ZackHarrington/PCB-Projects/Billy-Bass-Board/Documentation/DC_motor_circuits_notes_2up.pdf

# Basic DC Motor Circuits

Living with the Lab
Gerald Recktenwald
Portland State University
gerry@pdx.edu
LWTL: DC Motor | 2

### DC Motor Learning Objectives

- Explain the role of a snubber diode
- Describe how PWM controls DC motor speed
- Implement a transistor circuit and Arduino program for PWM control of the DC motor
- Use a potentiometer as input to a program that controls fan speed

What is a snubber diode
and why should I care?

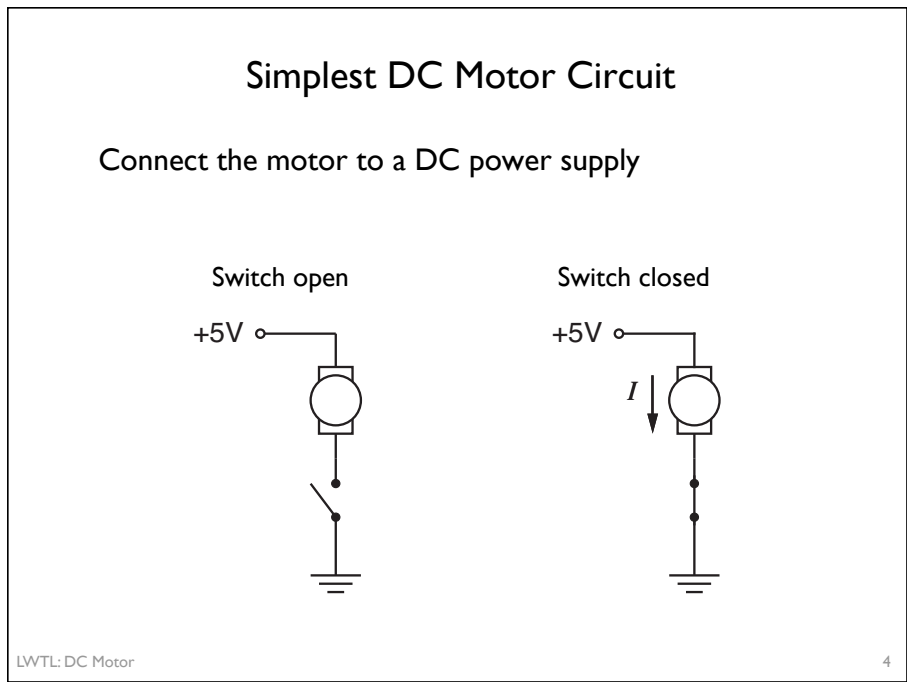
[picture p16: figure]
LWTL: DC Motor; Simplest DC Motor Circuit; Connect the motor to a DC power supply; Switch open; Switch closed

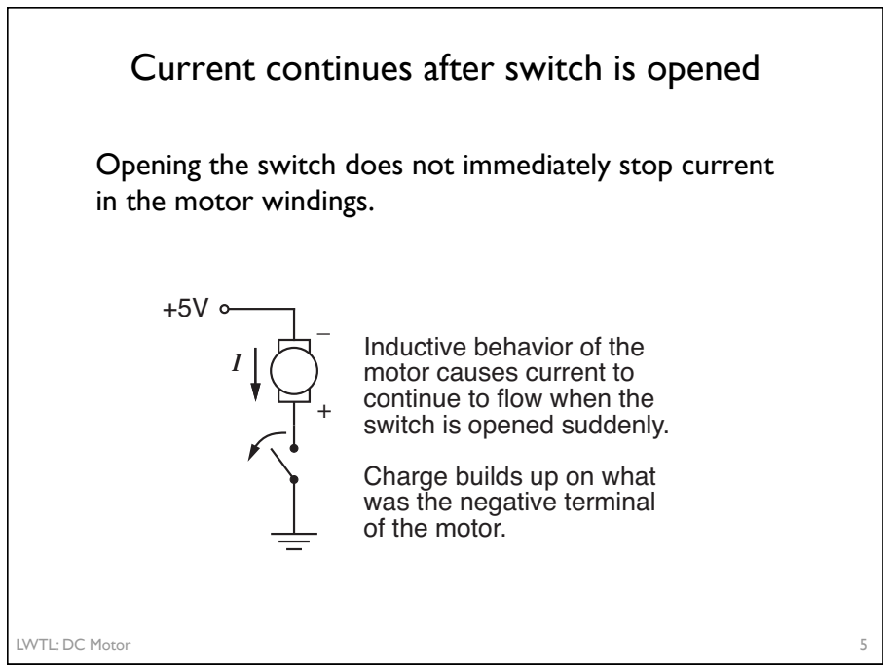
[picture p17: figure]
LWTL: DC Motor; in the motor windings.; – Inductive behavior of the motor causes current to continue to flow when the switch is opened suddenly. Charge builds up on what was the negative terminal of the motor.

### Current continues after switch is opened

Opening the switch does not immediately stop current

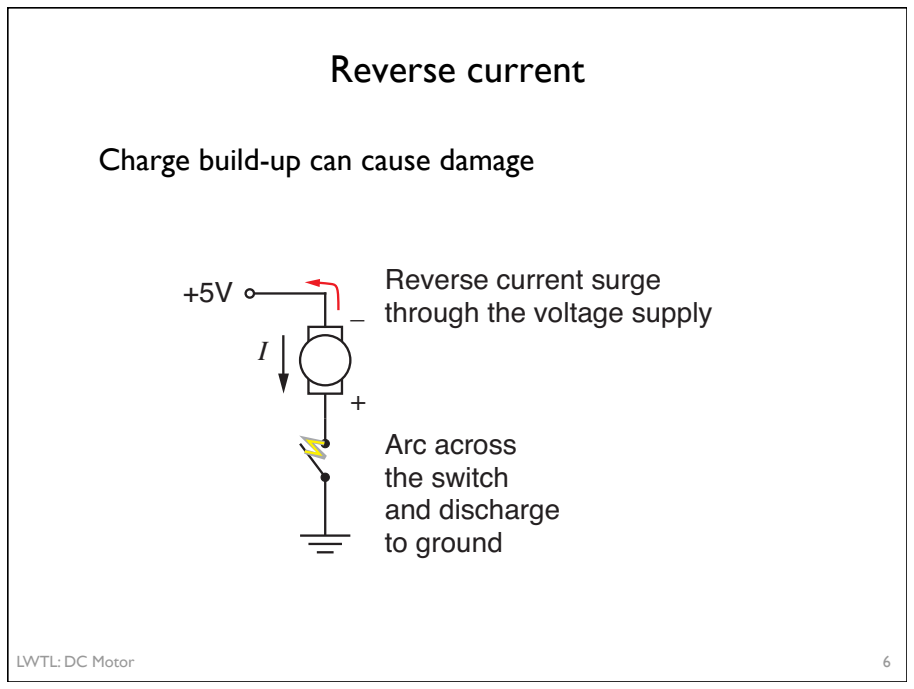
[picture p18: figure]
LWTL: DC Motor; Reverse current; Charge build-up can cause damage; Arc across the switch and discharge to ground; Reverse current surge through the voltage supply

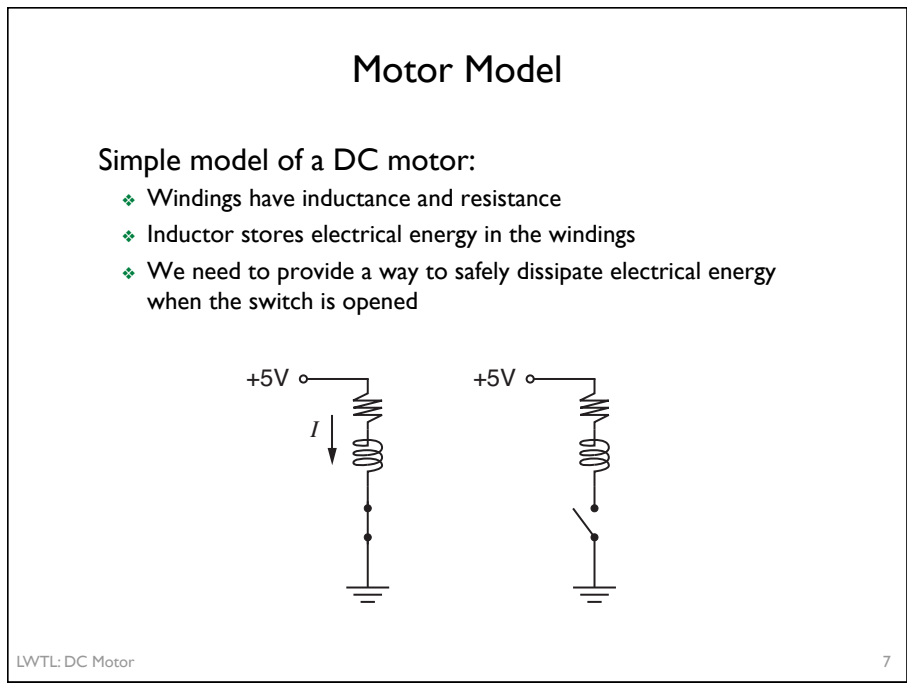
[picture p19: figure]
LWTL: DC Motor; Motor Model; Simple model of a DC motor:; when the switch is opened

❖ Windings have inductance and resistance
❖ Inductor stores electrical energy in the windings
❖ We need to provide a way to safely dissipate electrical energy

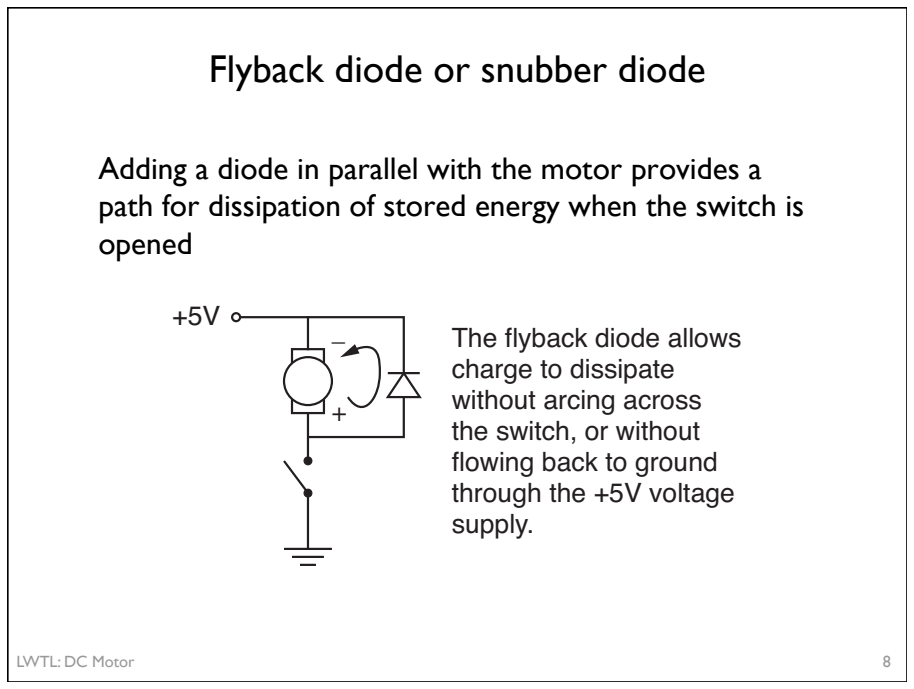
[picture p20: figure]
LWTL: DC Motor; Flyback diode or snubber diode; opened; The flyback diode allows charge to dissipate without arcing across the switch, or without flowing back to ground through the +5V voltage supply.

Adding a diode in parallel with the motor provides a path for dissipation of stored energy when the switch is

Pulse-width modulation (PWM) for DC motor speed control

LWTL: DC Motor | 10

### Controlling DC Motor Speed

The voltage supplied to a DC motor controls its speed

Arduino cannot supply variable DC output
❖ Arduino lacks a true analog output
❖ Use Pulse-width modulation (PWM) to simulate a variable DC supply voltage
❖ PWM is a common technique for supplying variable power levels to “slow” electrical devices such as resistive loads, LEDs, and DC motors
❖ Arduino Uno has 6 PWM pins: Digital I/O pins 3, 5, 6, 9,10, and 11

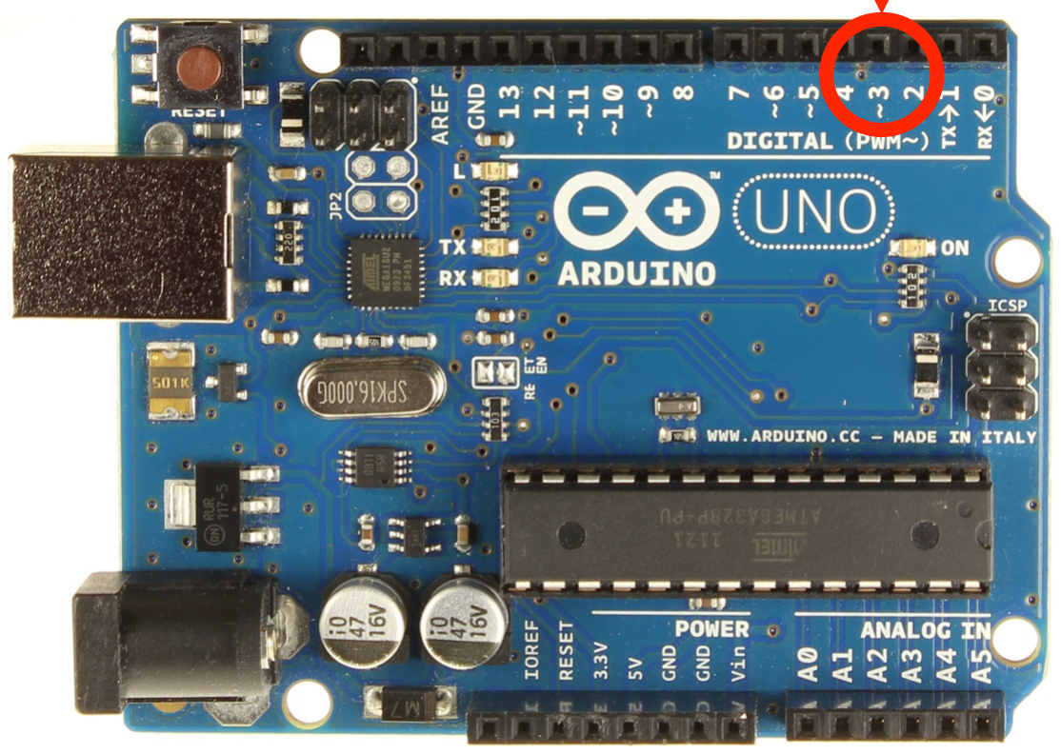
[picture p21: figure]

LWTL: DC Motor | 11

### Arduno Uno has 6 PWM pins

Look for the ~ prefix on the digital pin label, e.g. ~3

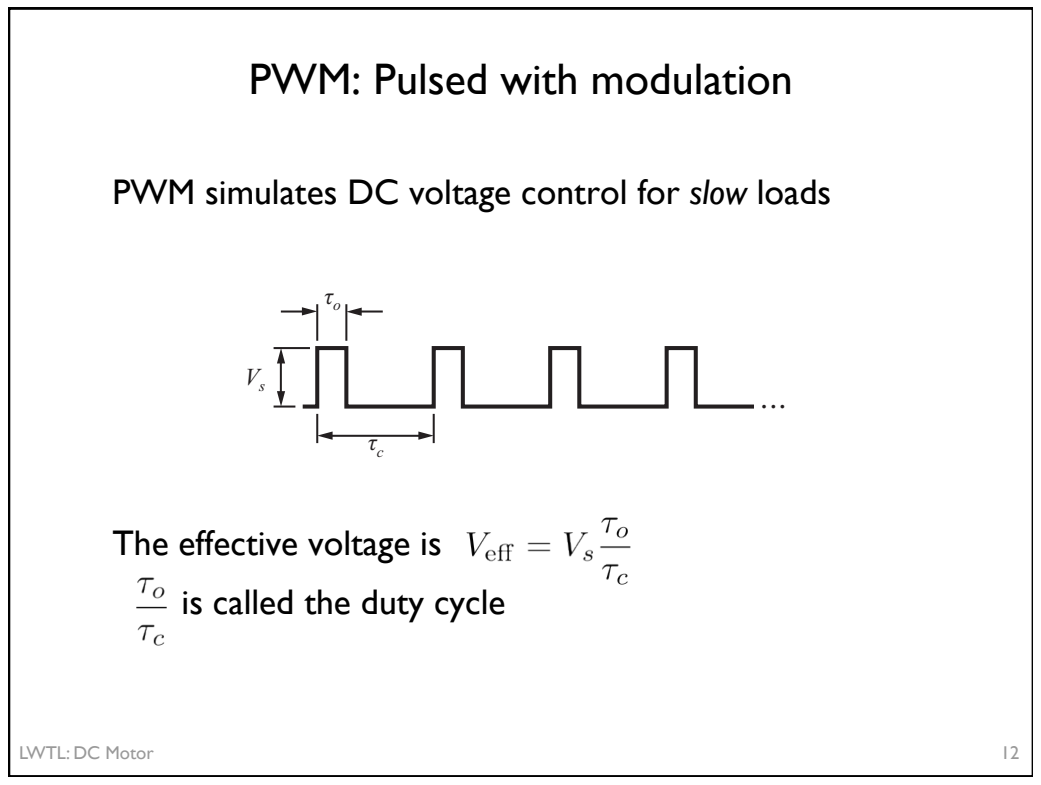
[picture p22: figure]
LWTL: DC Motor; PWM: Pulsed with modulation; The effective voltage is is called the duty cycle

PWM simulates DC voltage control for slow loads

LWTL: DC Motor | 13

### Arduino PWM commands

Configure the output pin:

Set the duty cycle

The duty cycle is an 8 bit value:
0 ≤ duty_cycle ≤255
PWM_pin = ... ; | // | one of 3, 5, 6, 9, 10, 11

void setup() {
pinMode( PWM_pin, OUTPUT);
}

void loop() {
int duty_cycle = 150; | // | between 0 and 255

analogWrite( PWM_pin, duty_cycle );
}

Using a transistor to switch the load

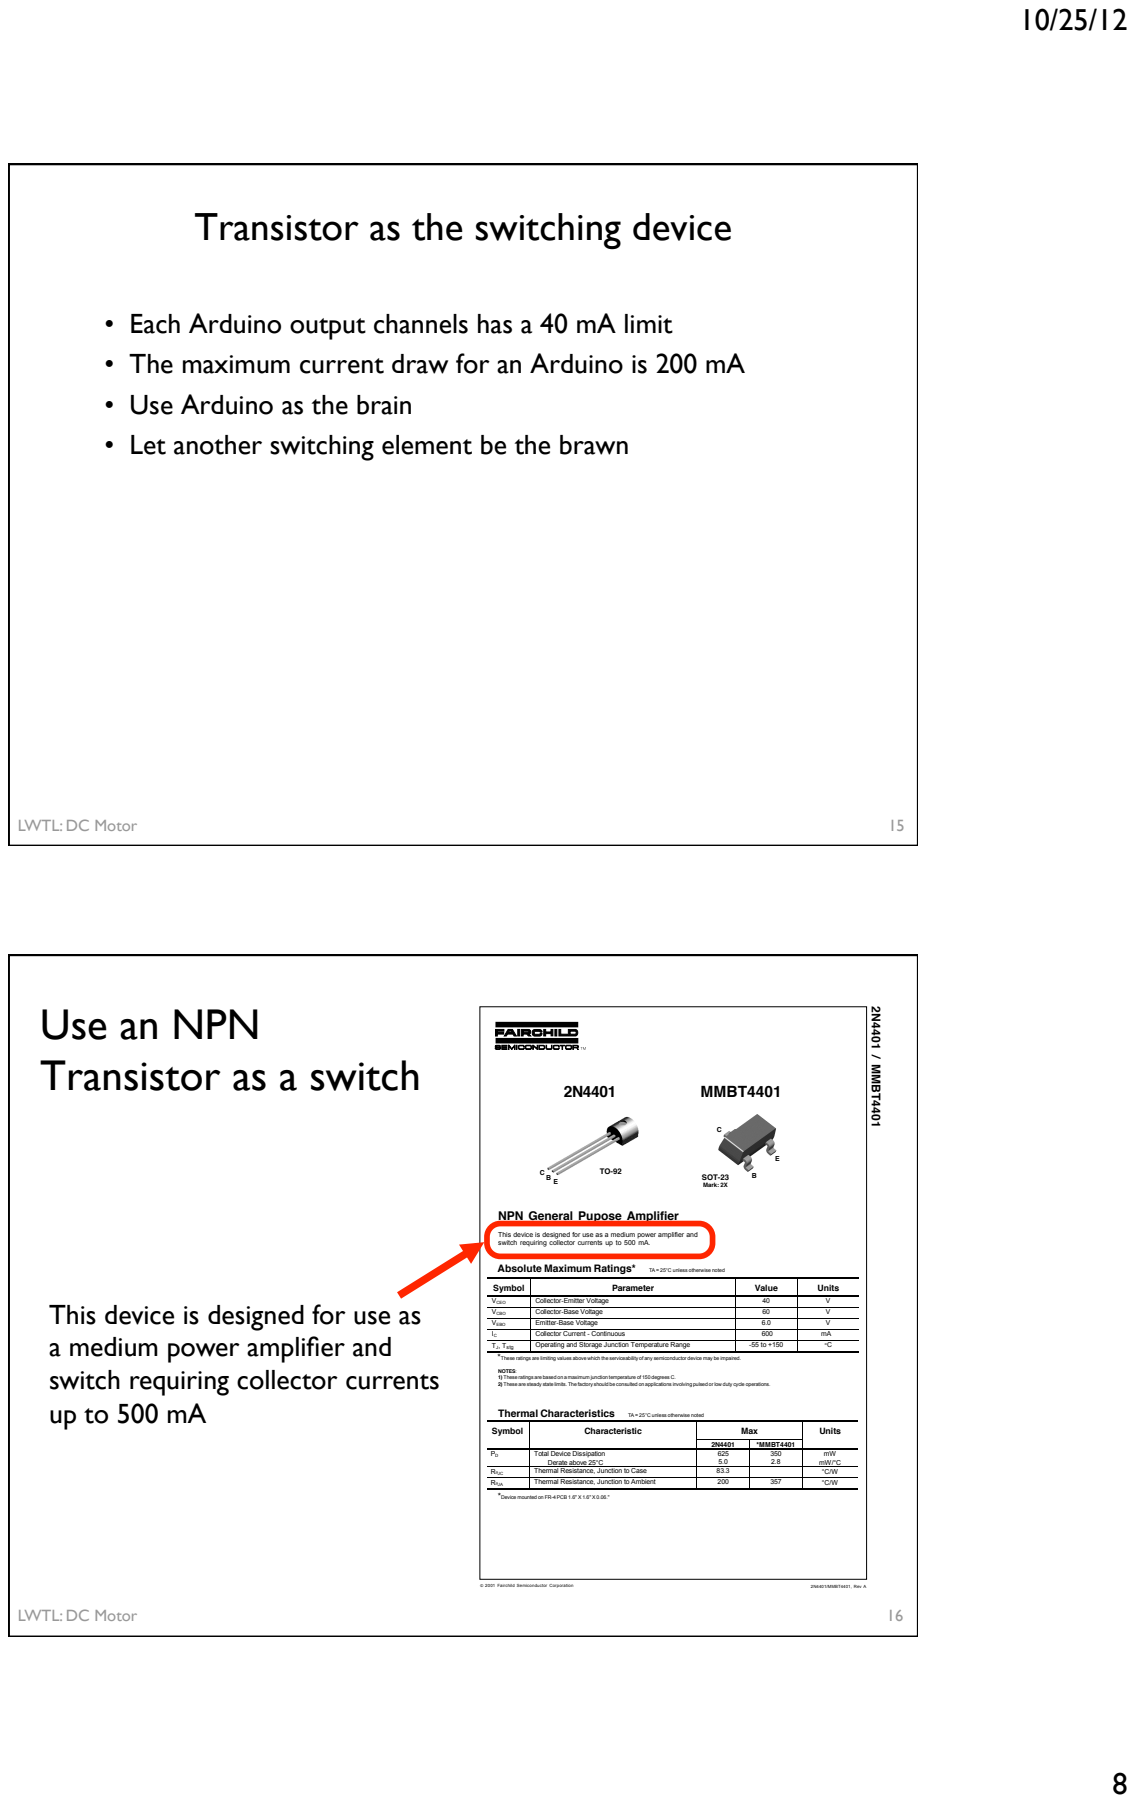
[picture p23: page 8]
LWTL: DC Motor; MMBT4401; Absolute Maximum Ratings*; TA = 25°C unless otherwise noted; Symbol; Parameter; Value; Units; VCEO; Collector-Emitter Voltage; VCBO; Collector-Base Voltage; VEBO; Emitter-Base Voltage; Collector Current - Continuous; TJ, Tstg; Operating and Storage Junction Temperature Range; Thermal Characteristics; Characteristic; Max; *MMBT4401; Total Device Dissipation; Derate above 25°C; Thermal Resistance, Junction to Case; Thermal Resistance, Junction to Ambient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

Transistor as the switching device

• Each Arduino output channels has a 40 mA limit
• The maximum current draw for an Arduino is 200 mA
• Use Arduino as the brain
• Let another switching element be the brawn

Use an NPN
Transistor as a switch

NPN General Pupose Amplifier

This device is designed for use as a medium power amplifier and
switch requiring collector currents up to 500 mA.

This device is designed for use as
a medium power amplifier and
switch requiring collector currents

*These ratings are limiting values above which the serviceability of any semiconductor device may be impaired.

NOTES:
1) These ratings are based on a maximum junction temperature of 150 degrees C.
2) These are steady state limits. The factory should be consulted on applications involving pulsed or low duty cycle operations.

*Device mounted on FR-4 PCB 1.6" X 1.6" X 0.06."

" 2001 Fairchild Semiconductor Corporation

LWTL: DC Motor

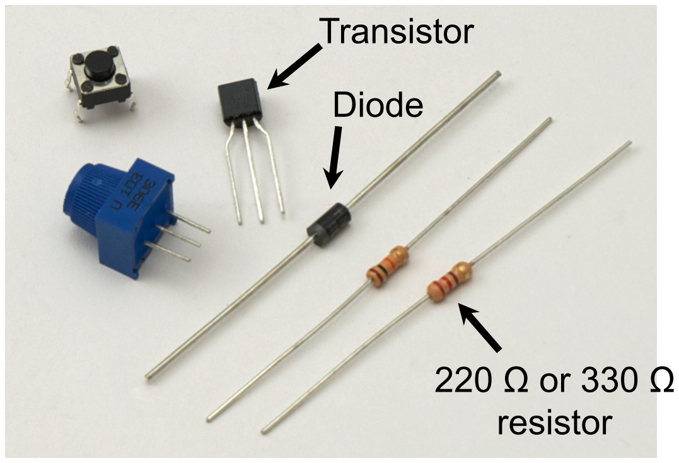
[picture p24: figure]
Transistor; Diode; 220 Ω or 330 Ω resistor

LWTL: DC Motor | 17

## Electronic components in the fan kit

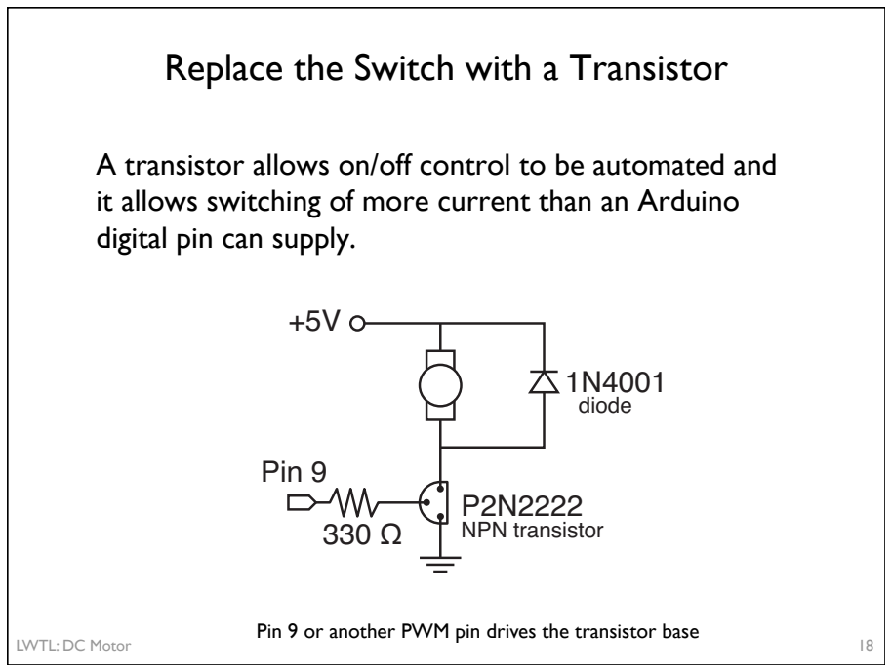
[picture p25: figure]
LWTL: DC Motor; Replace the Switch with a Transistor; digital pin can supply.; Pin 9 330 Ω; 1N4001 diode; NPN transistor

A transistor allows on/off control to be automated and it allows switching of more current than an Arduino

Pin 9 or another PWM pin drives the transistor base

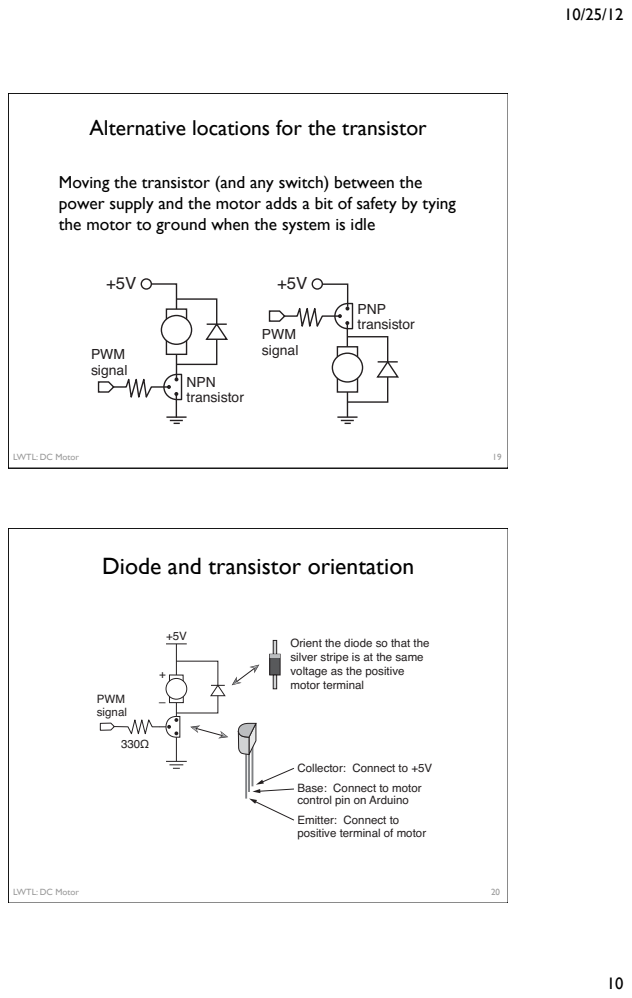
[picture p26: page 10]
LWTL: DC Motor; PWM; signal; NPN; transistor; PNP transistor; PWM signal; motor terminal + –

Alternative locations for the transistor

Moving the transistor (and any switch) between the
power supply and the motor adds a bit of safety by tying
the motor to ground when the system is idle

Diode and transistor orientation

Orient the diode so that the
silver stripe is at the same
voltage as the positive

Collector: Connect to +5V
Base: Connect to motor
control pin on Arduino
Emitter: Connect to
positive terminal of motor

LWTL: DC Motor | 21

### Arduno Uno has 5 PWM pins

Look for the ~ prefix on the digital pin label, e.g. ~3

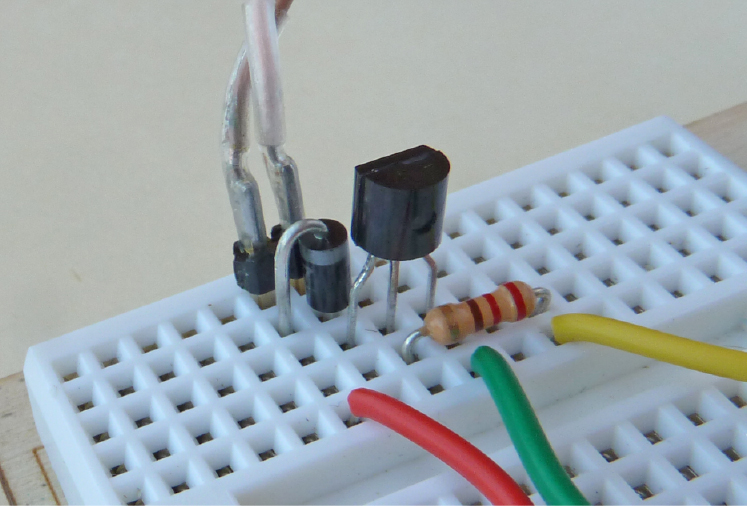
[picture p27: figure]

LWTL: DC Motor | 22

## DC Motor Circuit on tiny breadboard

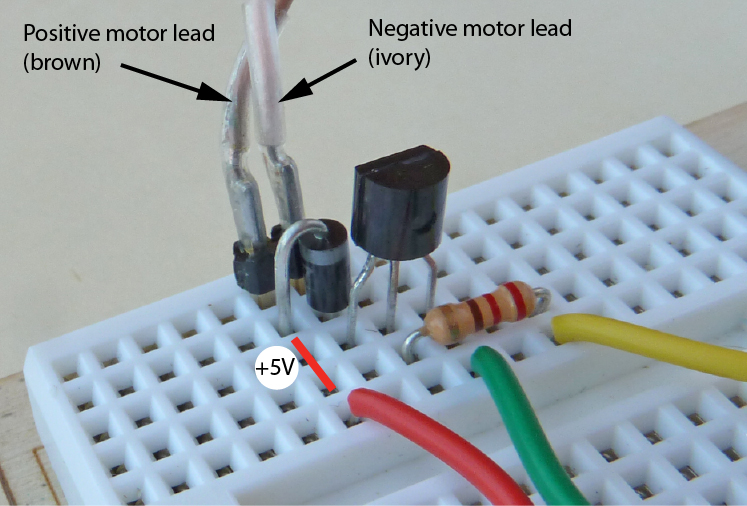
[picture p28: figure]

LWTL: DC Motor | 23

## +5V connections

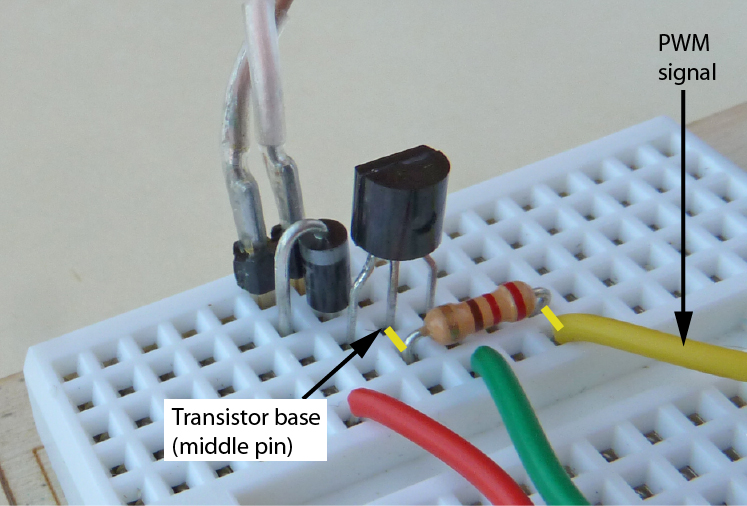
[picture p29: figure]

LWTL: DC Motor | 24

## PWM signal is connected to transistor base

LWTL: DC Motor | 25

### Arduino program to spin the DC Motor

// | spin_DC_motor.ino | Use PWM to control DC motor speed
int motorPin = 3; | // Pin 3 has PWM, connected it to the DC motor

void setup() {
pinMode(motorPin, OUTPUT); | // Set motor pin to output mode
}
void loop() | {
analogWrite(motorPin, 150); | // Motor at 150/255 of full speed
| delay(1000);
analogWrite(motorPin, 250); | // Motor at 250/255 of full speed
| delay(1000);
}

Code is in spin_DC_motor.ino

User input to control fan speed

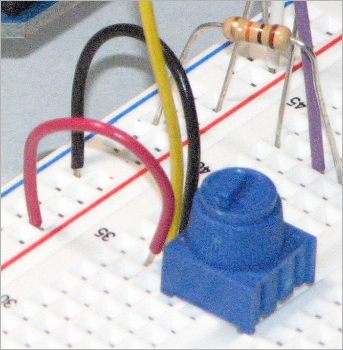
[picture p30: figure]

LWTL: DC Motor | 27

### Adjust fan speed with potentiometer input

Use the potentiometer circuit from the earlier analog input exercise

LWTL: DC Motor | 28

### Adjust fan speed with potentiometer input

// | File: | DC_motor_speed_control.pde
//
// | Use potentiometer input to set the speed of a DC motor
// | Output to the motor is PWM
int motorPin = 3; | // pin connected to the DC motor
int potPin = 1; | // analog input connected to the potentiometer

void setup()
{
pinMode(motorPin, OUTPUT);
}

void loop()
{
int PWMoutput, potReading;

potReading = analogRead(potPin);
PWMoutput = map(potReading, 0, 1023, 0, 255 ); analogWrite(motorPin, PWMoutput);
}

Code is in DC_motor_speed_control.ino

LWTL: DC Motor | 29

### Adjust fan speed with potentiometer input

Each time through the loop:
❖ Read the voltage at the potentiometer wiper
- Input value is a 10-bit integer: 0 ≤ potReading ≤ 1023
❖ Scale the 10-bit value (max 1023) to an 8-bit value (max 255)
- PWMoutput = map( potReading, 0, 1023, 0, 255 );

❖ Update the PWM signal
- analogWrite(motorPin, PWMoutput);

void loop() {

int PWMoutput, potReading;

potReading = analogRead(potPin);
PWMoutput = map(potReading, 0, 1023, 0, 255 ); analogWrite(motorPin, PWMoutput);
}

range for
potReading

range for
PWMoutput
