ZackHarrington/PCB-Projects/Greek-Keyboard/Design-Files/Keycap-Stickers.docx

Αccent

Shift

Shift

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
