ZackHarrington/PCB-Projects/Billy-Bass-Board/Design-Files/Billy-Bass-Board_V3.0.0_3D_model_top.png

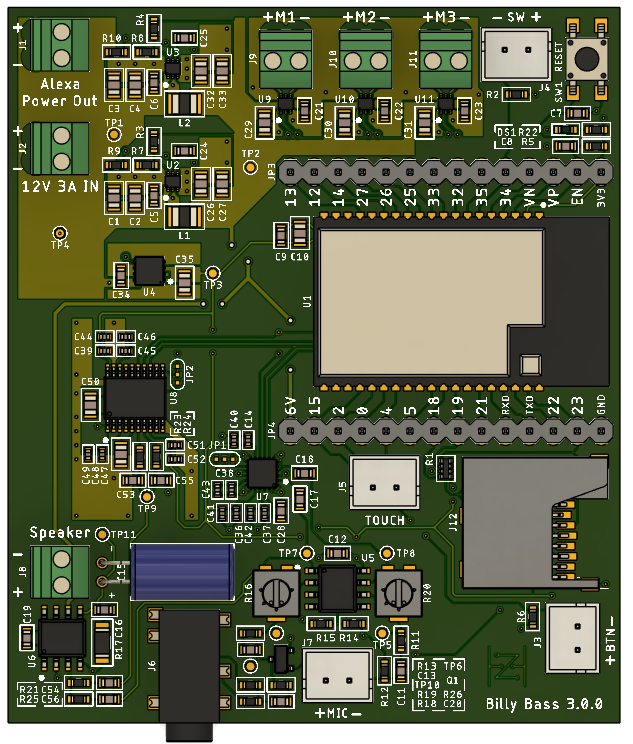
Billy-Bass-Board/Design-Files/Billy-Bass-Board_V3.0.0_3D_model_top.png
