ZackHarrington/PCB-Projects/Greek-Keyboard/Design-Files/Greek-Keyboard-V1.0.0.png

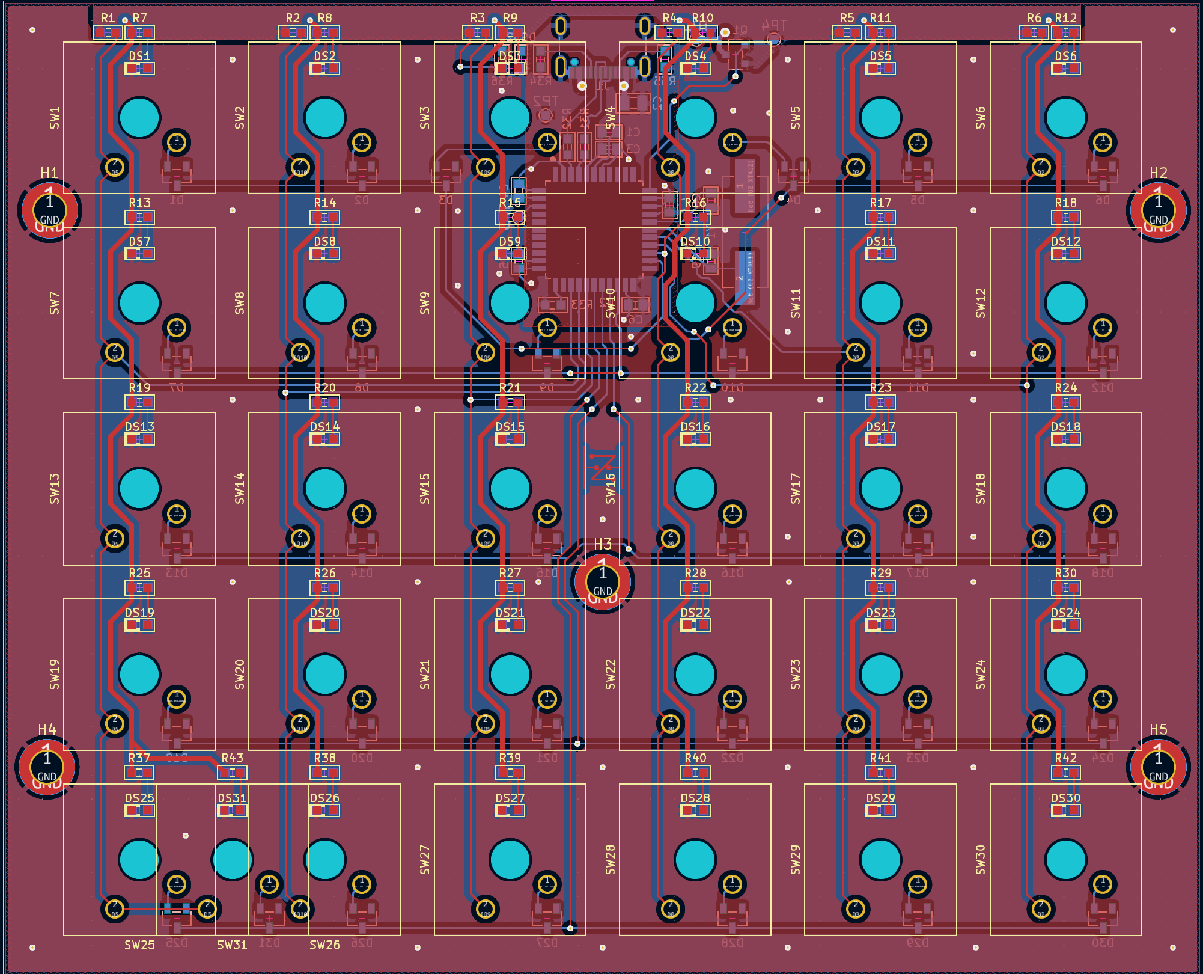
Greek-Keyboard/Design-Files/Greek-Keyboard-V1.0.0.png
