ZackHarrington/PCB-Projects/Greek-Keyboard/Documentation/cherry-mx-dimensions.jpg

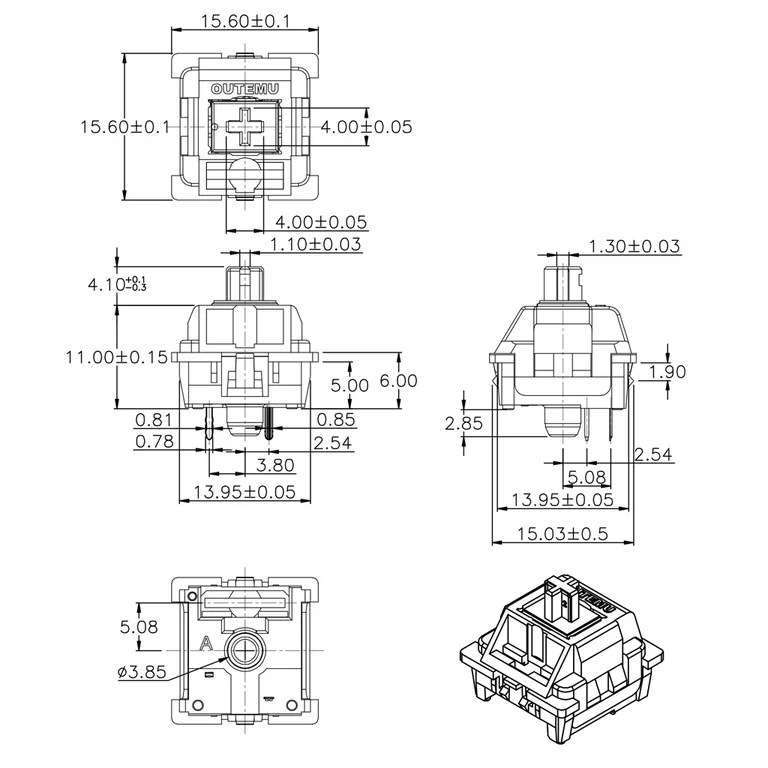
Greek-Keyboard/Documentation/cherry-mx-dimensions.jpg
