ZackHarrington/PCB-Projects/Christmas-Snow-Globe/Design-Files/Christmas-Snow-Globe_Battery_Cover.stl

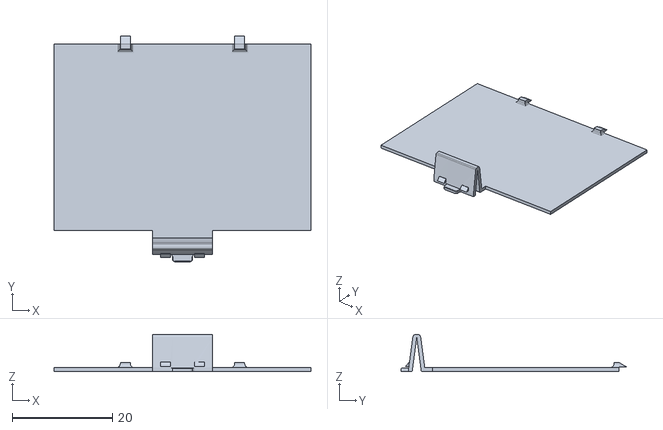
[picture p34: CAD file, 2024-01-09]
Christmas-Snow-Globe/Design-Files/Christmas-Snow-Globe_Battery_Cover.stl
51.2 x 45.0 x 7.40
