ZackHarrington/PCB-Projects/Greek-Keyboard/Design-Files/Case-Bottom.stl

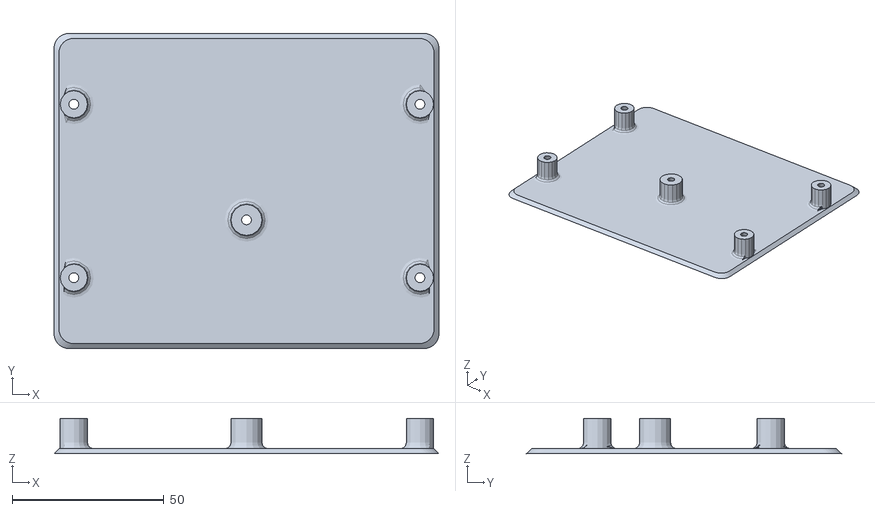
[picture p35: CAD file, 2024-12-28]
Greek-Keyboard/Design-Files/Case-Bottom.stl
126.8 x 103.8 x 11.6
