ZackHarrington/PCB-Projects/Christmas-Snow-Globe/Design-Files/Christmas-Snow-Globe_Stand_Bottom.stl

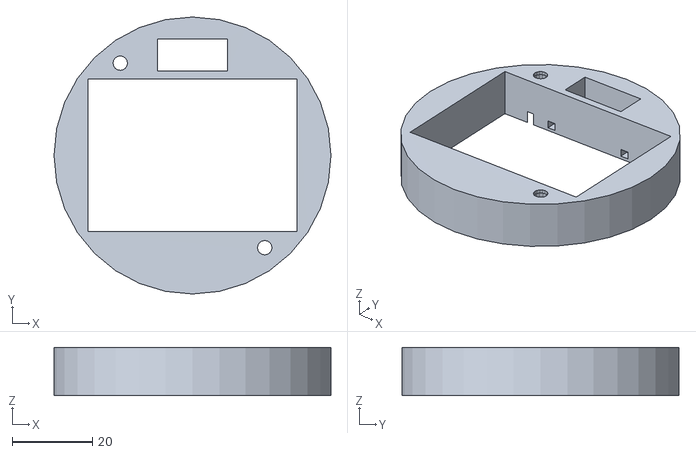
[picture p36: CAD file, 2024-01-09]
Christmas-Snow-Globe/Design-Files/Christmas-Snow-Globe_Stand_Bottom.stl
69.0 x 69.0 x 12.0
