ZackHarrington/PCB-Projects/Greek-Keyboard/Design-Files/Case-Top.stl

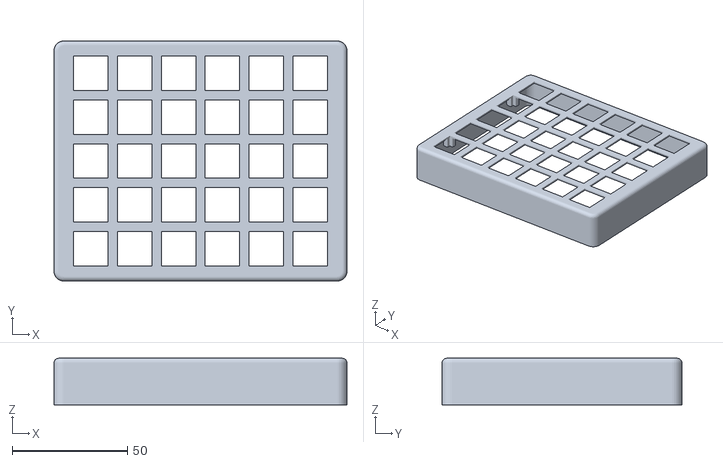
[picture p37: CAD file, 2024-12-28]
Greek-Keyboard/Design-Files/Case-Top.stl
127.2 x 104.2 x 20.2
