ZackHarrington/PCB-Projects/Christmas-Snow-Globe/Design-Files/Christmas-Snow-Globe_Tree.stl

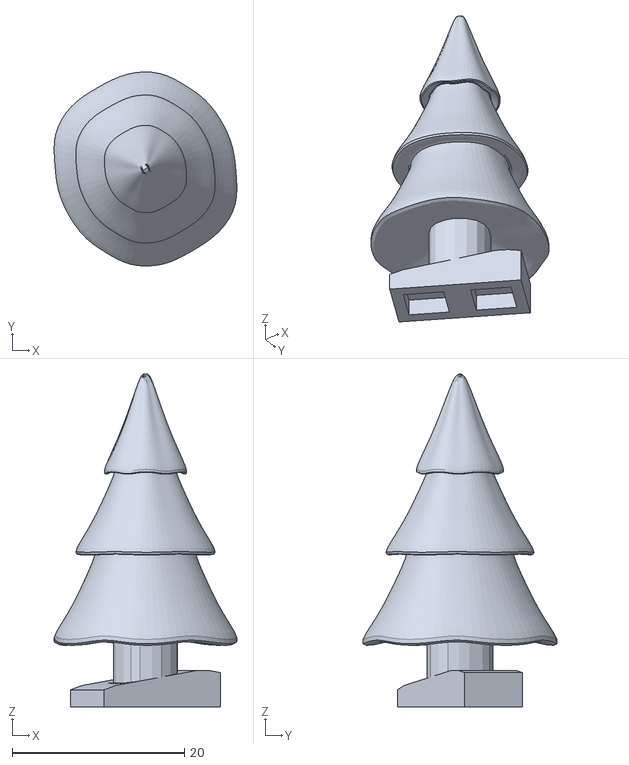
[picture p38: CAD file, 2024-01-09]
Christmas-Snow-Globe/Design-Files/Christmas-Snow-Globe_Tree.stl
21.2 x 22.6 x 38.7
