ZackHarrington/PCB-Projects/Christmas-Snow-Globe/Design-Files/Christmas-Snow-Globe_Stand_Top.stl

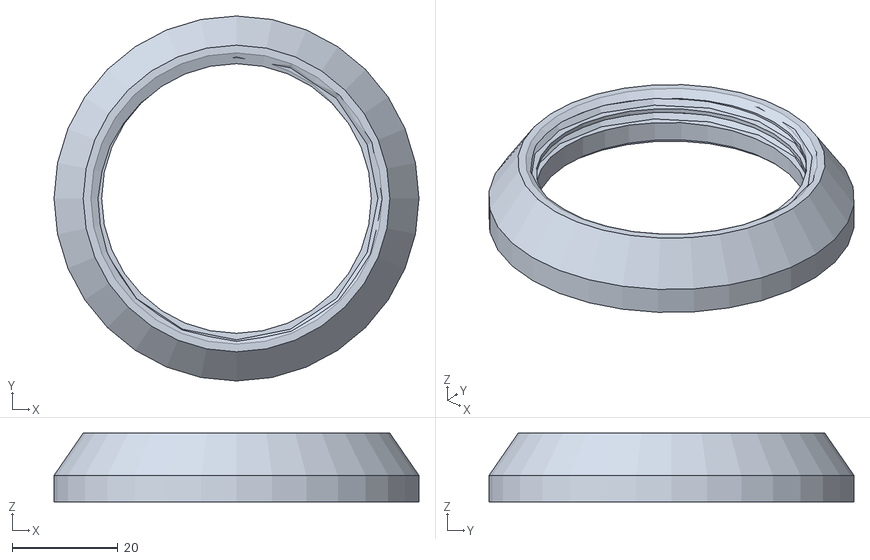
[picture p39: CAD file, 2024-01-09]
Christmas-Snow-Globe/Design-Files/Christmas-Snow-Globe_Stand_Top.stl
69.0 x 69.0 x 13.0
