ZackHarrington/PCB-Projects/(list of files, cad)

Other CAD files:
Christmas-Snow-Globe/Design-Files/Christmas-Snow-Globe v33.f3z
Greek-Keyboard/Design-Files/Greek-Keyboard.blend
USB-UART-Board/Design-Files/USB-UART-Board-CP2102N v37.f3z
