ZackHarrington/PCB-Projects/Billy-Bass-Board/Design-Files/Billy-Bass-Board_V3.0.0.pdf

# UART

## Page 2

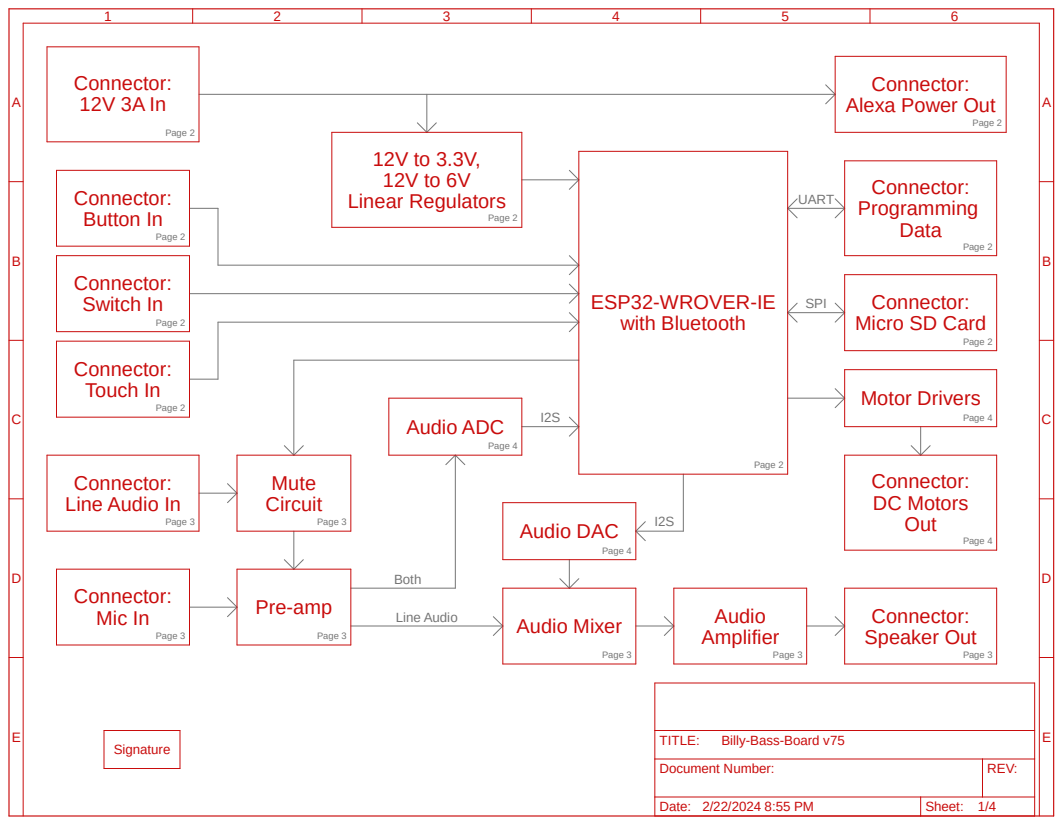
[picture p40: page 1]
Page 2; Page 4; Page 3; SPI; Line Audio; Both; ESP32-WROVER-IE with Bluetooth; Connector: 12V 3A In; Connector: Speaker Out; Connector: DC Motors Out; 12V to 3.3V, 12V to 6V Linear Regulators; Motor Drivers; Audio Mixer; Audio; Amplifier; Connector: Programming Data; Connector:; Mic In; Pre-amp; Connector: Touch In; Connector: Switch In; Connector: Button In; Audio DAC; Audio ADC; Mute Circuit; TITLE:; Signature

Connector:
Alexa Power Out

Micro SD Card

Line Audio In

Billy-Bass-Board v75

Document Number: | REV:

Date: 2/22/2024 8:55 PM | Sheet: 1/4

2E2 Micro SD Connector | 2D2 Button Connector

/ 50V

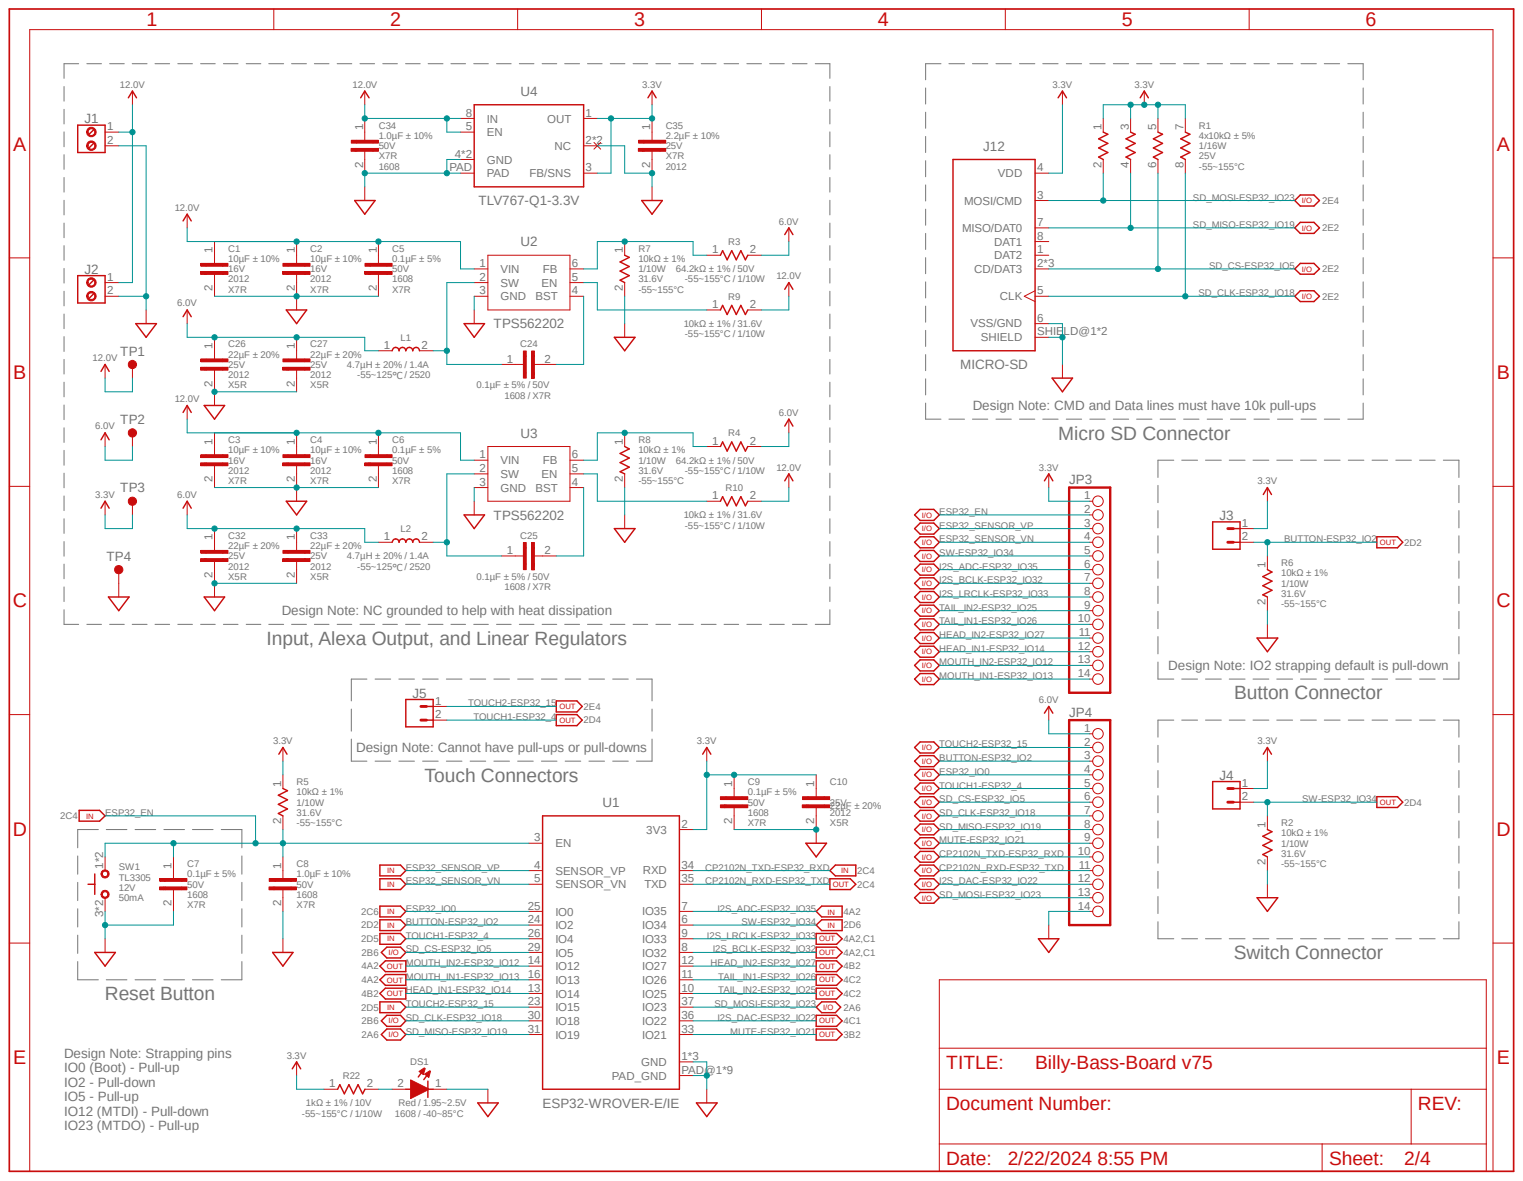
[picture p41: page 2]

2 U2 VIN 1 EN 5 GND 3 FB 6 SW 2 BST 4 U3 VIN 1 EN 5 GND 3 FB 6 SW 2 BST 4

Design Note: CMD and Data lines must have 10k pull-ups

Input, Alexa Output, and Linear Regulators

Design Note: IO2 strapping default is pull-down

Design Note: Cannot have pull-ups or pull-downs

Design Note: Strapping pins

## Design Note: Using 3-ring audio cable

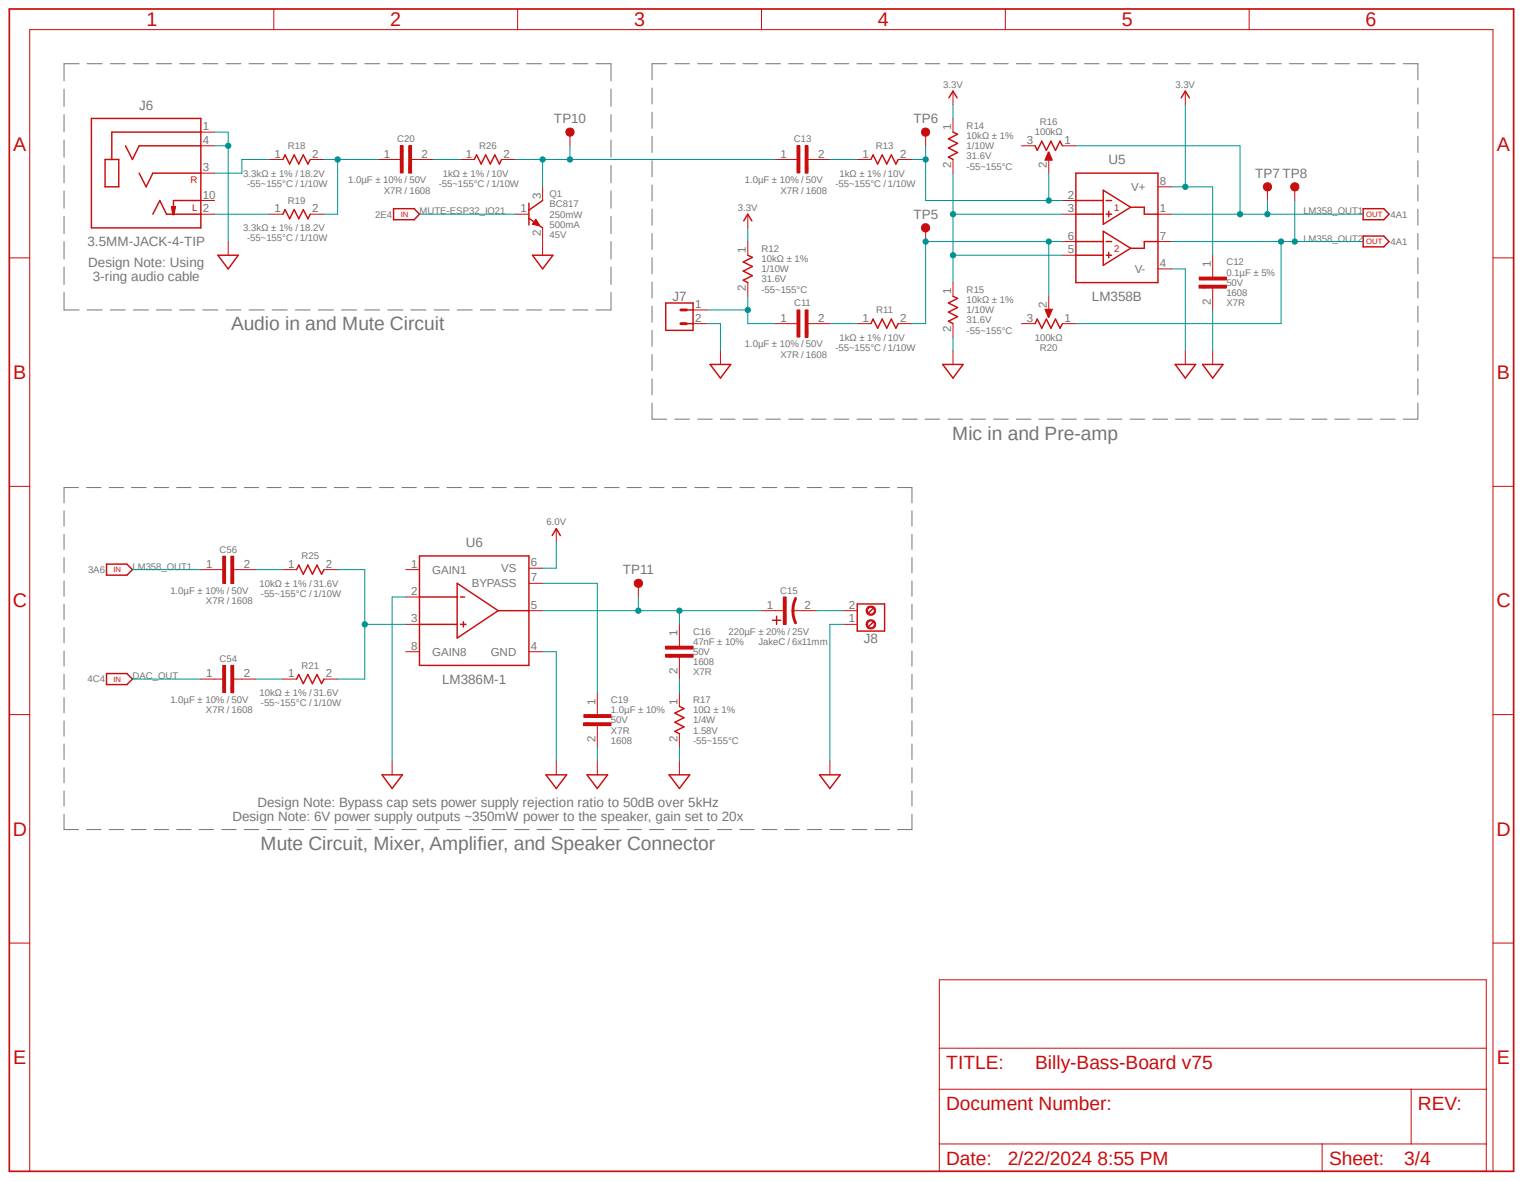
[picture p42: page 3]

Mic in and Pre-amp

GAIN8 8 | 5 BYPASS 7 VS 6 GND 4 GAIN1 1

Design Note: Bypass cap sets power supply rejection ratio to 50dB over 5kHz
Design Note: 6V power supply outputs ~350mW power to the speaker, gain set to 20x
Mute Circuit, Mixer, Amplifier, and Speaker Connector

Document Number: | REV:

# Mouth

/ 50V

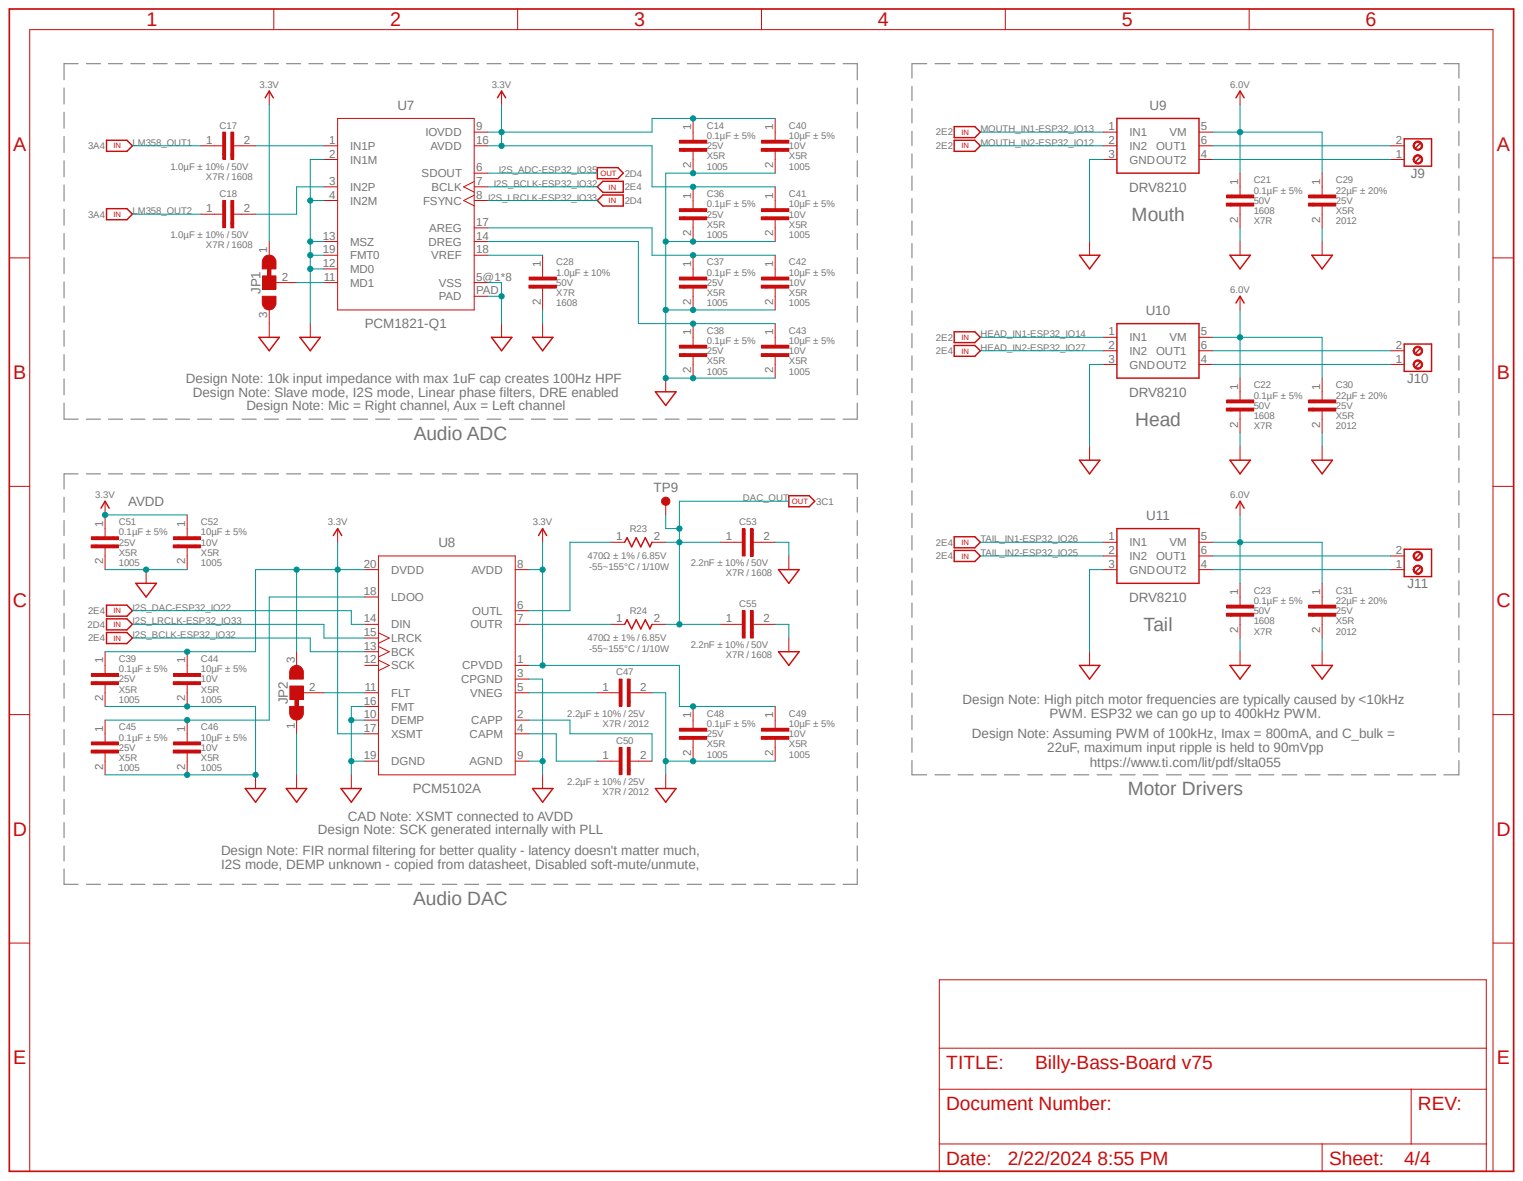
[picture p43: page 4]

Design Note: 10k input impedance with max 1uF cap creates 100Hz HPF
Design Note: Slave mode, I2S mode, Linear phase filters, DRE enabled

Design Note: Mic = Right channel, Aux = Left channel

Design Note: High pitch motor frequencies are typically caused by <10kHz

PWM. ESP32 we can go up to 400kHz PWM.

Design Note: Assuming PWM of 100kHz, Imax = 800mA, and C_bulk =

22uF, maximum input ripple is held to 90mVpp
https://www.ti.com/lit/pdf/slta055
Motor Drivers

CAD Note: XSMT connected to AVDD
Design Note: SCK generated internally with PLL

Design Note: FIR normal filtering for better quality - latency doesn't matter much,
I2S mode, DEMP unknown - copied from datasheet, Disabled soft-mute/unmute,

Document Number: | REV:
