ZackHarrington/PCB-Projects/Greek-Keyboard/Design-Files/Greek-Keyboard-V1.0.0.pdf

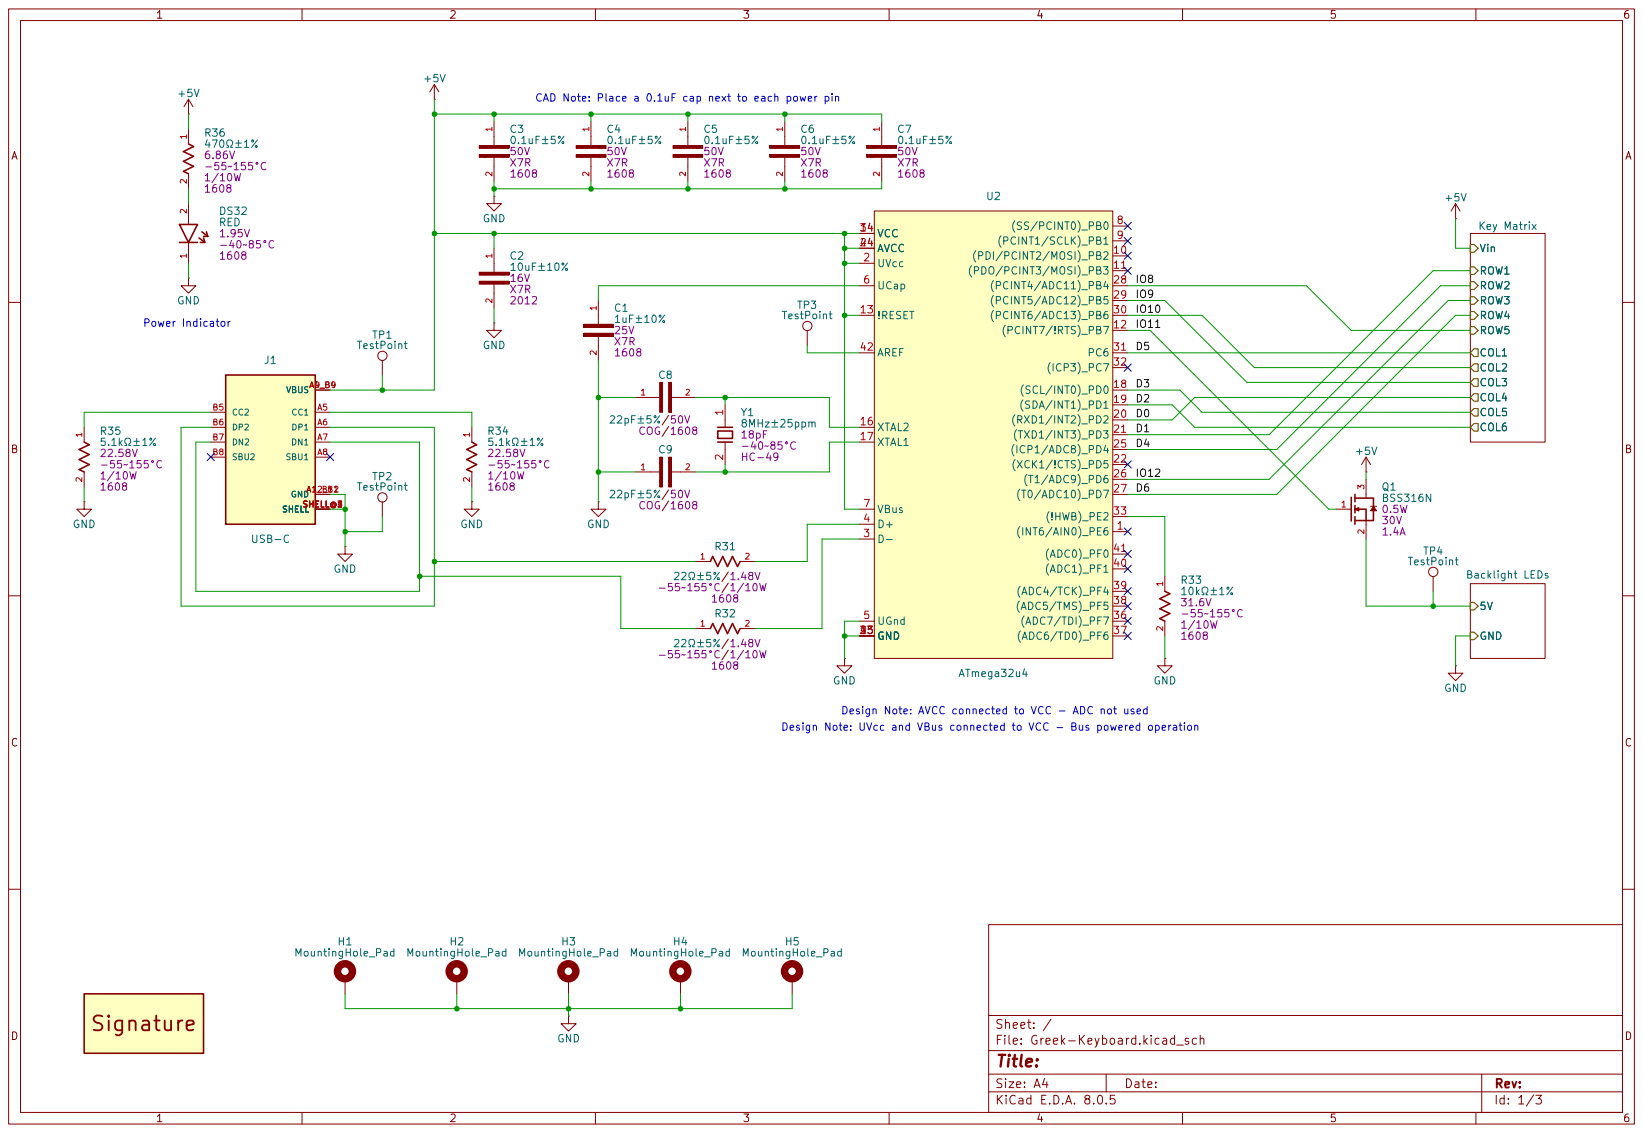
[picture p44: page 1]

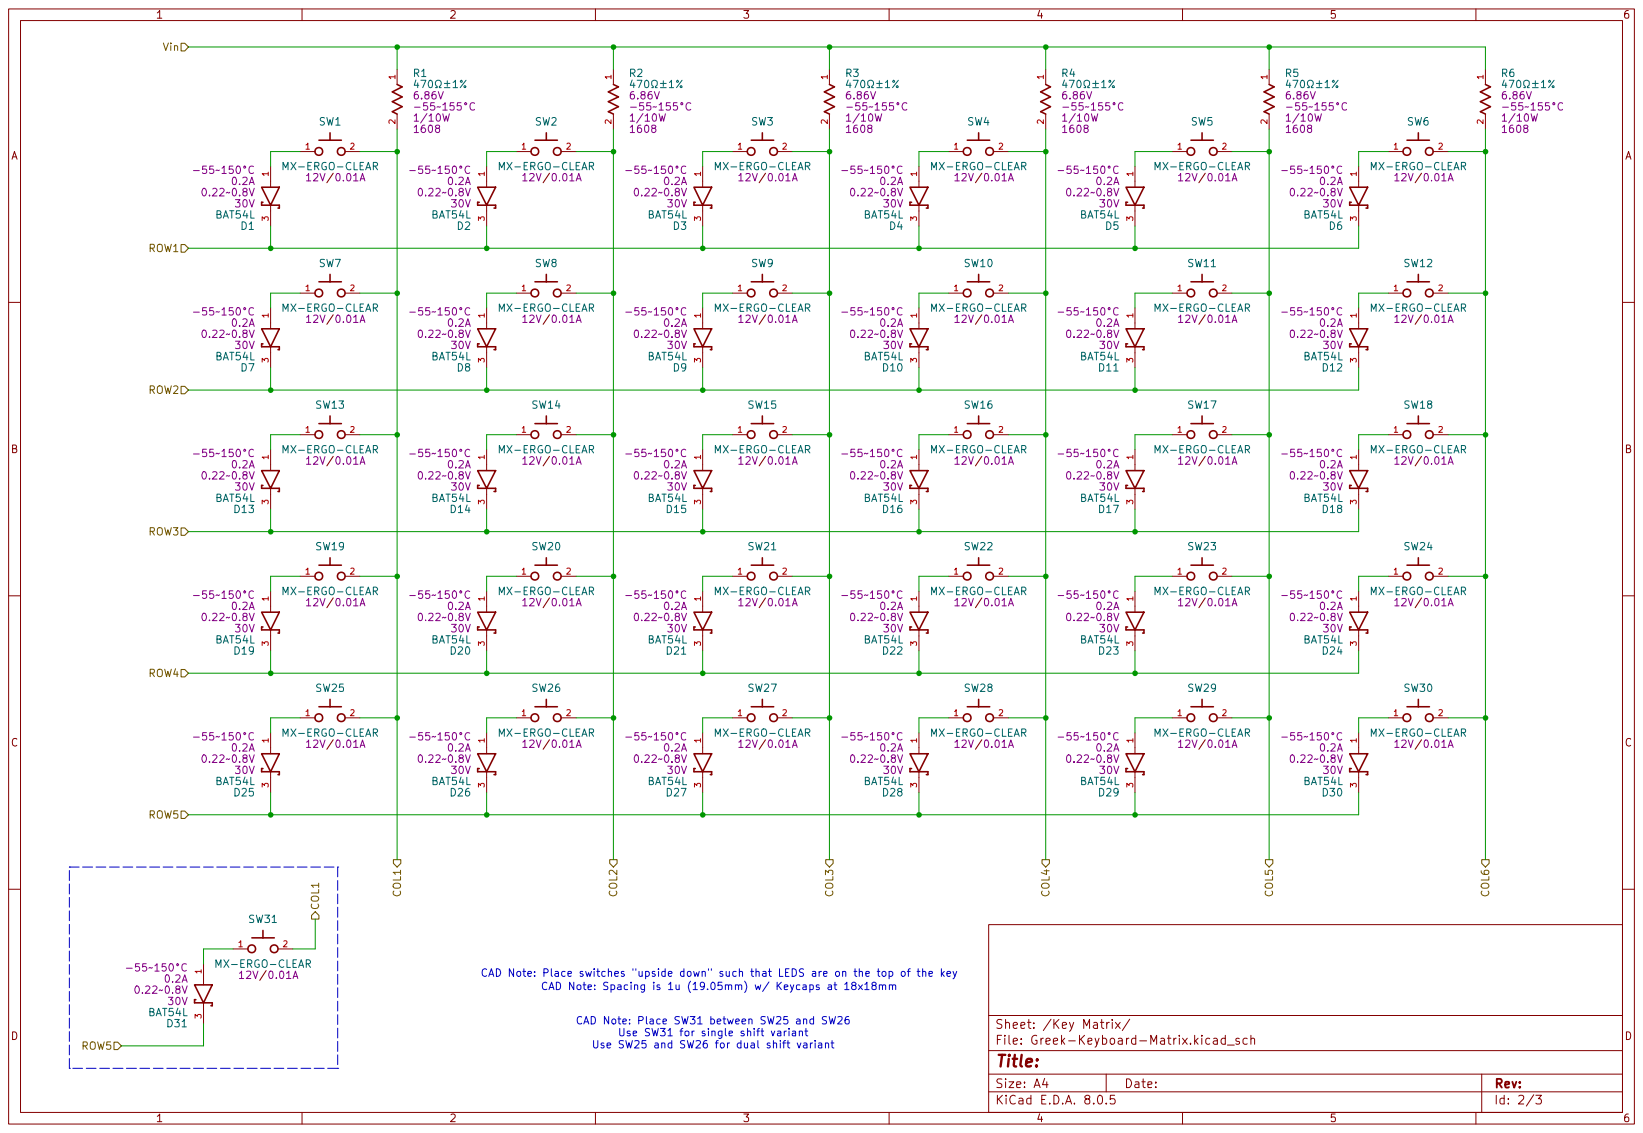
[picture p45: page 2]

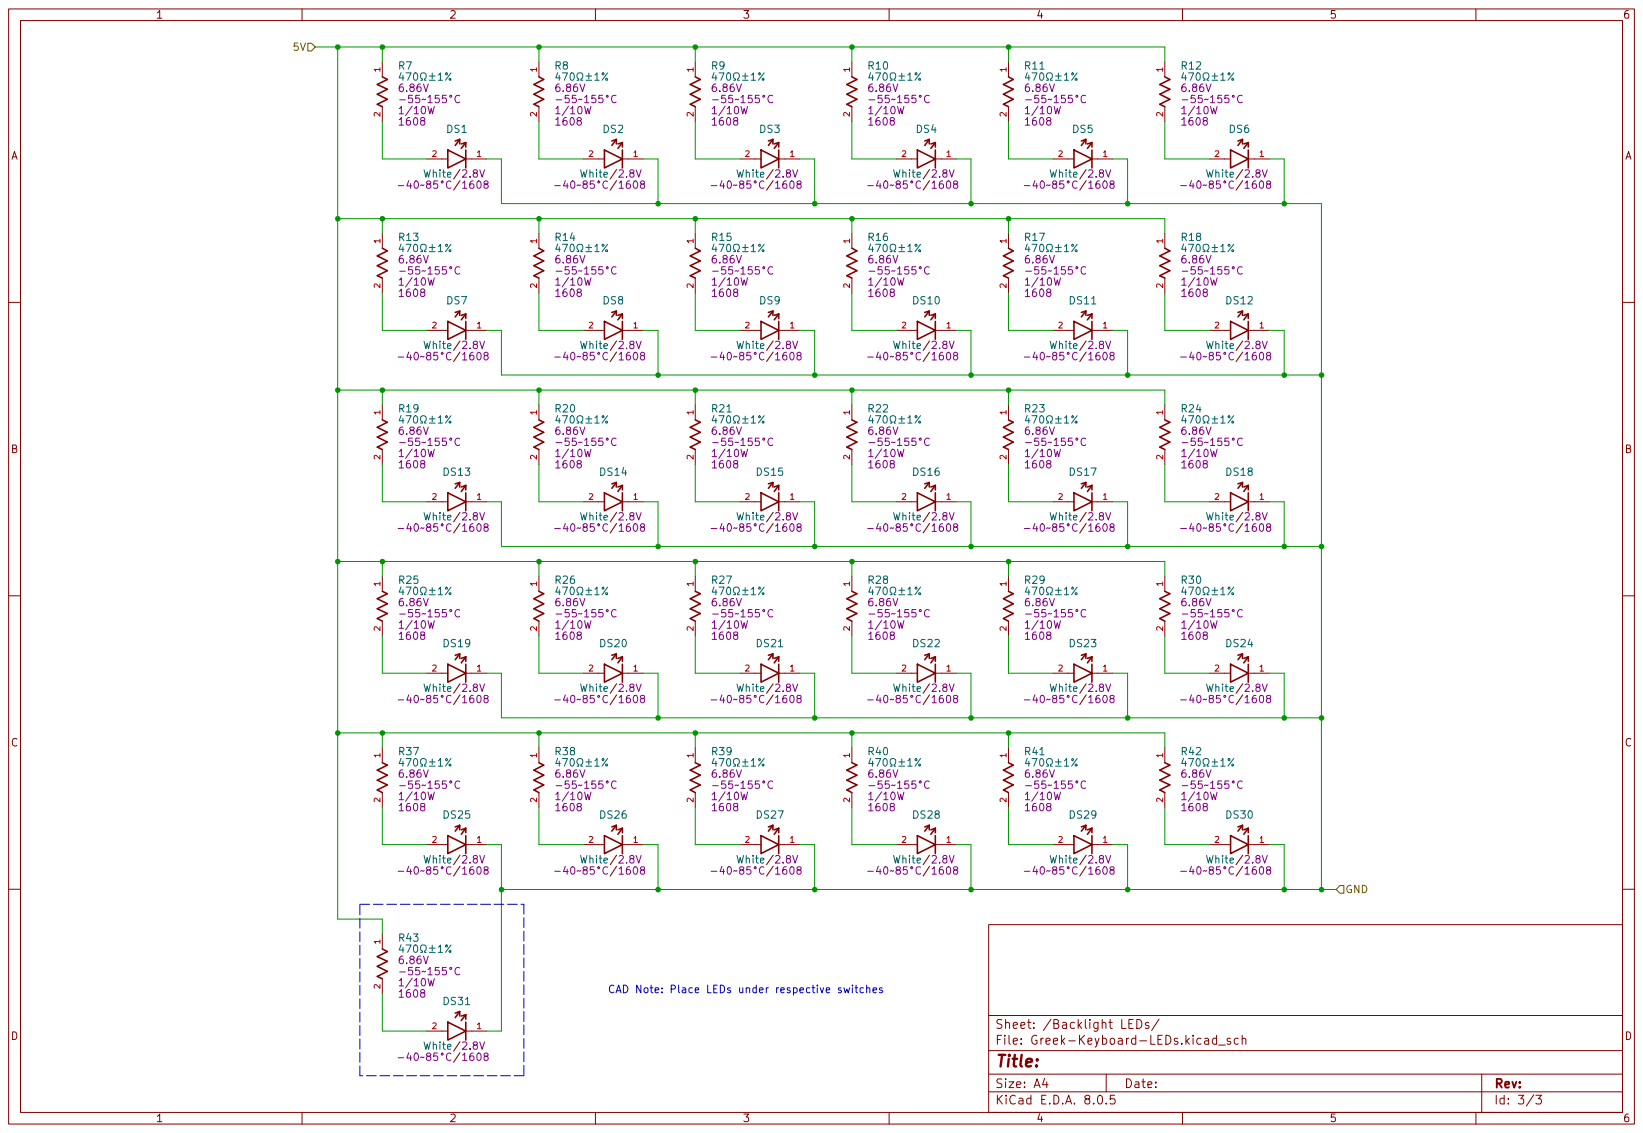
[picture p46: page 3]
