ZackHarrington/PCB-Projects/LED-Chess-Board/Design-Files/LED-Chess-Test-Board/LED-Chess-Test-Board.pdf

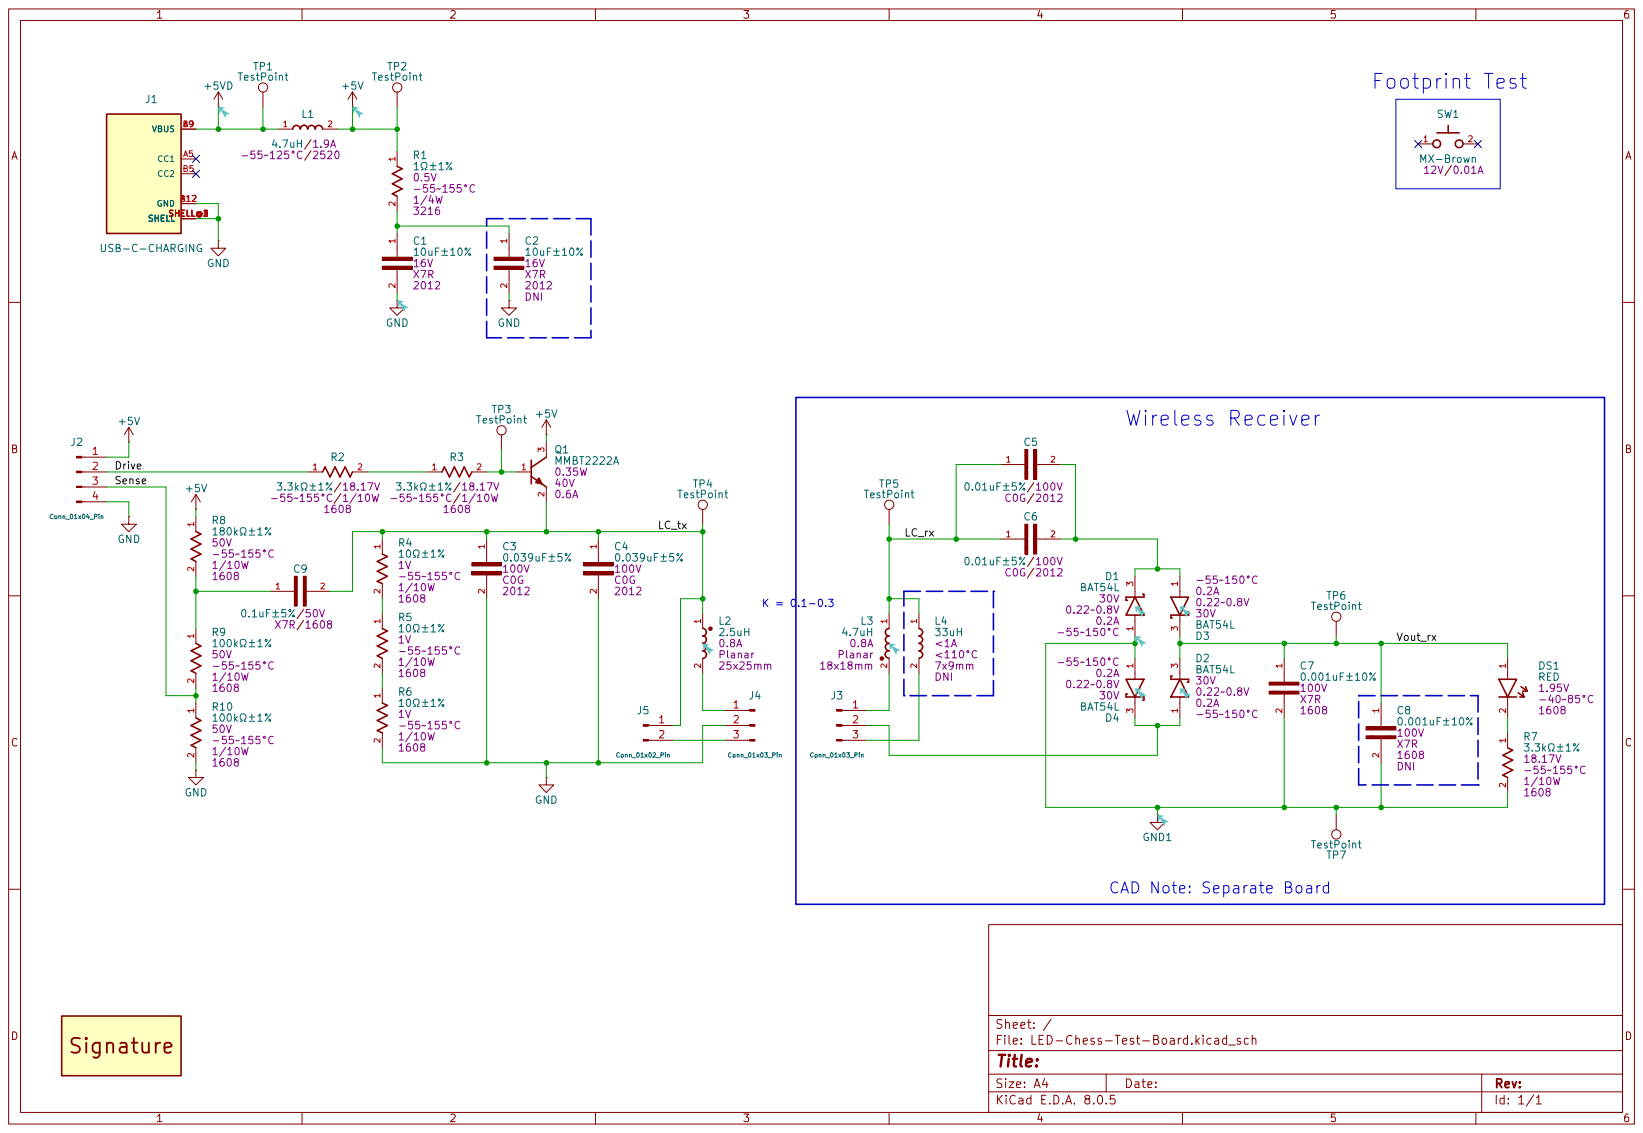
[picture p47: page 1]
