ZackHarrington/PCB-Projects/Billy-Bass-Board/Archive/Billy Bass Board v2.0.0/BillyBassBoard_2.0.0_schematic.pdf

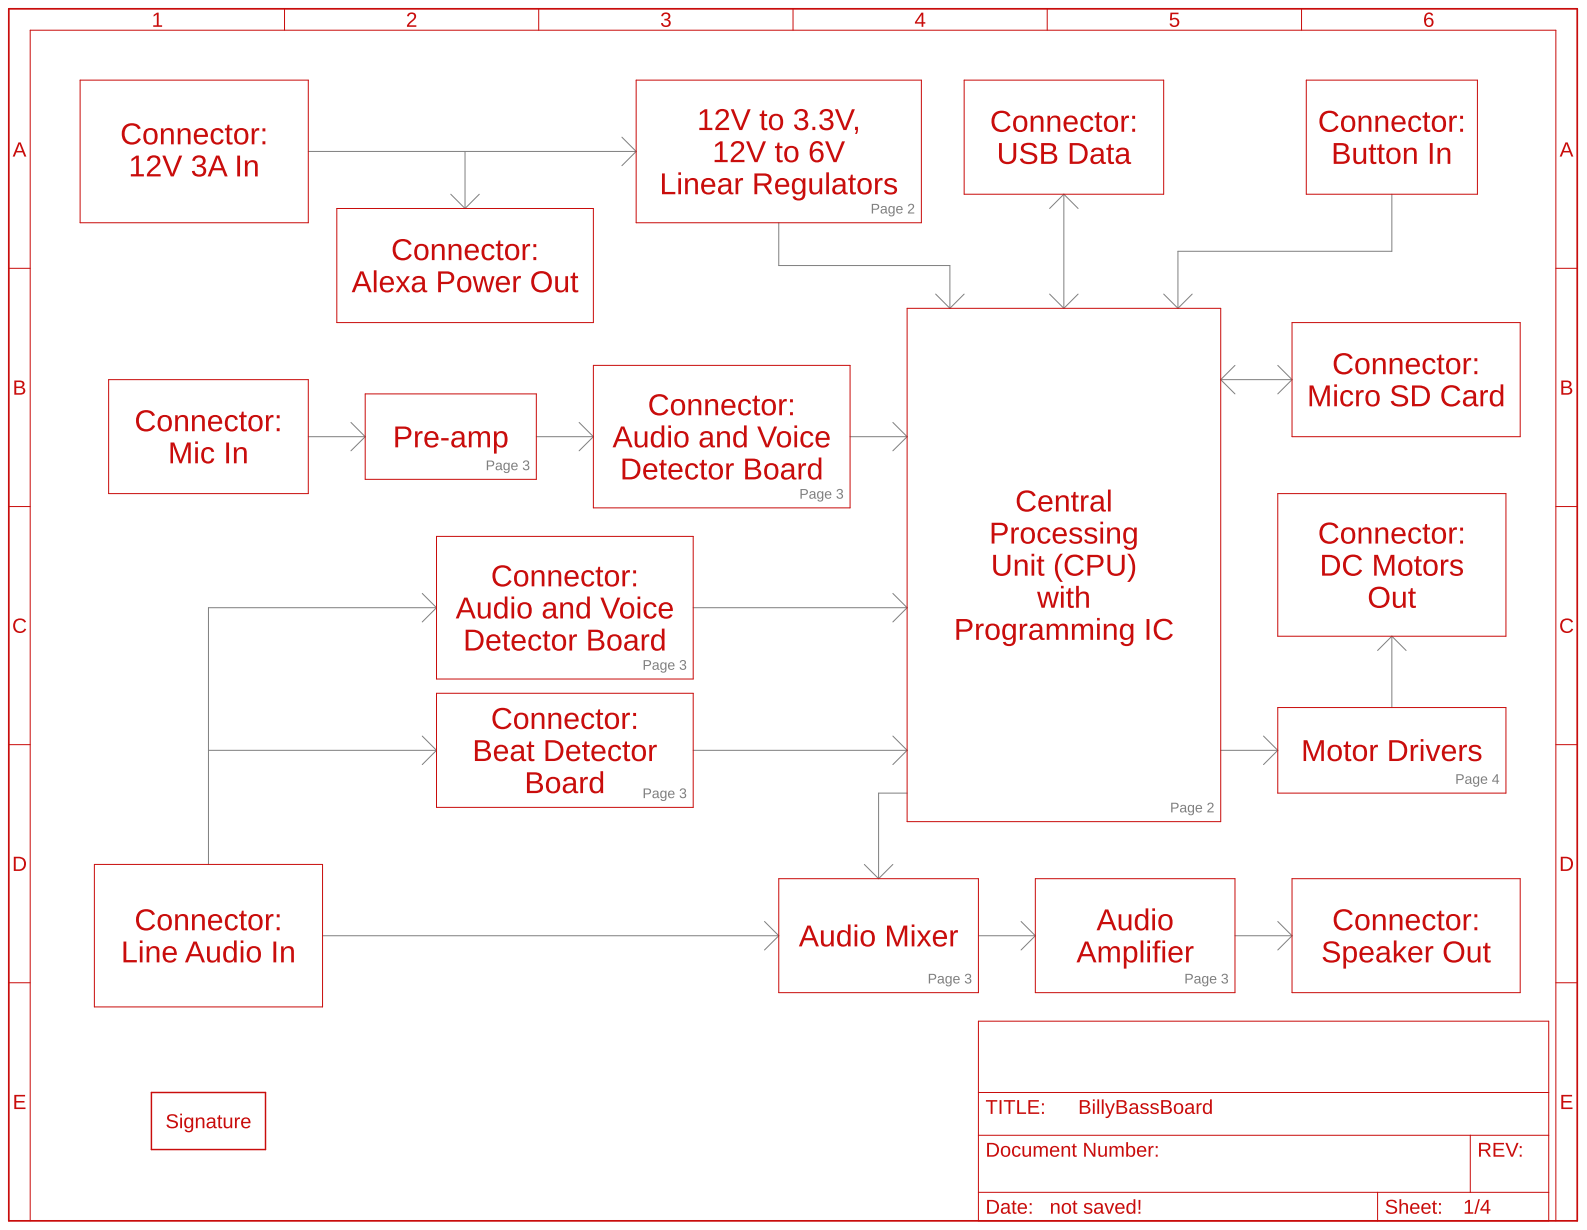
[picture p48: page 1]

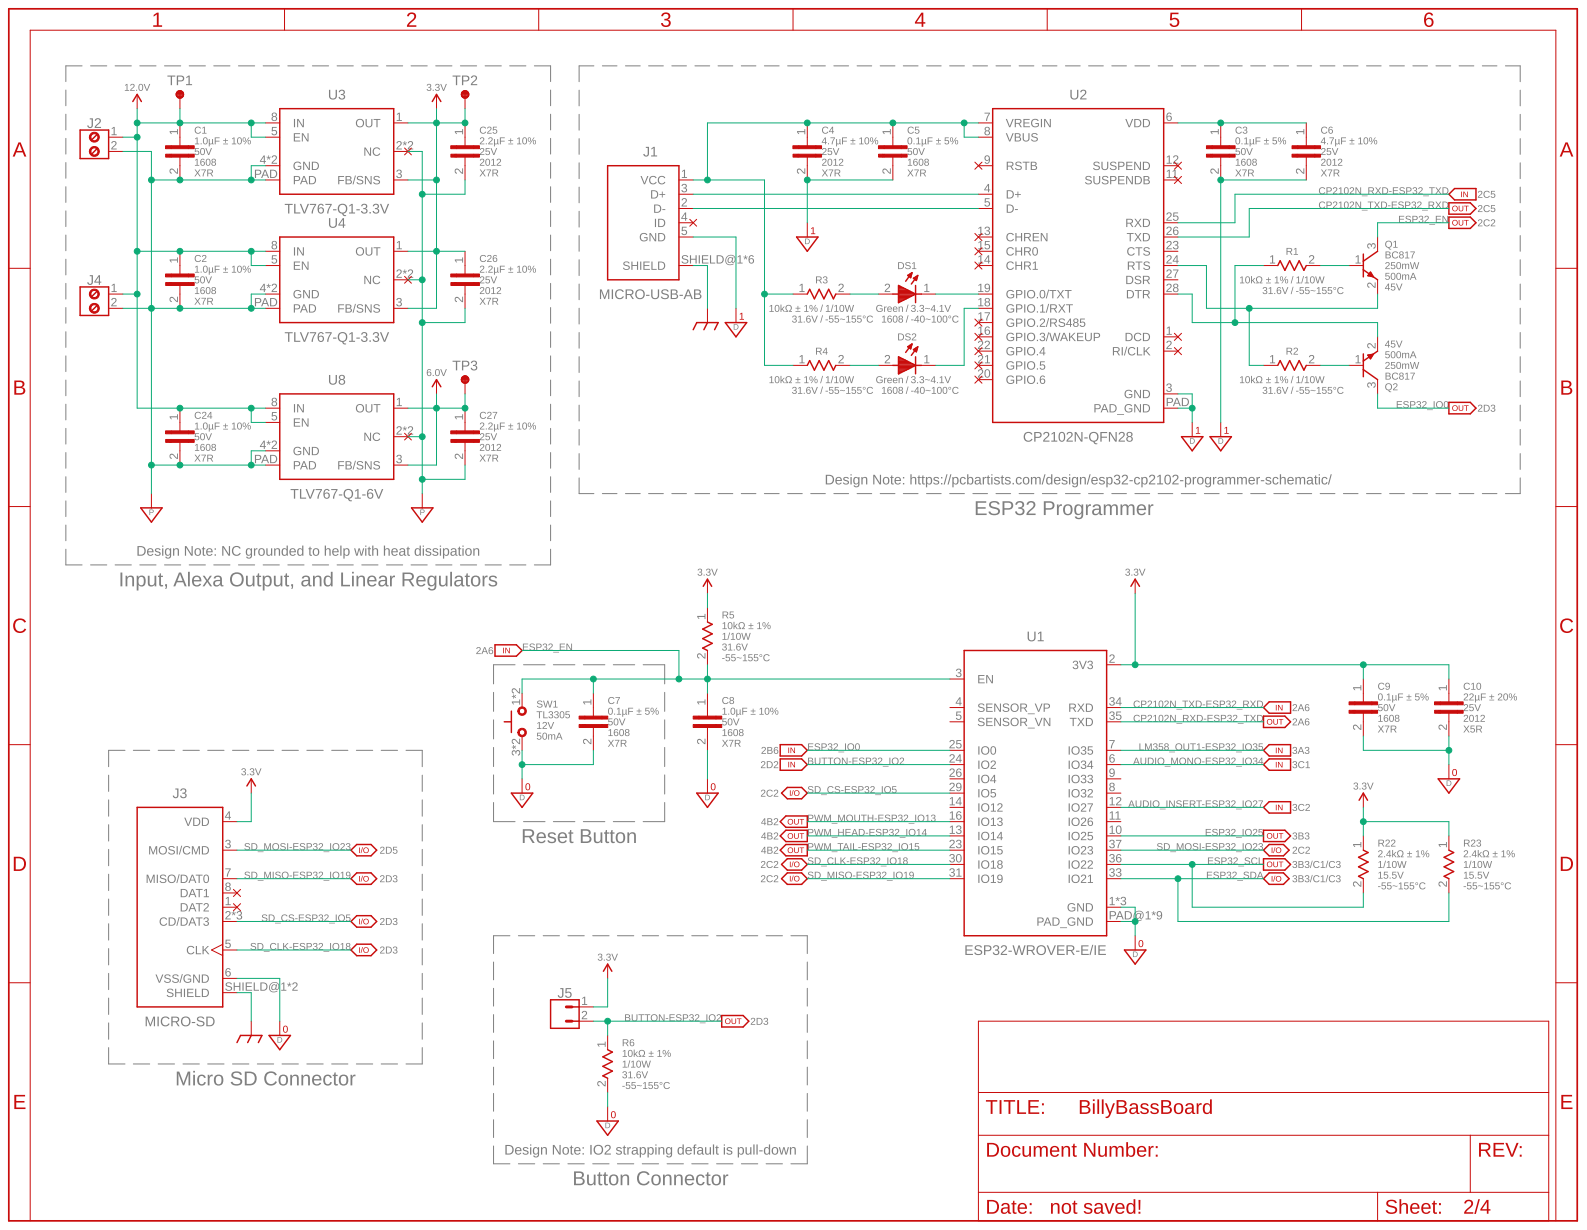
[picture p49: page 2]

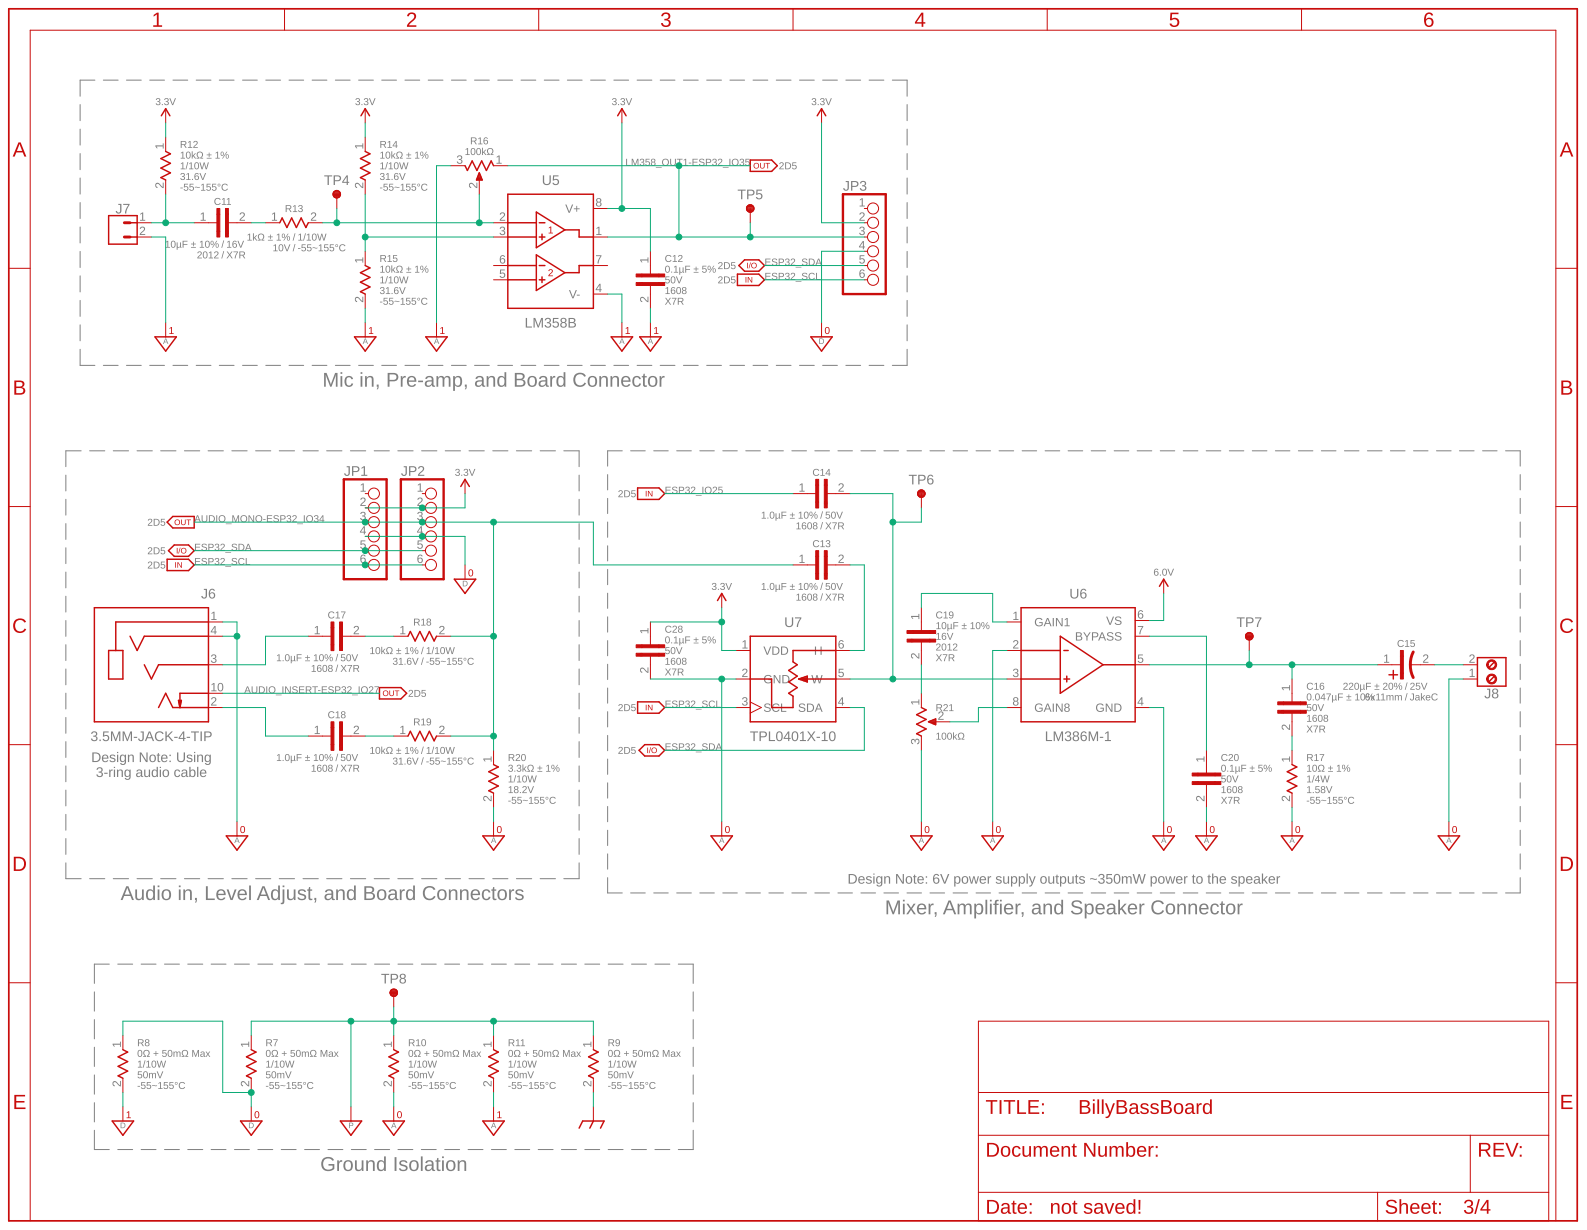
[picture p50: page 3]

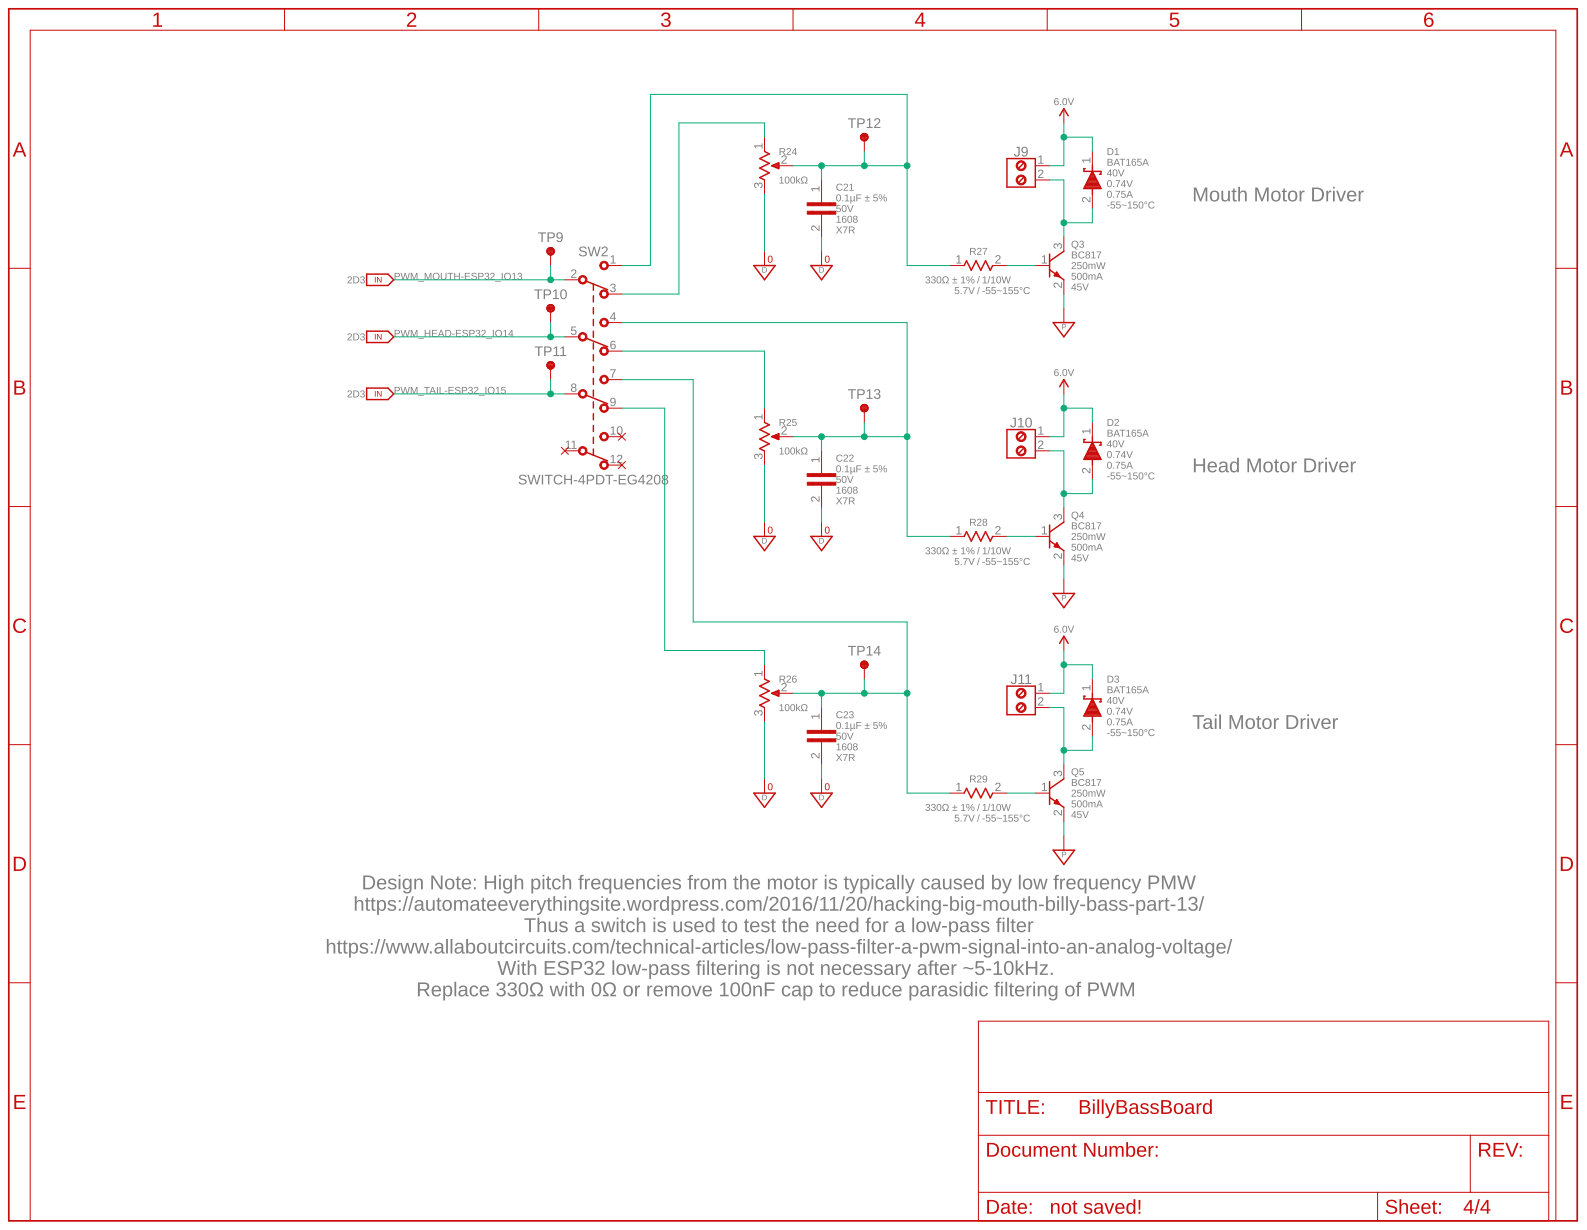
[picture p51: page 4]
