ZackHarrington/PCB-Projects/Billy-Bass-Board/Design-Files/DAC_output_sims.asc

C1: cap; 2.2n
C2: cap; 2.2n
C3: cap; 2.2n
C4: cap; 2.2n
C5: cap; 2.2n
C6: cap; 2.2n
C7: cap; 2.2n
C8: cap; 1µ
C9: cap; 1µ
C10: cap; 2.2n
C11: cap; 2.2n
C13: cap; 1µ
C14: cap; 1µ
C15: cap; 1µ
C17: cap; 1µ
Q1: npn
Q3: npn
R1: res; 470
R2: res; 470
R3: res; 470
R4: res; 470
R5: res; 470
R6: res; 470
R7: res; 470
R8: res; 1k
R9: res; 470
R10: res; 1k
R11: res; 470
R12: res; 10k
R13: res; 3.3k
R14: res; 3.3k
R17: res; 10k
V1: voltage; SINE(0 1 1k); Rser=10k
V2: voltage; SINE(0 1 1.1k); Rser=10k
V3: voltage; ""; AC 2.1; Rser=10k
V4: voltage; ""; AC 2.1; Rser=10k
V5: voltage; ""; AC 2.1; Rser=10k
V6: voltage; SINE(0 1 1k); Rser=10k
V7: voltage; SINE(0 1 1.1k); Rser=10k
V8: voltage; SINE(1.65 1 1k); Rser=50
V9: voltage; PULSE(0V 3.3V 5m 1n 1n 10m); Rser=50
V10: voltage; SINE(0 1 1k); Rser=10k
V11: voltage; SINE(0 1 1.1k); Rser=10k
V12: voltage; SINE(1.65 500m 1.5k); Rser=50
V13: voltage; PULSE(0V 3.3V 5m 1n 1n 10m); Rser=50
V14: voltage; SINE(1.65 500m 1.2k); Rser=50
V16: voltage; SINE(1.65 1 1.5k); Rser=50
Named nets: 0, ADC, Amp1, Amp
;ac dec 50 10 10000
.tran 0 10m 0 10u
Mixer
Mute Circuit
I/O
