ZackHarrington/PCB-Projects/Greek-Keyboard/Design-Files/Greek-Keyboard/Greek-Keyboard.kicad_pcb

## KiCad design Greek-Keyboard/Design-Files/Greek-Keyboard/Greek-Keyboard.kicad_pcb (2024-12-28)

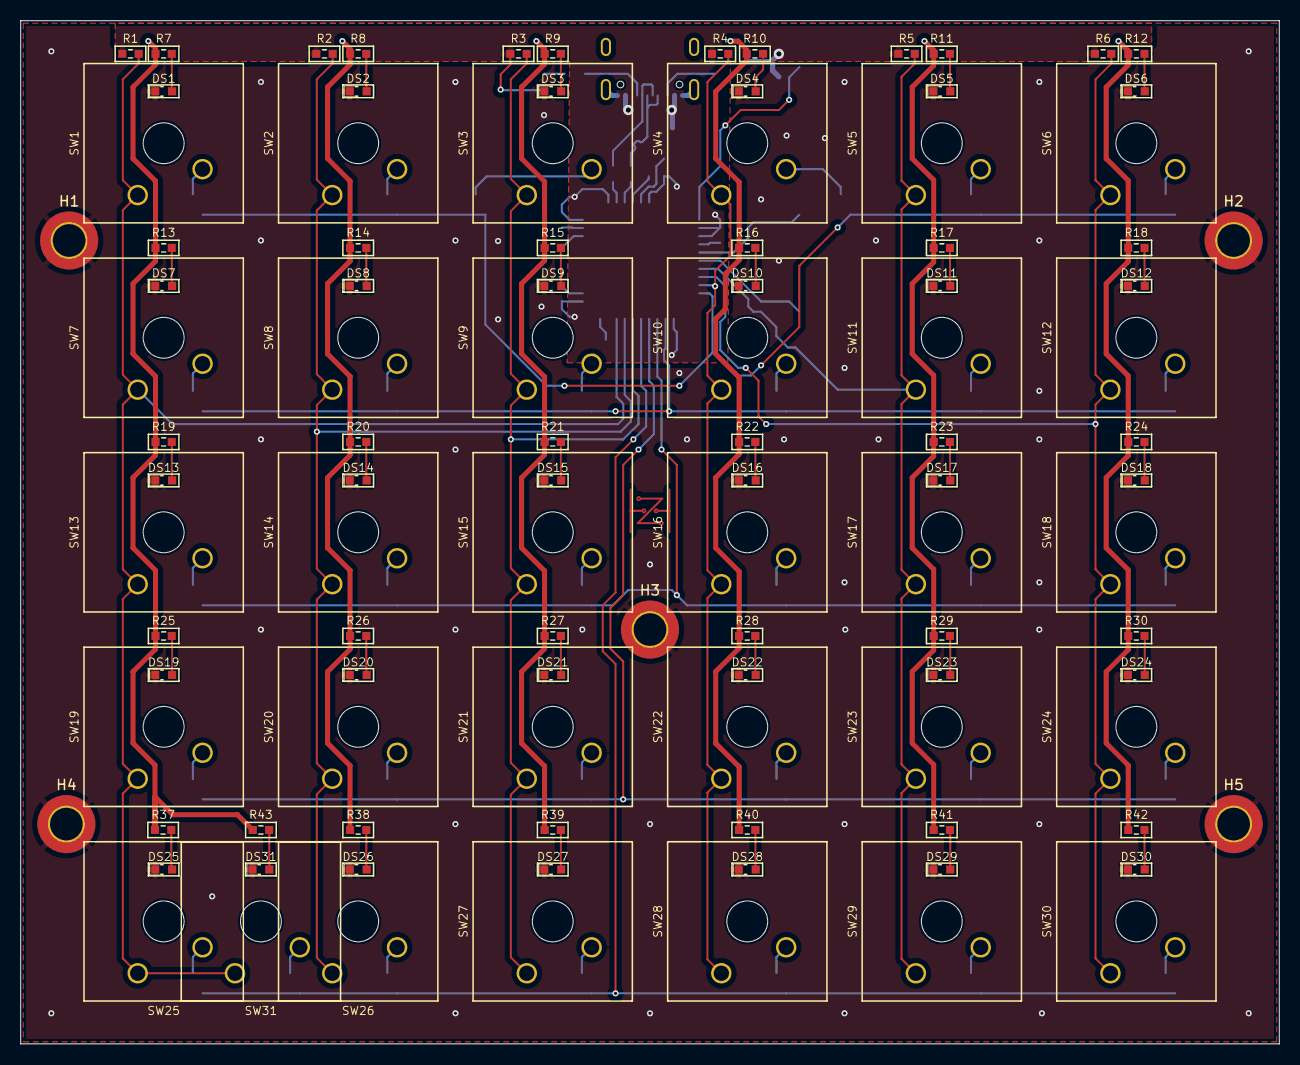
[picture p52: board Greek-Keyboard.kicad_pcb from above]

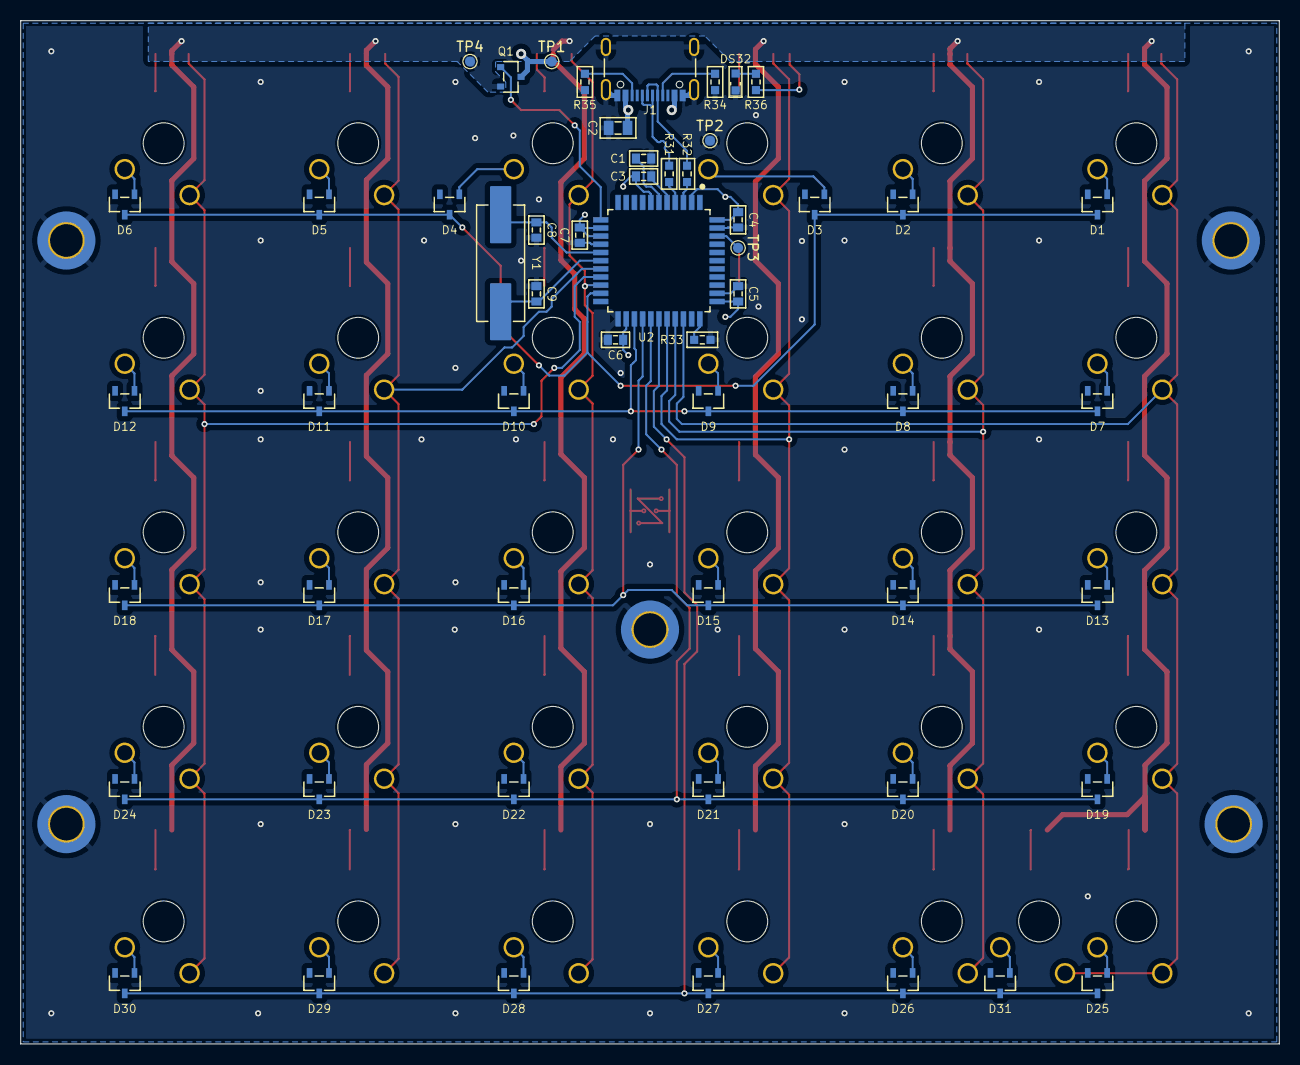
[picture p53: board Greek-Keyboard.kicad_pcb from below]

Board: 2 copper layers, 123.2 x 100.2 mm, 160 parts (55 on the bottom side), 89 nets.

Parts:
C1: 1uF±10%; 1608-SEM
C2: 10uF±10%; 2012-SEM
C3, C4, C5, C6, C7: 0.1uF±5%; 1608-SEM
C8, C9: 22pF±5%; 1608-SEM
D1, D2, D3, D4, D5, D6, D7, D8, D9, D10, D11, D12, D13, D14, D15, D16, D17, D18, D19, D20, D21, D22, D23, D24, D25, D26, D27, D28, D29, D30, D31: BAT54L; SOT-23-3
DS1, DS2, DS3, DS4, DS5, DS6, DS7, DS8, DS9, DS10, DS11, DS12, DS13, DS14, DS15, DS16, DS17, DS18, DS19, DS20, DS21, DS22, DS23, DS24, DS25, DS26, DS27, DS28, DS29, DS30, DS31: White; 1608
DS32: RED; 1608
H1, H2, H3, H4, H5: MountingHole_Pad; MountingHole_3.2mm_M3_ISO7380_Pad_TopBottom
J1: USB-C; USB-4105
Q1: BSS316N; SOT-23-3
R1, R2, R3, R4, R5, R6, R7, R8, R9, R10, R11, R12, R13, R14, R15, R16, R17, R18, R19, R20, R21, R22, R23, R24, R25, R26, R27, R28, R29, R30, R36, R37, R38, R39, R40, R41, R42, R43: 470Ω±1%; 1608-SEM
R31, R32: 22Ω±1%; 1608-SEM
R33: 10kΩ±1%; 1608-SEM
R34, R35: 5.1kΩ±1%; 1608-SEM
SW1, SW2, SW3, SW4, SW5, SW6, SW7, SW8, SW9, SW10, SW11, SW12, SW13, SW14, SW15, SW16, SW17, SW18, SW19, SW20, SW21, SW22, SW23, SW24, SW25, SW26, SW27, SW28, SW29, SW30, SW31: MX-Brown; MX-1-Pole
TP1, TP2, TP3, TP4: TestPoint; TestPoint_Pad_D1.0mm
U1: SIGNATURE
U2: ATmega32u4; TQFP44
Y1: 8MHz±25ppm; ABLS-ABRACON

Connections:
+5V: C2.1, C3.1, C4.1, C5.1, C6.1, C7.1, J1.A4_B9 (VBUS), J1.A9_B4 (VBUS), Q1.3, R1.1, R2.1, R3.1, R4.1, R5.1, R6.1, R36.1, TP1.1, U2.2 (UVcc), U2.7 (VBus), U2.13 (!RESET), U2.14 (VCC), U2.24 (AVCC), U2.34 (VCC), U2.44 (AVCC)
/Backlight LEDs/5V: Q1.2, R7.1, R8.1, R9.1, R10.1, R11.1, R12.1, R13.1, R14.1, R15.1, R16.1, R17.1, R18.1, R19.1, R20.1, R21.1, R22.1, R23.1, R24.1, R25.1, R26.1, R27.1, R28.1, R29.1, R30.1, R37.1, R38.1, R39.1, R40.1, R41.1, R42.1, R43.1, TP4.1
/D0: R4.2, SW4.2, SW10.2, SW16.2, SW22.2, SW28.2, U2.20 ((RXD1/INT2)_PD2)
/D1: D1.3, D2.3, D3.3, D4.3, D5.3, D6.3, U2.21 ((TXD1/INT3)_PD3)
/D2: R6.2, SW6.2, SW12.2, SW18.2, SW24.2, SW30.2, U2.19 ((SDA/INT1)_PD1)
/D3: R5.2, SW5.2, SW11.2, SW17.2, SW23.2, SW29.2, U2.18 ((SCL/INT0)_PD0)
/D4: D7.3, D8.3, D9.3, D10.3, D11.3, D12.3, U2.25 ((ICP1/ADC8)_PD4)
/D5: R1.2, SW1.2, SW7.2, SW13.2, SW19.2, SW25.2, SW31.2, U2.31 (PC6)
/D6: D19.3, D20.3, D21.3, D22.3, D23.3, D24.3, U2.27 ((T0/ADC10)_PD7)
/IO8: D25.3, D26.3, D27.3, D28.3, D29.3, D30.3, D31.3, U2.28 ((PCINT4/ADC11)_PB4)
/IO9: R3.2, SW3.2, SW9.2, SW15.2, SW21.2, SW27.2, U2.29 ((PCINT5/ADC12)_PB5)
/IO10: R2.2, SW2.2, SW8.2, SW14.2, SW20.2, SW26.2, U2.30 ((PCINT6/ADC13)_PB6)
/IO11: Q1.1, U2.12 ((PCINT7/!RTS)_PB7)
/IO12: D13.3, D14.3, D15.3, D16.3, D17.3, D18.3, U2.26 ((T1/ADC9)_PD6)
GND: C1.2, C2.2, C3.2, C4.2, C5.2, C6.2, C7.2, C8.1, C9.1, DS1.1, DS2.1, DS3.1, DS4.1, DS5.1, DS6.1, DS7.1, DS8.1, DS9.1, DS10.1, DS11.1, DS12.1, DS13.1, DS14.1, DS15.1, DS16.1, DS17.1, DS18.1, DS19.1, DS20.1, DS21.1, DS22.1, DS23.1, DS24.1, DS25.1, DS26.1, DS27.1, DS28.1, DS29.1, DS30.1, DS31.1, DS32.1, H1.1, H2.1, H3.1, H4.1, H5.1, J1.A1_B12 (GND), J1.A12_B1 (GND), J1.SHELL@1 (SHELL), J1.SHELL@2 (SHELL), J1.SHELL@3 (SHELL), J1.SHELL@4 (SHELL), R33.2, R34.2, R35.2, TP2.1, U2.5 (UGnd), U2.15 (GND), U2.23 (GND), U2.35 (GND), U2.43 (GND)
unnamed: D1.1, SW1.1
unnamed: D2.1, SW2.1
unnamed: D3.1, SW3.1
unnamed: D4.1, SW4.1
unnamed: D5.1, SW5.1
unnamed: D6.1, SW6.1
unnamed: D7.1, SW7.1
unnamed: D8.1, SW8.1
unnamed: D9.1, SW9.1
unnamed: D10.1, SW10.1
unnamed: D11.1, SW11.1
unnamed: D12.1, SW12.1
unnamed: D13.1, SW13.1
unnamed: D14.1, SW14.1
unnamed: D15.1, SW15.1
unnamed: D16.1, SW16.1
unnamed: D17.1, SW17.1
unnamed: D18.1, SW18.1
unnamed: D19.1, SW19.1
unnamed: D20.1, SW20.1
unnamed: D21.1, SW21.1
unnamed: D22.1, SW22.1
unnamed: D23.1, SW23.1
unnamed: D24.1, SW24.1
unnamed: D25.1, SW25.1
unnamed: D26.1, SW26.1
unnamed: D27.1, SW27.1
unnamed: D28.1, SW28.1
unnamed: D29.1, SW29.1
unnamed: D30.1, SW30.1
unnamed: D31.1, SW31.1
unnamed: DS1.2, R7.2
unnamed: DS2.2, R8.2
unnamed: DS3.2, R9.2
unnamed: DS4.2, R10.2
unnamed: DS5.2, R11.2
unnamed: DS6.2, R12.2
unnamed: DS7.2, R13.2
unnamed: DS8.2, R14.2
unnamed: DS9.2, R15.2
unnamed: DS10.2, R16.2
unnamed: DS11.2, R17.2
unnamed: DS12.2, R18.2
unnamed: DS13.2, R19.2
unnamed: DS14.2, R20.2
unnamed: DS15.2, R21.2
unnamed: DS16.2, R22.2
unnamed: DS17.2, R23.2
unnamed: DS18.2, R24.2
unnamed: DS19.2, R25.2
unnamed: DS20.2, R26.2
unnamed: DS21.2, R27.2
unnamed: DS22.2, R28.2
unnamed: DS23.2, R29.2
unnamed: DS24.2, R30.2
unnamed: DS25.2, R37.2
unnamed: DS26.2, R38.2
unnamed: DS27.2, R39.2
unnamed: DS28.2, R40.2
unnamed: DS29.2, R41.2
unnamed: DS30.2, R42.2
unnamed: DS31.2, R43.2
unnamed: DS32.2, R36.2
unnamed: J1.A5 (CC1), R34.1
unnamed: J1.B5 (CC2), R35.1
unnamed: J1.A7 (DN1), J1.B7 (DN2), R32.1
unnamed: J1.A6 (DP1), J1.B6 (DP2), R31.1
unnamed: R33.1, U2.33 ((!HWB)_PE2)
unnamed: TP3.1, U2.42 (AREF)
unnamed: R31.2, U2.4 (D+)
unnamed: R32.2, U2.3 (D-)
unnamed: C1.1, U2.6 (UCap)
unnamed: C9.2, U2.17 (XTAL1), Y1.2
unnamed: C8.2, U2.16 (XTAL2), Y1.1
