ZackHarrington/PCB-Projects/LED-Chess-Board/Design-Files/LED-Chess-Test-Board/LED-Chess-Test-Board.kicad_pcb

## KiCad design LED-Chess-Board/Design-Files/LED-Chess-Test-Board/LED-Chess-Test-Board.kicad_pcb (2024-10-13)

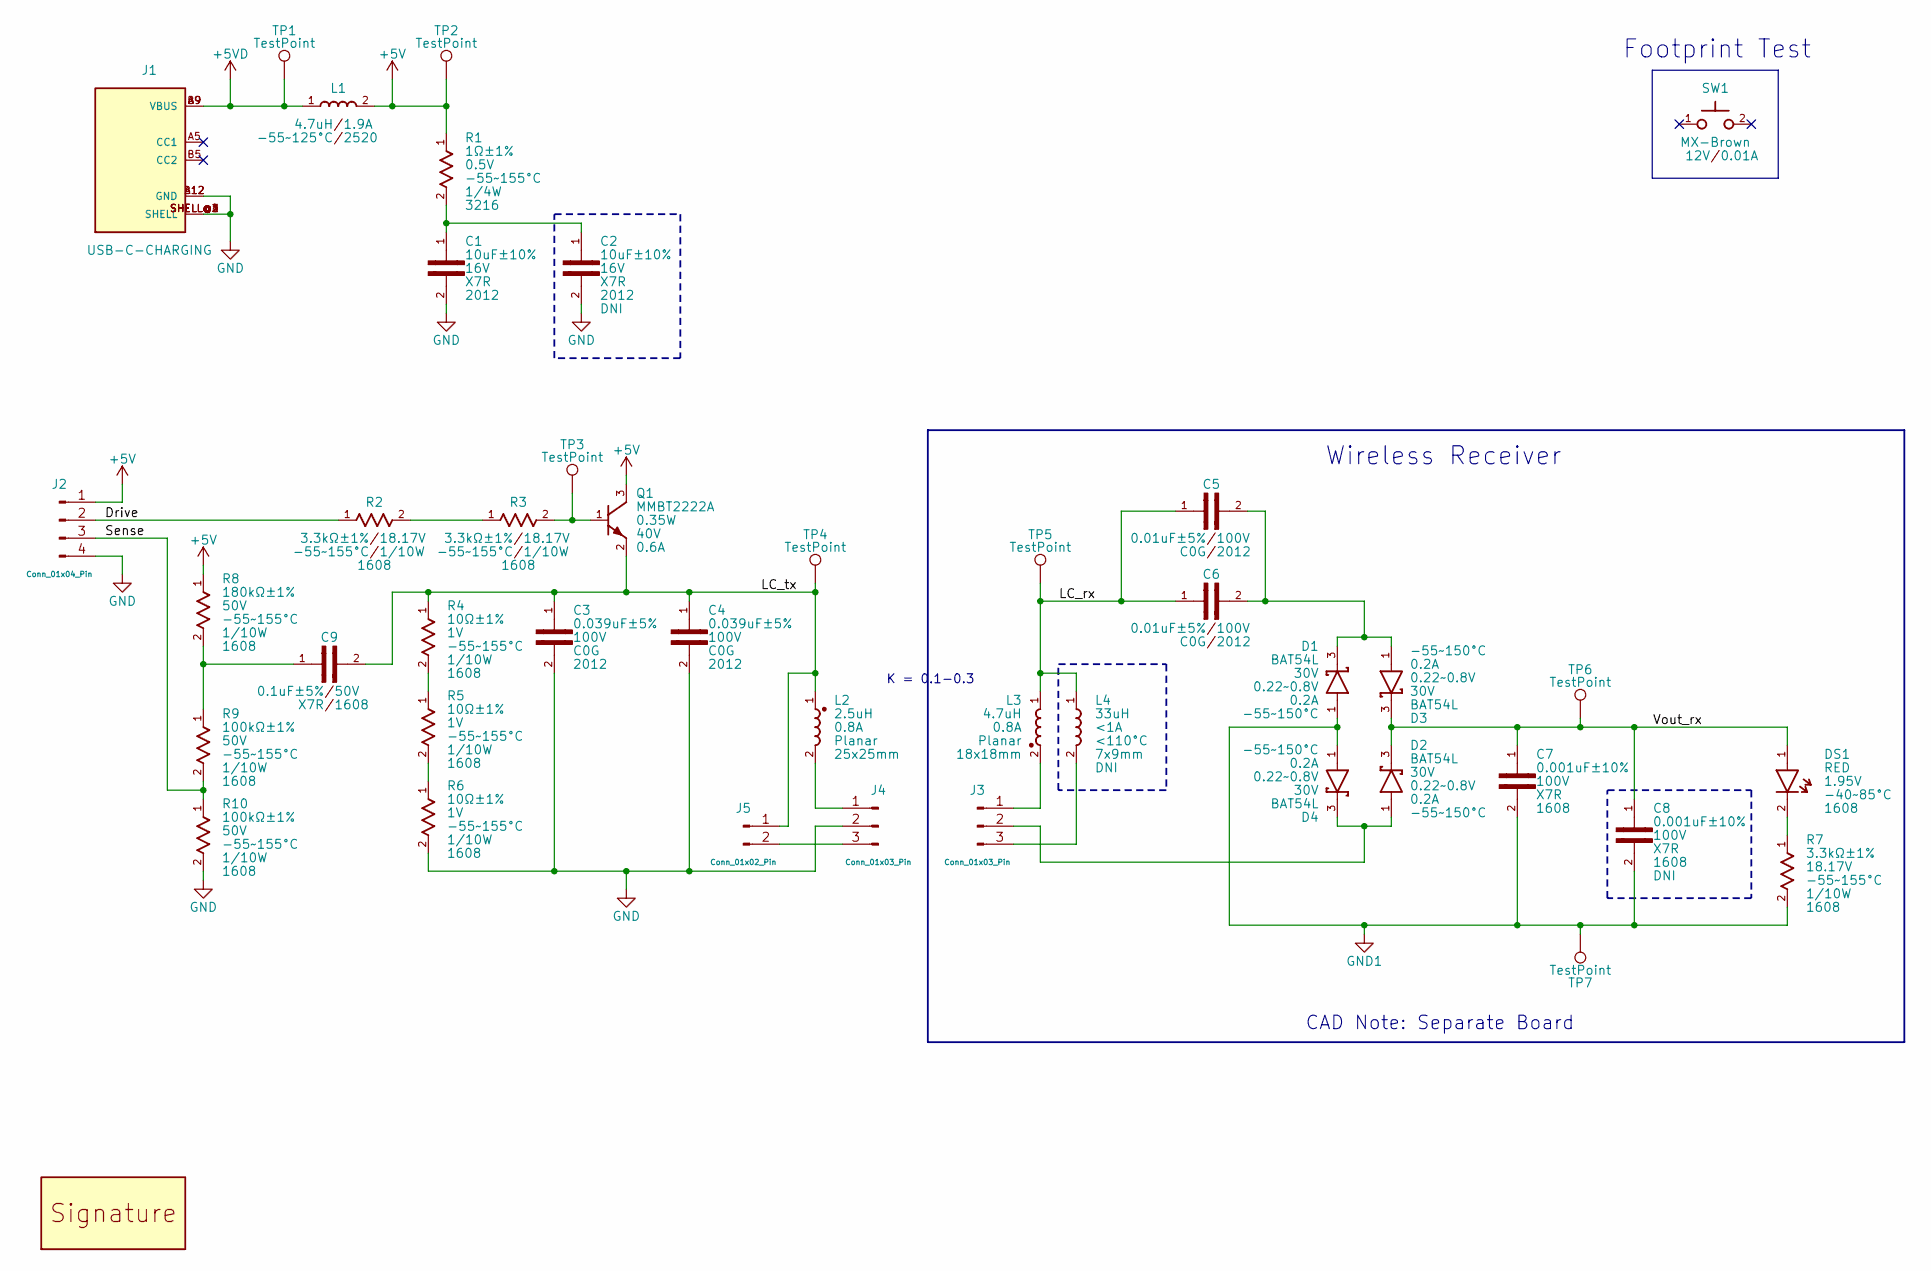
[picture p54: schematic LED-Chess-Test-Board.kicad_sch]

Parts:
C1, C2: 10uF±10%; 2012-SEM; VOLTAGE 16V
C3, C4: 0.039uF±5%; 2012-SEM; VOLTAGE 100V
C5, C6: 0.01uF±5%; 2012-SEM; VOLTAGE 100V
C7, C8: 0.001uF±10%; 1608-SEM; VOLTAGE 100V
C9: 0.1uF±5%; 1608-SEM; VOLTAGE 50V
D1, D2, D3, D4: BAT54L; SOT-23-3
DS1: RED; 1608; VOLTAGE 1.95V
J1: USB-C-CHARGING; USB-4125
J2: Conn_01x04_Pin; PinHeader_1x04_P2.54mm_Vertical
J3, J4: Conn_01x03_Pin; PinHeader_1x03_P2.54mm_Vertical
J5: Conn_01x02_Pin; PinHeader_1x02_P2.54mm_Vertical
L1: 4.7uH; 2520-SEM
L2: 2.5uH; PLANAR-2.5uH-25x25mm
L3: 4.7uH; PLANAR-4.7uH-18x18mm
L4: 33uH; 7x9mm-TH
Q1: MMBT2222A; SOT-23-3
R1: 1Ω±1%; 3216-SEM; VOLTAGE 0.5V
R2, R3, R7: 3.3kΩ±1%; 1608-SEM; VOLTAGE 18.17V
R4, R5, R6: 10Ω±1%; 1608-SEM; VOLTAGE 1V
R8: 180kΩ±1%; 1608-SEM; VOLTAGE 50V
R9, R10: 100kΩ±1%; 1608-SEM; VOLTAGE 50V
SW1: MX-Brown; MX-1-Pole
TP1, TP2, TP3, TP4, TP5, TP6, TP7: TestPoint; TestPoint_Pad_D1.0mm
U1: SIGNATURE

Connections:
+5V: J2.1, L1.2, Q1.3, R1.1, R8.1, TP2.1
+5VD: J1.A9 (VBUS), J1.B9 (VBUS), L1.1, TP1.1
/Drive: J2.2, R2.1
/LC_rx: C5.1, C6.1, L3.1, L4.1, TP5.1
/LC_tx: C3.1, C4.1, C9.2, J5.1, L2.1, Q1.2, R4.1, TP4.1
/Sense: J2.3, R9.2, R10.1
/Vout_rx: C7.1, C8.1, D2.3, D3.3, DS1.1, TP6.1
GND: C1.2, C2.2, C3.2, C4.2, J1.A12 (GND), J1.B12 (GND), J1.SHELL@1 (SHELL), J1.SHELL@2 (SHELL), J1.SHELL@3 (SHELL), J1.SHELL@4 (SHELL), J2.4, J4.2, R6.2, R10.2
GND1: C7.2, C8.2, D1.1, D4.1, R7.2, TP7.1
unnamed: C1.1, C2.1, R1.2
unnamed: C5.2, C6.2, D1.3, D3.1
unnamed: C9.1, R8.2, R9.1
unnamed: DS1.2, R7.1
unnamed: J3.1, L3.2
unnamed: D2.1, D4.3, J3.2
unnamed: J3.3, L4.2
unnamed: J4.1, L2.2
unnamed: J4.3, J5.2
unnamed: Q1.1, R3.2, TP3.1
unnamed: R2.2, R3.1
unnamed: R4.2, R5.1
unnamed: R5.2, R6.1

Notes on the sheet:
Footprint Test
K = 0.1-0.3
CAD Note: Separate Board
Wireless Receiver

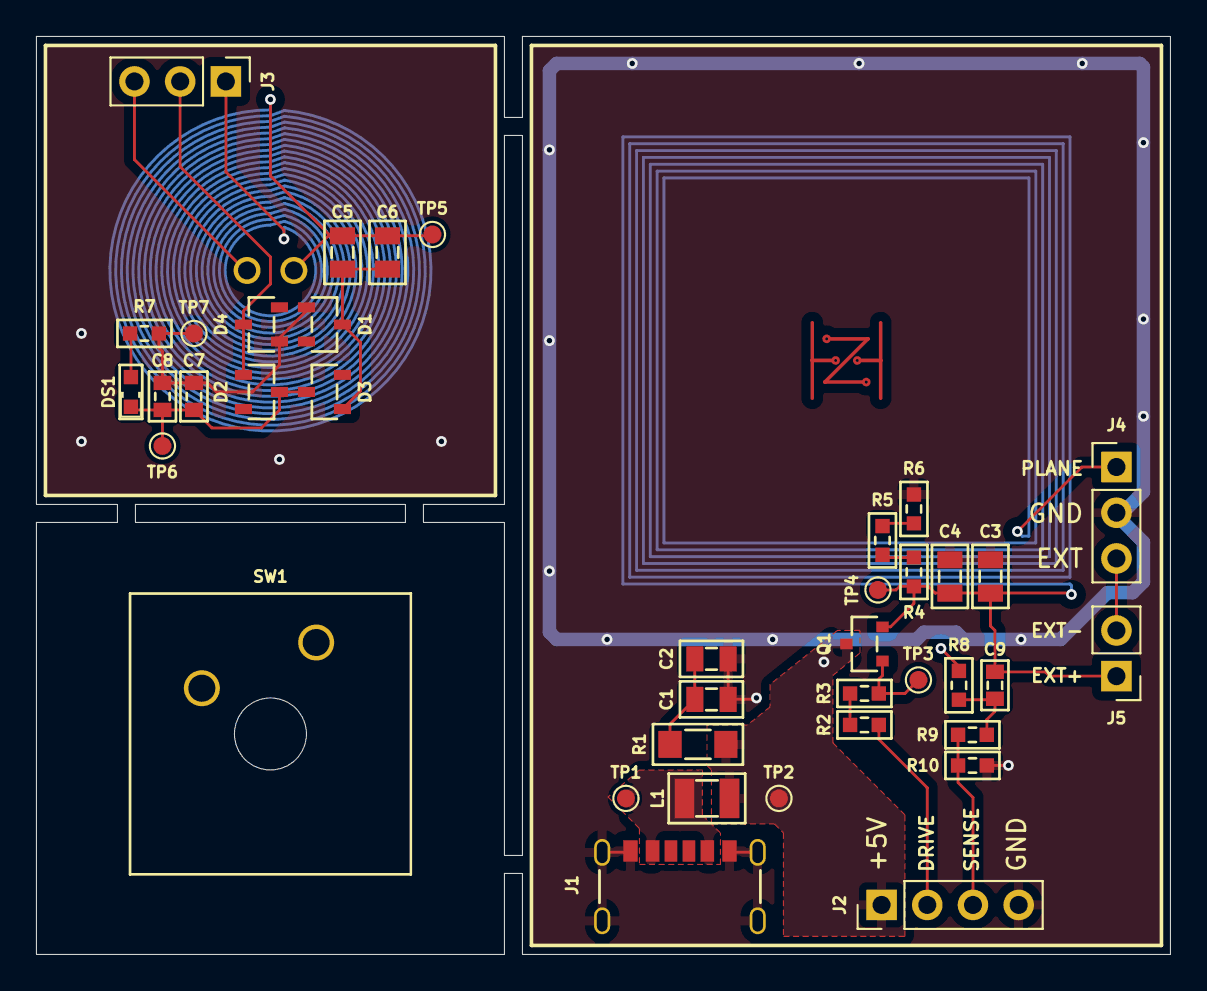
[picture p55: board LED-Chess-Test-Board.kicad_pcb from above]

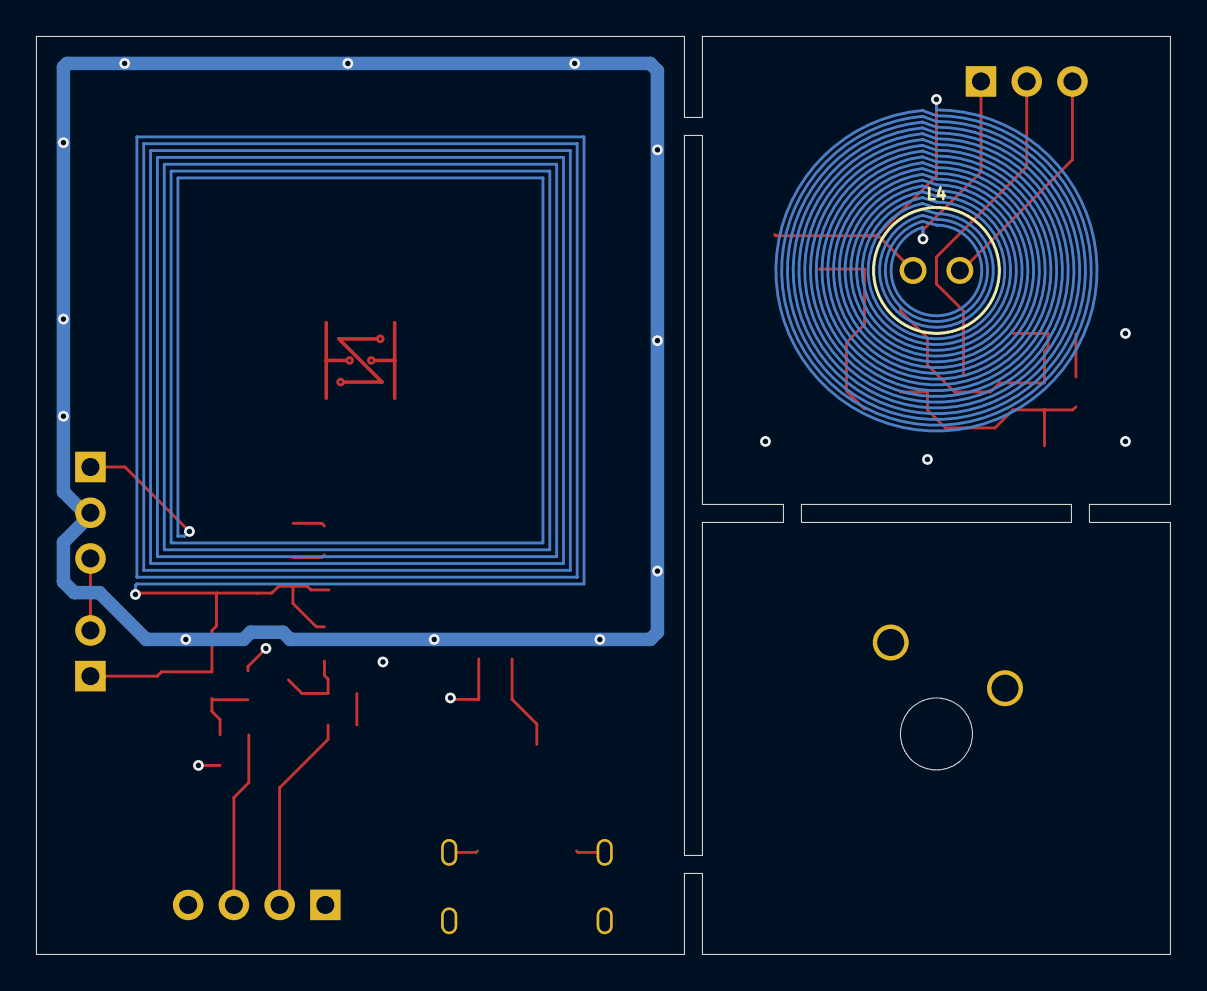
[picture p56: board LED-Chess-Test-Board.kicad_pcb from below]

Board: 4 copper layers, 63.0 x 51.0 mm, 43 parts (3 on the bottom side), 22 nets.
