ZackHarrington/PCB-Projects/USB-UART-Board/Design-Files/USB-UART-Board-CP2102N v33.brd

## EAGLE design USB-UART-Board/Design-Files/USB-UART-Board-CP2102N v33.brd (2024-10-13)

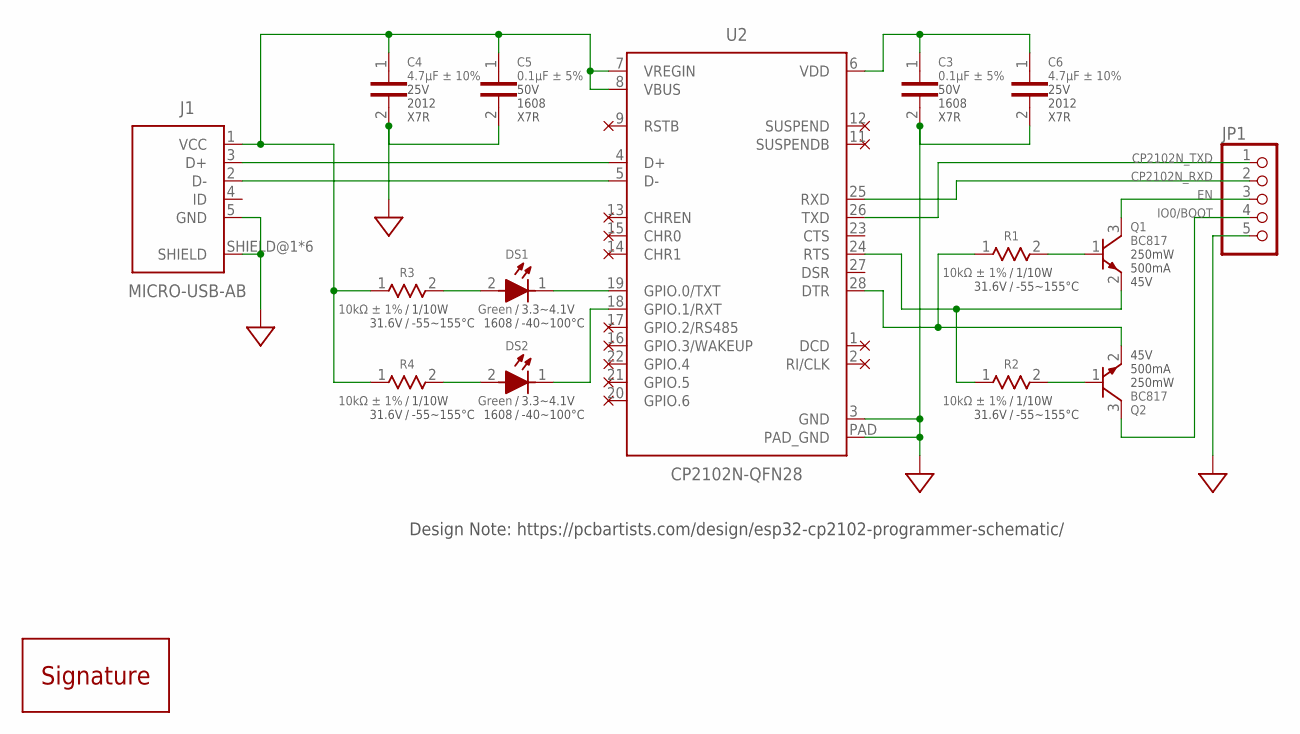
[picture p57: schematic USB-UART-Board-CP2102N v9.sch]

Parts:
C3, C5: 0.1µF ± 5%; 1608-SEM
C4, C6: 4.7µF ± 10%; 2012-SEM
DS1, DS2: Green; 1608
J1: MICRO-USB-AB; 47589-0001
JP1: PINHD-1X5; 1X05
Q1, Q2: BC817; SOT-23
R1, R2, R3, R4: 10kΩ ± 1%; 1608-SEM
U2: CP2102N-QFN28; QFN28
U$2: SIGNATURE

Connections:
CP2102N_D+: J1.3 (D+), U2.4 (D+)
CP2102N_D-: J1.2 (D-), U2.5 (D-)
CP2102N_DTR: Q2.2 (E), R1.1, U2.28 (DTR)
CP2102N_RTS: Q1.2 (E), R2.1, U2.24 (RTS)
CP2102N_RXD: JP1.2, U2.25 (RXD)
CP2102N_RXT: DS2.1, U2.18 (GPIO.1/RXT)
CP2102N_TXD: JP1.1, U2.26 (TXD)
CP2102N_TXT: DS1.1, U2.19 (GPIO.0/TXT)
CP2102N_VBUS: C4.1, C5.1, J1.1 (VCC), R3.1, R4.1, U2.7 (VREGIN), U2.8 (VBUS)
CP2102N_VDD: C3.1, C6.1, U2.6 (VDD)
EN: JP1.3, Q1.3 (C)
GND: C3.2, C4.2, C5.2, C6.2, J1.5 (GND), J1.SHIELD@1 (SHIELD), J1.SHIELD@2 (SHIELD), J1.SHIELD@3 (SHIELD), J1.SHIELD@4 (SHIELD), J1.SHIELD@5 (SHIELD), J1.SHIELD@6 (SHIELD), JP1.5, U2.3 (GND), U2.PAD (PAD_GND)
IO0/BOOT: JP1.4, Q2.3 (C)
unnamed: Q1.1 (B), R1.2
unnamed: Q2.1 (B), R2.2
unnamed: DS1.2, R3.2
unnamed: DS2.2, R4.2

Notes on the sheet:
Design Note: https://pcbartists.com/design/esp32-cp2102-programmer-schematic/

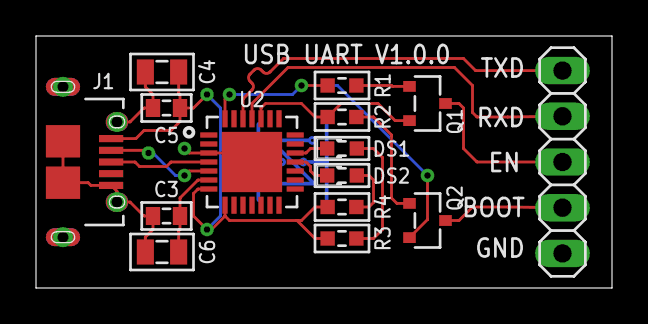
[picture p58: board USB-UART-Board-CP2102N v33.brd from above]

Board: 2 copper layers, 32.0 x 14.0 mm, 16 parts (1 on the bottom side), 17 nets.
