ZackHarrington/PCB-Projects/LED-Test-Board/Design-Files/LED-Test-Board v16.brd

## EAGLE design LED-Test-Board/Design-Files/LED-Test-Board v16.brd (2024-10-13)

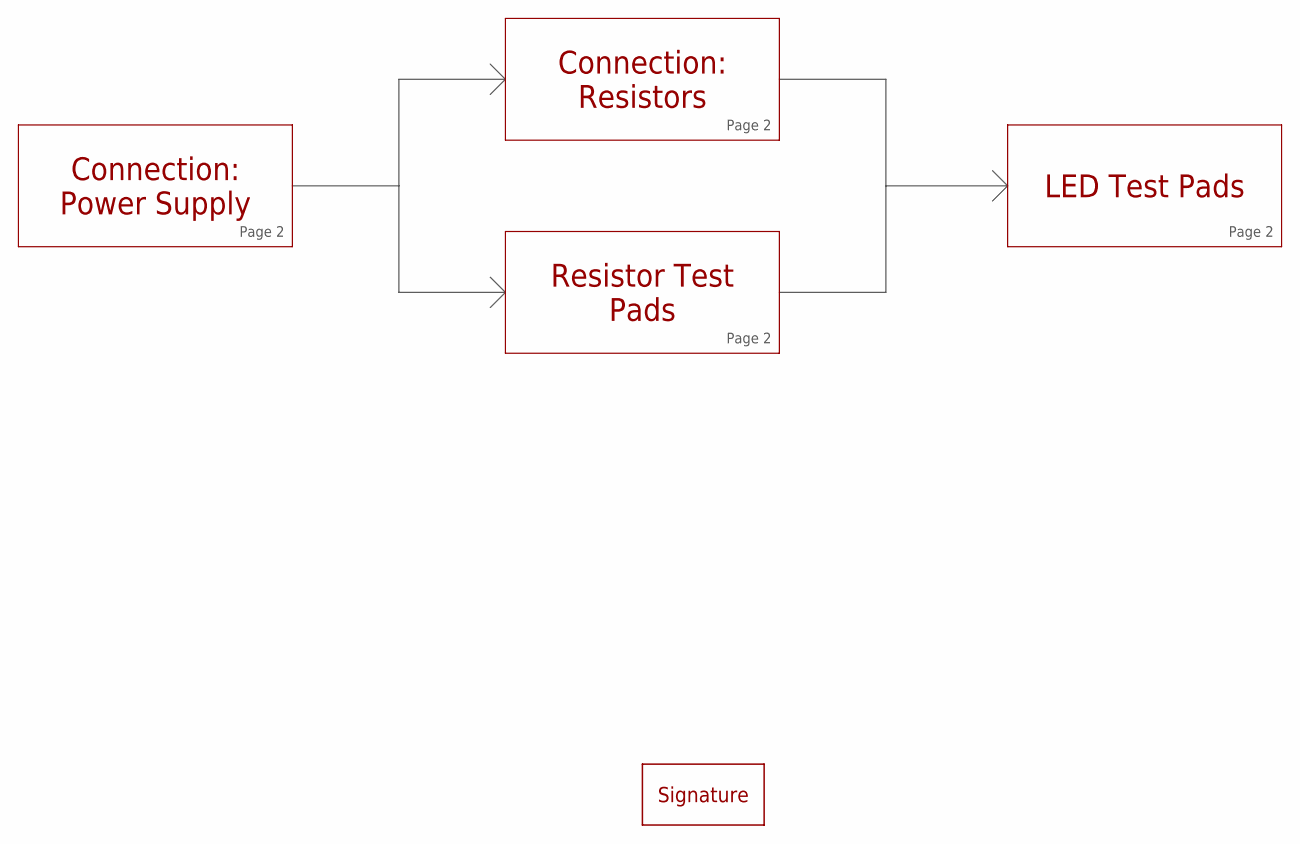
[picture p59: schematic LED-Test-Board v13.sch, sheet 1]

Parts:
U$5: SIGNATURE

Notes on the sheet:
Connection: Power Supply
Connection: Resistors
LED Test Pads
Resistor Test Pads
Page 2

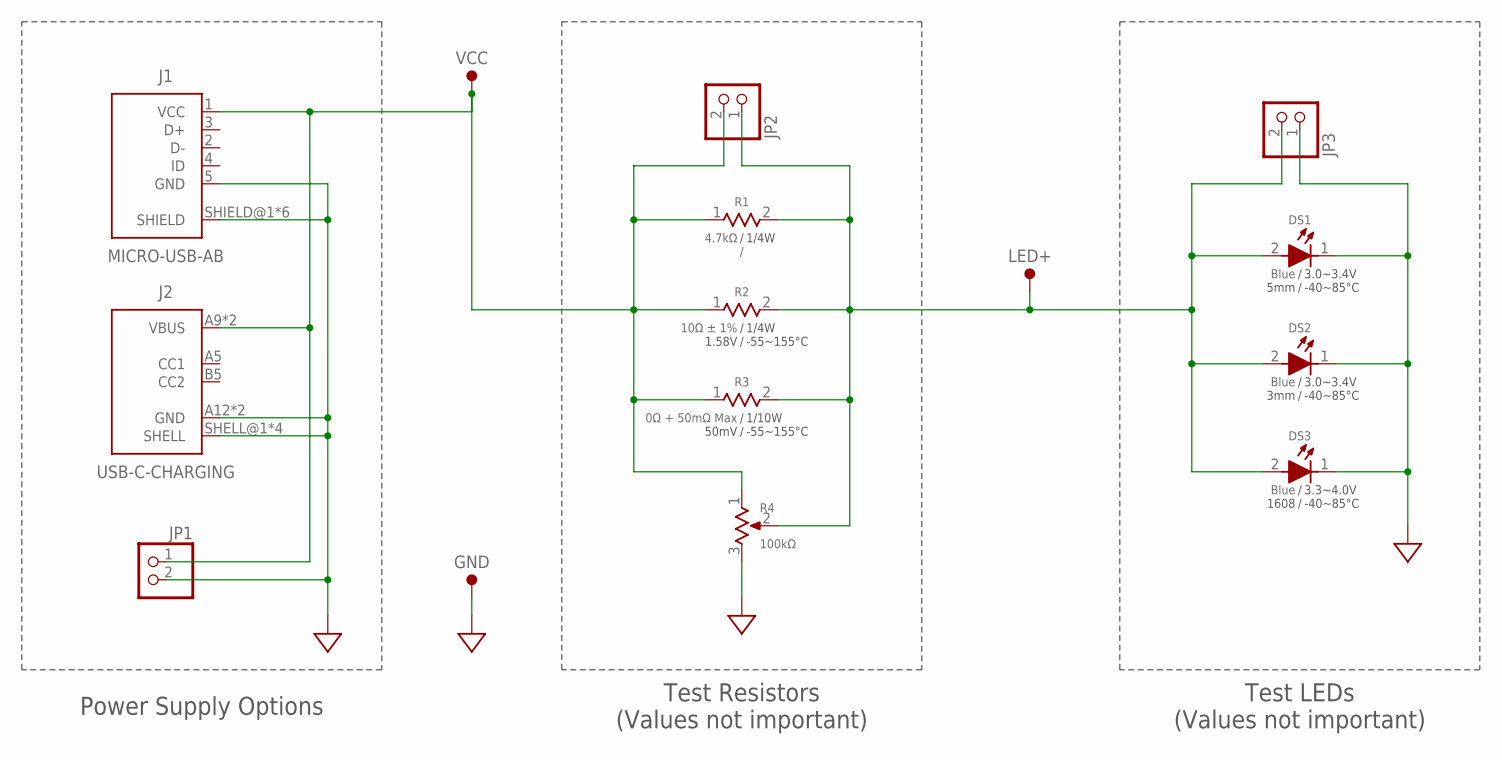
[picture p60: schematic LED-Test-Board v13.sch, sheet 2]

Parts:
DS1: Blue; 5MM-TH
DS2: Blue; 3MM-TH
DS3: Blue; 1608
GND: TEST-POINT
J1: MICRO-USB-AB; 47589-0001
J2: USB-C-CHARGING; USB-4125
JP1, JP2, JP3: PINHD-1X2; 1X02
LED+: TEST-POINT
R1: 4.7kΩ; 1/4W-TH
R2: 10Ω ± 1%; 3216-SEM
R3: 0Ω + 50mΩ Max; 1608-SEM
R4: 100kΩ; 3314J
VCC: TEST-POINT

Connections:
GND: DS1.1, DS2.1, DS3.1, GND.TP, J1.5 (GND), J1.SHIELD@1 (SHIELD), J1.SHIELD@2 (SHIELD), J1.SHIELD@3 (SHIELD), J1.SHIELD@4 (SHIELD), J1.SHIELD@5 (SHIELD), J1.SHIELD@6 (SHIELD), J2.A12 (GND), J2.B12 (GND), J2.SHELL@1 (SHELL), J2.SHELL@2 (SHELL), J2.SHELL@3 (SHELL), J2.SHELL@4 (SHELL), JP1.2, JP3.1, R4.3
RES_OUT: DS1.2, DS2.2, DS3.2, JP2.1, JP3.2, LED+.TP, R1.2, R2.2, R3.2, R4.2
VCC: J1.1 (VCC), J2.A9 (VBUS), J2.B9 (VBUS), JP1.1, JP2.2, R1.1, R2.1, R3.1, R4.1, VCC.TP

Notes on the sheet:
Test LEDs (Values not important)
Test Resistors (Values not important)
Power Supply Options

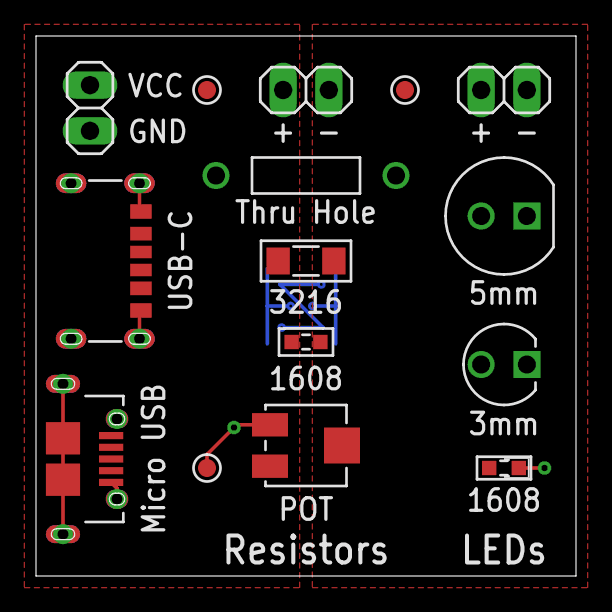
[picture p61: board LED-Test-Board v16.brd from above]

Board: 2 copper layers, 30.0 x 30.0 mm, 16 parts (1 on the bottom side), 3 nets.
