ZackHarrington/PCB-Projects/Billy-Bass-Board/Design-Files/Billy-Bass-Board v96.brd

## EAGLE design Billy-Bass-Board/Design-Files/Billy-Bass-Board v96.brd (2024-10-13)

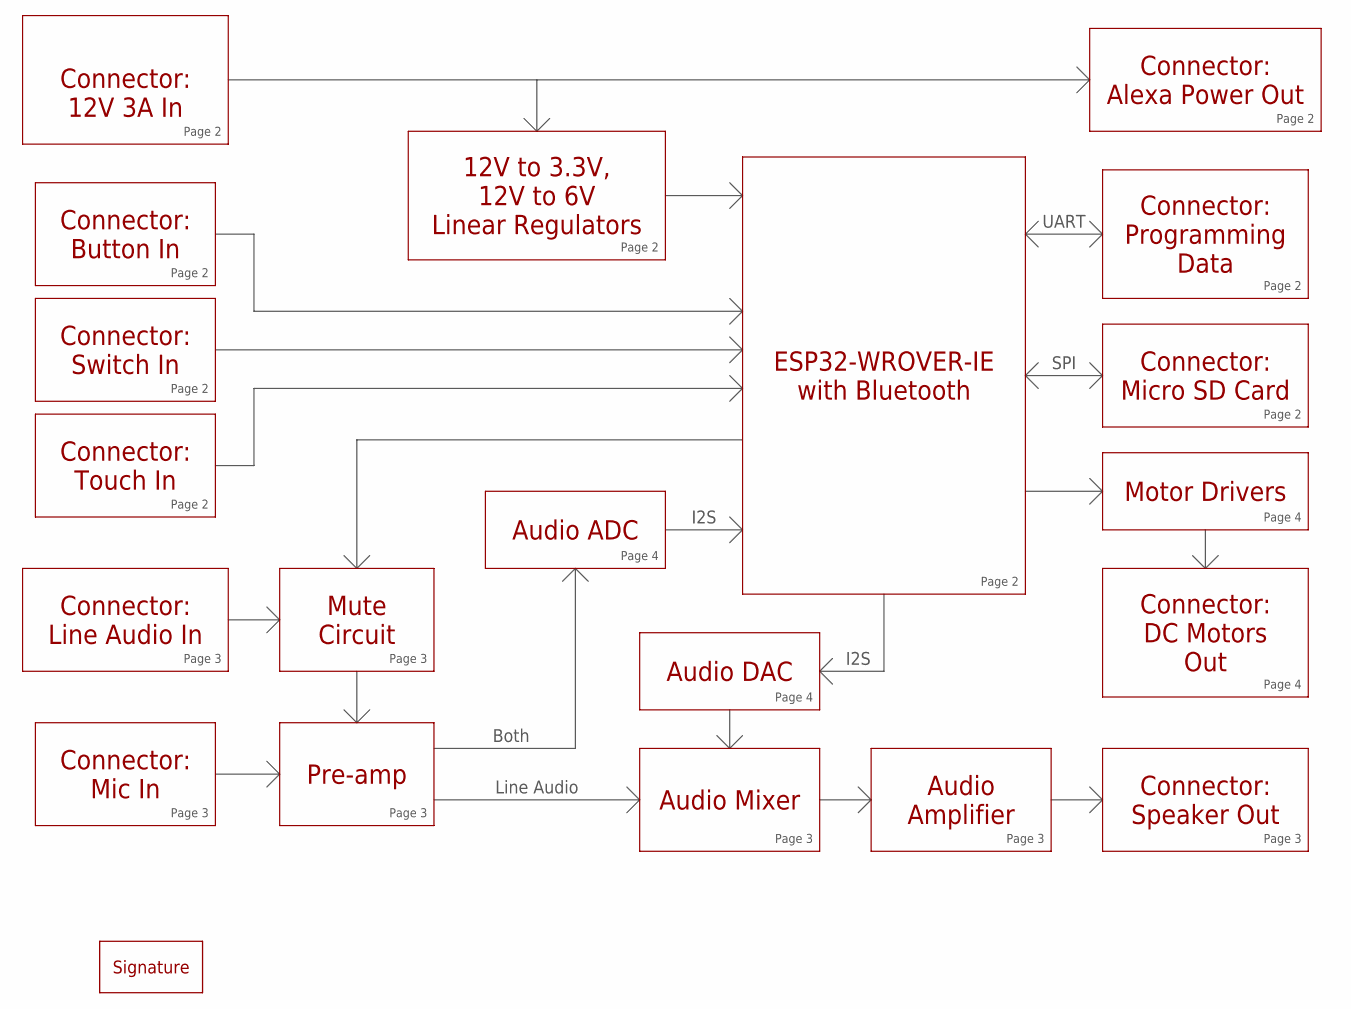
[picture p62: schematic Billy-Bass-Board v75.sch, sheet 1]

Parts:
U$122: SIGNATURE

Notes on the sheet:
ESP32-WROVER-IE with Bluetooth
Connector: 12V 3A In
Connector: Line Audio In
Connector: Speaker Out
Connector: DC Motors Out
12V to 3.3V, 12V to 6V Linear Regulators
Motor Drivers
Audio Mixer
Audio Amplifier
Page 2
Page 4
Page 3
Connector: Micro SD Card
Connector: Programming Data
Connector: Alexa Power Out
Connector: Mic In
Pre-amp
Connector: Touch In
Connector: Switch In
Connector: Button In
Audio DAC
Audio ADC
UART
SPI
I2S
Mute Circuit
Line Audio
Both

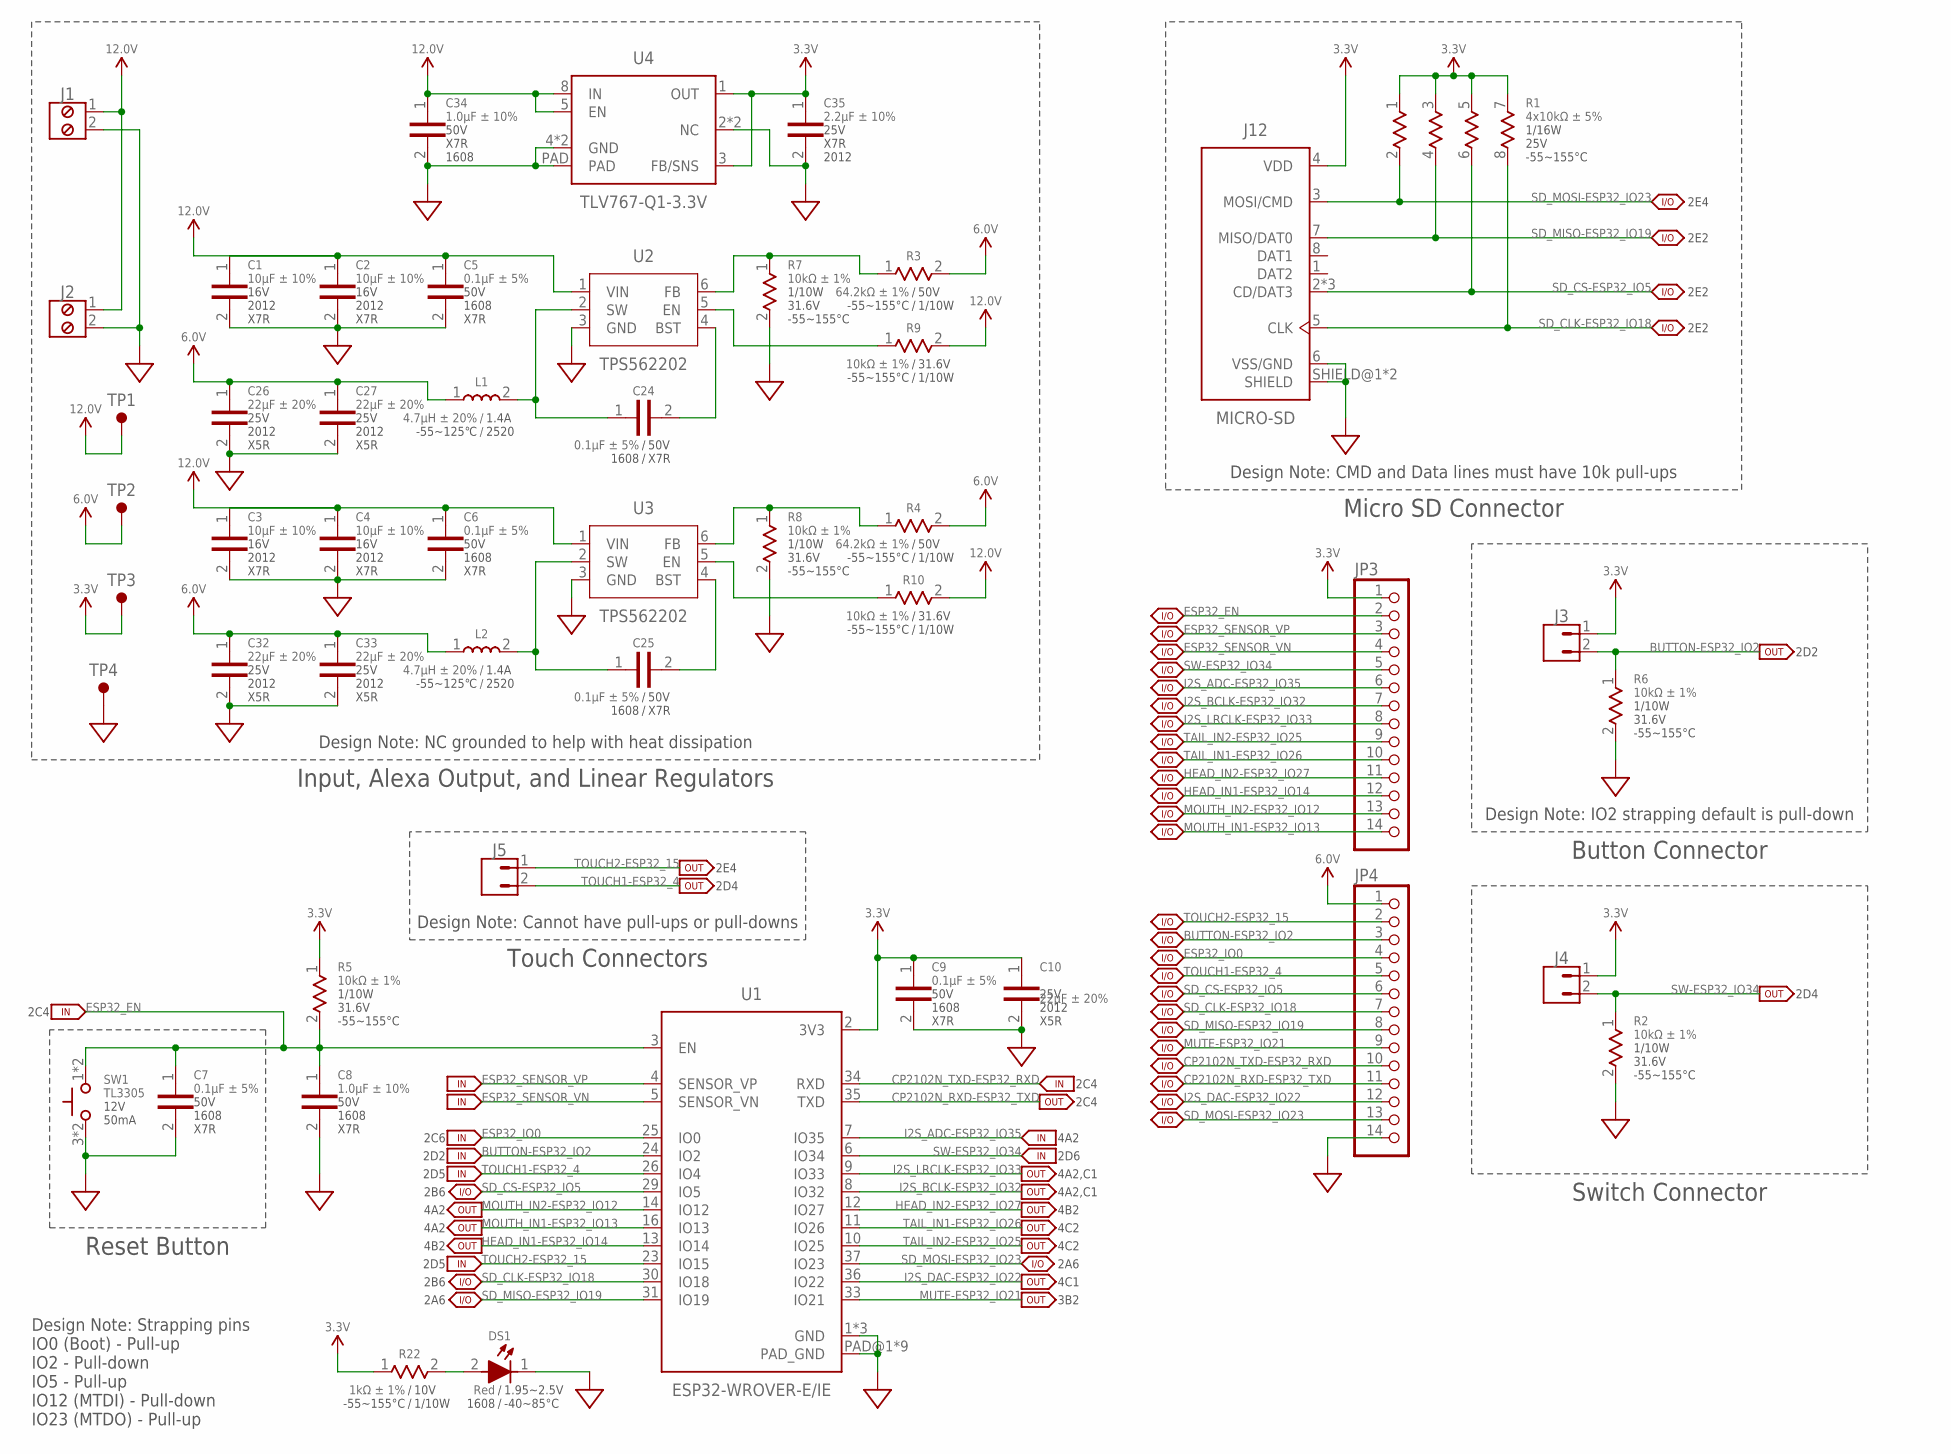
[picture p63: schematic Billy-Bass-Board v75.sch, sheet 2]

Parts:
C1, C2, C3, C4: 10µF ± 10%; 2012-SEM
C5, C6, C7, C9, C24, C25: 0.1µF ± 5%; 1608-SEM
C8, C34: 1.0µF ± 10%; 1608-SEM
C10, C26, C27, C32, C33: 22µF ± 20%; 2012-SEM
C35: 2.2µF ± 10%; 2012-SEM
DS1: Red; 1608
J1, J2: MPT-2-SCREW; MPT-0.5/2-2.54
J3, J4, J5: JST-XH-2; B2B-XH-A
J12: MICRO-SD; MEM2061
JP3, JP4: PINHD-1X14; 1X14
L1, L2: 4.7µH ± 20%; 2520-SEM
R1: 4x10kΩ ± 5%; 2010-4P-SEM
R2, R5, R6, R7, R8, R9, R10: 10kΩ ± 1%; 1608-SEM
R3, R4: 64.2kΩ ± 1%; 1608-SEM
R22: 1kΩ ± 1%; 1608-SEM
SW1: TL3305
TP1, TP2, TP3, TP4: TEST-POINT
U1: ESP32-WROVER-E/IE
U2, U3: TPS562202; SOT563
U4: TLV767-Q1-3.3V; VSON

Connections:
3.3V: C9.1, C10.1, C35.1, J3.1, J4.1, J12.4 (VDD), JP3.1, R1.1, R1.3, R1.5, R1.7, R5.1, R22.1, TP3.TP, U1.2 (3V3), U4.1 (OUT), U4.3 (FB/SNS); also elsewhere on the board
6.0V: C26.1, C27.1, C32.1, C33.1, JP4.1, L1.1, L2.1, R3.2, R4.2, TP2.TP; also elsewhere on the board
12.0V: C1.1, C2.1, C3.1, C4.1, C5.1, C6.1, C34.1, J1.1, J2.1, R9.2, R10.2, TP1.TP, U2.1 (VIN), U3.1 (VIN), U4.5 (EN), U4.8 (IN)
BUTTON-ESP32_IO2: J3.2, JP4.3, R6.1, U1.24 (IO2)
CP2102N_RXD-ESP32_TXD: JP4.11, U1.35 (TXD)
CP2102N_TXD-ESP32_RXD: JP4.10, U1.34 (RXD)
ESP32_EN: C7.1, C8.1, JP3.2, R5.2, SW1.1 (2), SW1.2, U1.3 (EN)
ESP32_IO0: JP4.4, U1.25 (IO0)
ESP32_SENSOR_VN: JP3.4, U1.5 (SENSOR_VN)
ESP32_SENSOR_VP: JP3.3, U1.4 (SENSOR_VP)
GND: C1.2, C2.2, C3.2, C4.2, C5.2, C6.2, C7.2, C8.2, C9.2, C10.2, C26.2, C27.2, C32.2, C33.2, C34.2, C35.2, DS1.1, J1.2, J2.2, J12.6 (VSS/GND), J12.SHIELD@1 (SHIELD), J12.SHIELD@2 (SHIELD), JP4.14, R2.2, R6.2, R7.2, R8.2, SW1.3 (1), SW1.4 (1), TP4.TP, U1.1 (GND), U1.15 (GND), U1.38 (GND), U1.PAD@1 (PAD_GND), U1.PAD@2 (PAD_GND), U1.PAD@3 (PAD_GND), U1.PAD@4 (PAD_GND), U1.PAD@5 (PAD_GND), U1.PAD@6 (PAD_GND), U1.PAD@7 (PAD_GND), U1.PAD@8 (PAD_GND), U1.PAD@9 (PAD_GND), U2.3 (GND), U3.3 (GND), U4.2 (NC), U4.4 (GND), U4.6 (GND), U4.7 (NC), U4.PAD; also elsewhere on the board
HEAD_IN1-ESP32_IO14: JP3.12, U1.13 (IO14); also elsewhere on the board
HEAD_IN2-ESP32_IO27: JP3.11, U1.12 (IO27); also elsewhere on the board
I2S_ADC-ESP32_IO35: JP3.6, U1.7 (IO35); also elsewhere on the board
I2S_BCLK-ESP32_IO32: JP3.7, U1.8 (IO32); also elsewhere on the board
I2S_DAC-ESP32_IO22: JP4.12, U1.36 (IO22); also elsewhere on the board
I2S_LRCLK-ESP32_IO33: JP3.8, U1.9 (IO33); also elsewhere on the board
MOUTH_IN1-ESP32_IO13: JP3.14, U1.16 (IO13); also elsewhere on the board
MOUTH_IN2-ESP32_IO12: JP3.13, U1.14 (IO12); also elsewhere on the board
MUTE-ESP32_IO21: JP4.9, U1.33 (IO21); also elsewhere on the board
unnamed: DS1.2, R22.2
SD_CLK-ESP32_IO18: J12.5 (CLK), JP4.7, R1.8, U1.30 (IO18)
SD_CS-ESP32_IO5: J12.2 (CD/DAT3), J12.CD@1 (CD/DAT3), J12.CD@2 (CD/DAT3), JP4.6, R1.6, U1.29 (IO5)
SD_MISO-ESP32_IO19: J12.7 (MISO/DAT0), JP4.8, R1.4, U1.31 (IO19)
SD_MOSI-ESP32_IO23: J12.3 (MOSI/CMD), JP4.13, R1.2, U1.37 (IO23)
SW-ESP32_IO34: J4.2, JP3.5, R2.1, U1.6 (IO34)
TAIL_IN1-ESP32_IO26: JP3.10, U1.11 (IO26); also elsewhere on the board
TAIL_IN2-ESP32_IO25: JP3.9, U1.10 (IO25); also elsewhere on the board
TOUCH1-ESP32_4: J5.2, JP4.5, U1.26 (IO4)
TOUCH2-ESP32_15: J5.1, JP4.2, U1.23 (IO15)
TPS5622021_BST: C24.2, U2.4 (BST)
TPS5622021_EN: R9.1, U2.5 (EN)
TPS5622021_FB: R3.1, R7.1, U2.6 (FB)
TPS5622021_SW: C24.1, L1.2, U2.2 (SW)
TPS5622022_BST: C25.2, U3.4 (BST)
TPS5622022_EN: R10.1, U3.5 (EN)
TPS5622022_FB: R4.1, R8.1, U3.6 (FB)
TPS5622022_SW: C25.1, L2.2, U3.2 (SW)

Notes on the sheet:
Input, Alexa Output, and Linear Regulators
Reset Button
2E4
2E2
Micro SD Connector
2D2
Button Connector
Design Note: IO2 strapping default is pull-down
2C4
2A6
2C6
2B6
Design Note: NC grounded to help with heat dissipation
Design Note: CMD and Data lines must have 10k pull-ups
Design Note: Strapping pins IO0 (Boot) - Pull-up IO2 - Pull-down IO5 - Pull-up IO12 (MTDI) - Pull-down IO23 (MTDO) - Pull-up
Design Note: Cannot have pull-ups or pull-downs
Touch Connectors
Switch Connector
4A2
4B2
4C2
2D4
2D5
2D6
4A2,C1
4C1
3B2

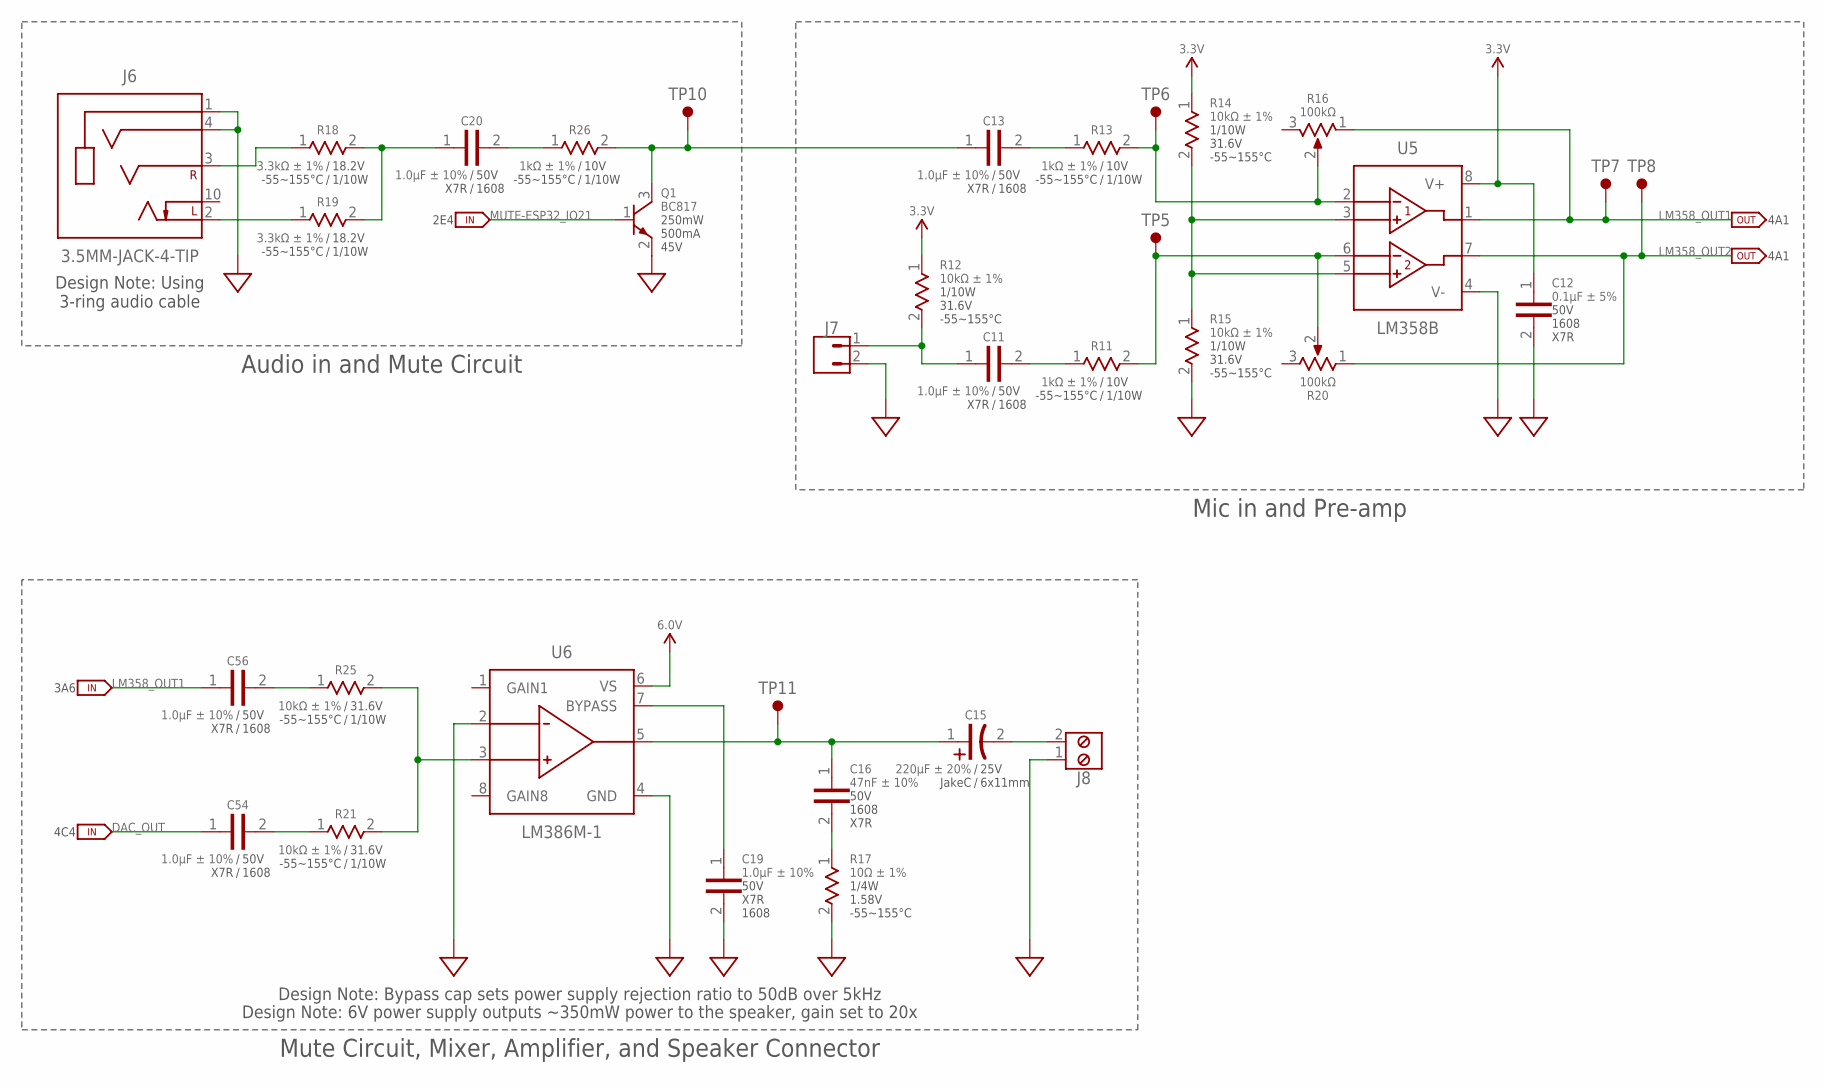
[picture p64: schematic Billy-Bass-Board v75.sch, sheet 3]

Parts:
C11, C13, C19, C20, C54, C56: 1.0µF ± 10%; 1608-SEM
C12: 0.1µF ± 5%; 1608-SEM
C15: 220µF ± 20%; 6X11-E-FLAT-REV
C16: 47nF ± 10%; 1608-SEM
J6: 3.5MM-JACK-4-TIP; SJ2-358940-SMT
J7: JST-XH-2; B2B-XH-A
J8: MPT-2-SCREW; MPT-0.5/2-2.54
Q1: BC817; SOT-23-3
R11, R13, R26: 1kΩ ± 1%; 1608-SEM
R12, R14, R15, R21, R25: 10kΩ ± 1%; 1608-SEM
R16, R20: 100kΩ; 3314J
R17: 10Ω ± 1%; 3216-SEM
R18, R19: 3.3kΩ ± 1%; 1608-SEM
TP5, TP6, TP7, TP8, TP10, TP11: TEST-POINT
U5: LM358B; D0008A-SOIC
U6: LM386M-1; D0008A-SOIC

Connections:
3.3V: C12.1, R12.1, R14.1, U5.8 (V+); also elsewhere on the board
6.0V: U6.6 (VS); also elsewhere on the board
AUX_LEFT: J6.2 (TIP), R19.1
AUX_MIXED: C20.1, R18.2, R19.2
AUX_MUTE: C13.1, Q1.3 (C), R26.2, TP10.TP
AUX_RIGHT: J6.3 (RING_1), R18.1
DAC_OUT: C54.1; also elsewhere on the board
GND: C12.2, C19.2, J6.1 (SLEEVE), J6.4 (RING_2), J7.2, J8.1, Q1.2 (E), R15.2, R17.2, U5.4 (V-), U6.2 (-INPUT), U6.4 (GND); also elsewhere on the board
LM358_IN1-: R13.2, R16.2, TP6.TP, U5.2 (IN1-)
LM358_IN2-: R11.2, R20.2, TP5.TP, U5.6 (IN2-)
LM358_IN+: R14.2, R15.1, U5.3 (IN1+), U5.5 (IN2+)
LM358_OUT1: C56.1, R16.1, TP7.TP, U5.1 (OUT1); also elsewhere on the board
LM358_OUT2: R20.1, TP8.TP, U5.7 (OUT2); also elsewhere on the board
LM386M_BYPASS: C19.1, U6.7 (BYPASS)
LM386M_IN+: R21.2, R25.2, U6.3 (+INPUT)
LM386M_OUT: C15.1, C16.1, TP11.TP, U6.5 (VOUT)
MIC+: C11.1, J7.1, R12.2
MUTE-ESP32_IO21: Q1.1 (B); also elsewhere on the board
unnamed: C54.2, R21.1
unnamed: C13.2, R13.1
unnamed: C20.2, R26.1
unnamed: C56.2, R25.1
unnamed: C11.2, R11.1
unnamed: C16.2, R17.1
SPEAKER+: C15.2, J8.2

Notes on the sheet:
Design Note: Using 3-ring audio cable
Mic in and Pre-amp
Mute Circuit, Mixer, Amplifier, and Speaker Connector
Design Note: 6V power supply outputs ~350mW power to the speaker, gain set to 20x
4A1
Design Note: Bypass cap sets power supply rejection ratio to 50dB over 5kHz
Audio in and Mute Circuit
2E4
4C4
3A6

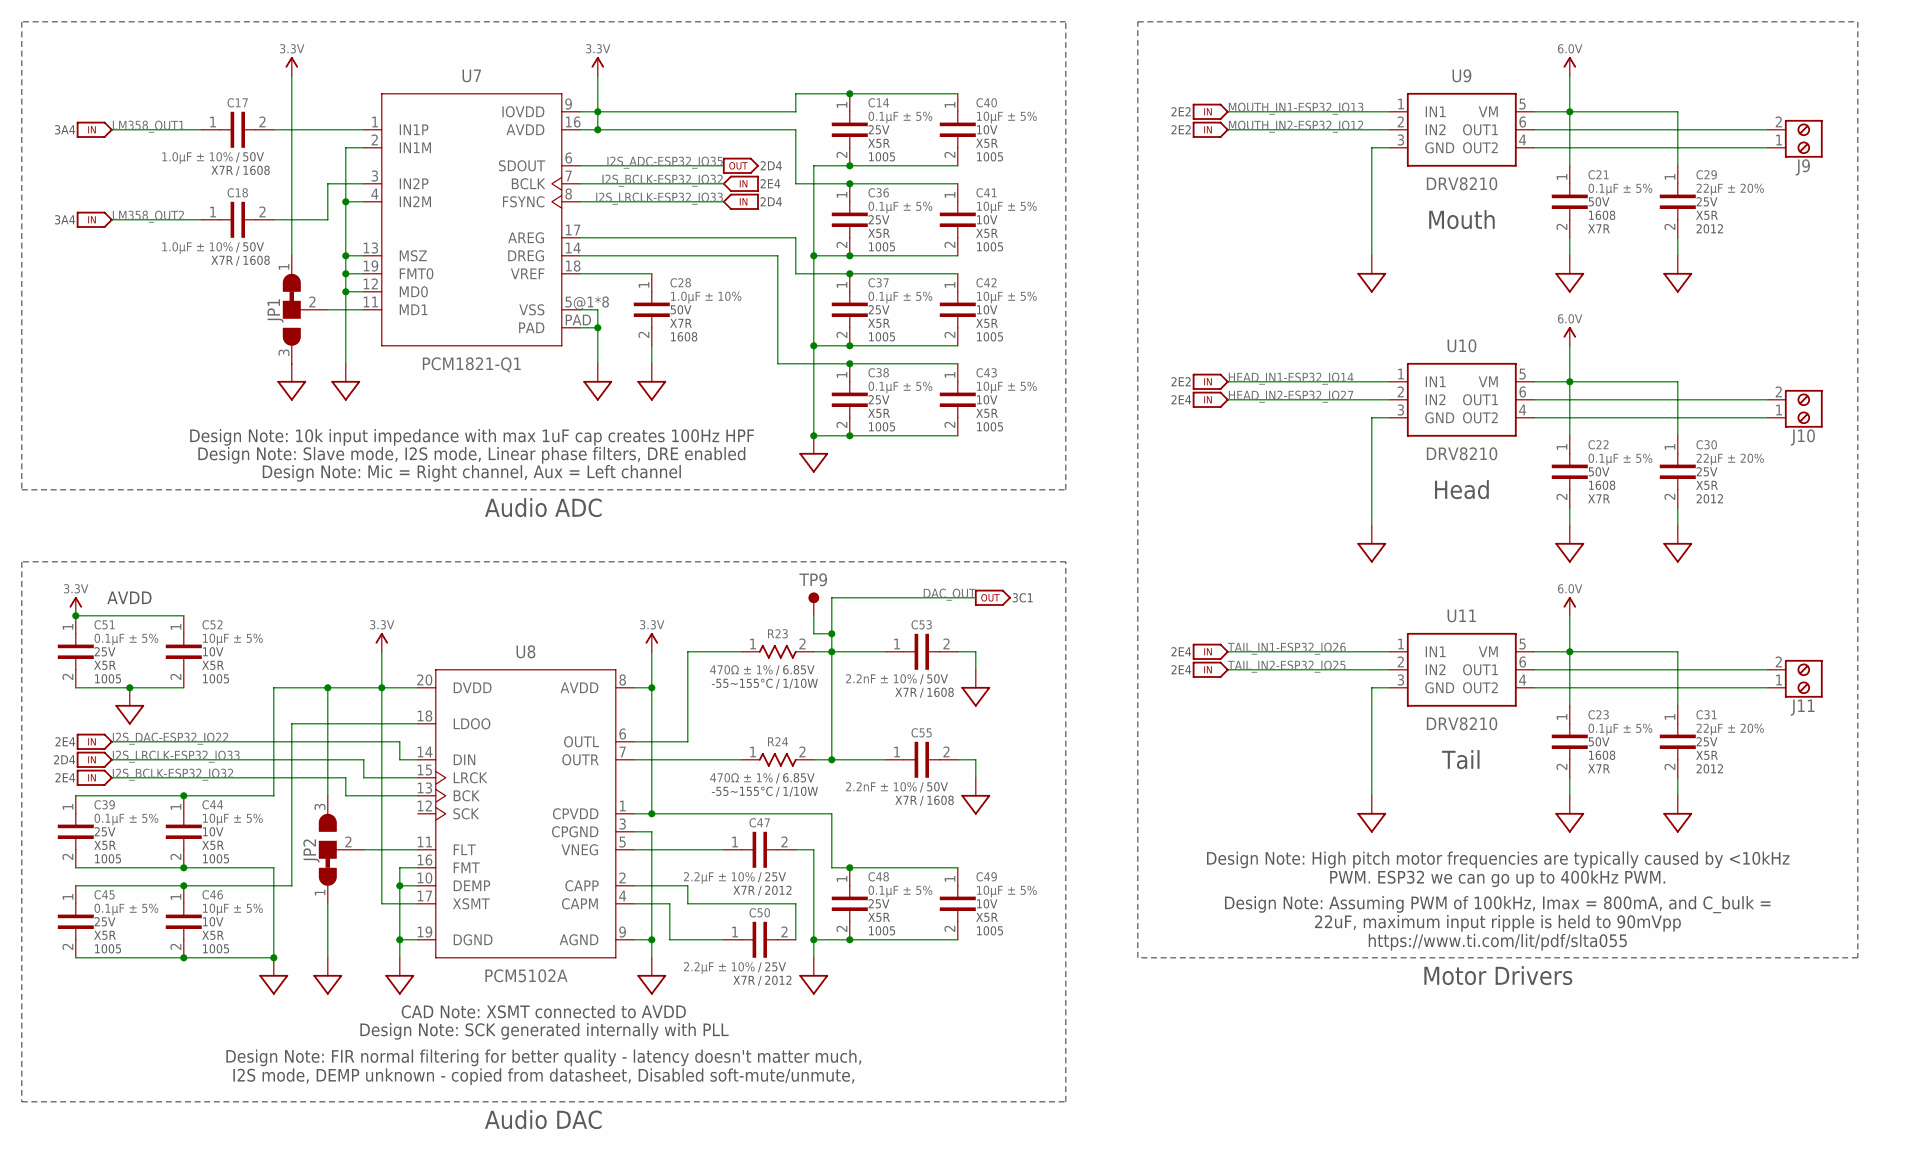
[picture p65: schematic Billy-Bass-Board v75.sch, sheet 4]

Parts:
C14, C36, C37, C38, C39, C45, C48, C51: 0.1µF ± 5%; 1005-SEM
C17, C18, C28: 1.0µF ± 10%; 1608-SEM
C21, C22, C23: 0.1µF ± 5%; 1608-SEM
C29, C30, C31: 22µF ± 20%; 2012-SEM
C40, C41, C42, C43, C44, C46, C49, C52: 10µF ± 5%; 1005-SEM
C47, C50: 2.2µF ± 10%; 2012-SEM
C53, C55: 2.2nF ± 10%; 1608-SEM
J9, J10, J11: MPT-2-SCREW; MPT-0.5/2-2.54
JP1, JP2: JUMPER-2-BRIDGED-1; JUMPER-PAD-2-BRIDGED-1
R23, R24: 470Ω ± 1%; 1608-SEM
TP9: TEST-POINT
U7: PCM1821-Q1; WQFN
U8: PCM5102A; TSSOP-20
U9, U10, U11: DRV8210; SOT563

Connections:
3.3V: C14.1, C36.1, C39.1, C40.1, C41.1, C44.1, C48.1, C49.1, C51.1, C52.1, JP1.1, JP2.3, U7.9 (IOVDD), U7.16 (AVDD), U8.1 (CPVDD), U8.8 (AVDD), U8.17 (XSMT), U8.20 (DVDD); also elsewhere on the board
6.0V: C21.1, C22.1, C23.1, C29.1, C30.1, C31.1, U9.5 (VM), U10.5 (VM), U11.5 (VM); also elsewhere on the board
DAC_OUT: C53.1, C55.1, R23.2, R24.2, TP9.TP; also elsewhere on the board
DRV82101_OUT1: J9.2, U9.6 (OUT1)
DRV82101_OUT2: J9.1, U9.4 (OUT2)
DRV82102_OUT1: J10.2, U10.6 (OUT1)
DRV82102_OUT2: J10.1, U10.4 (OUT2)
DRV82103_OUT1: J11.2, U11.6 (OUT1)
DRV82103_OUT2: J11.1, U11.4 (OUT2)
GND: C14.2, C21.2, C22.2, C23.2, C28.2, C29.2, C30.2, C31.2, C36.2, C37.2, C38.2, C39.2, C40.2, C41.2, C42.2, C43.2, C44.2, C45.2, C46.2, C47.2, C48.2, C49.2, C51.2, C52.2, C53.2, C55.2, JP1.3, JP2.1, U7.2 (IN1M), U7.4 (IN2M), U7.5@1 (VSS), U7.5@2 (VSS), U7.10@1 (VSS), U7.10@2 (VSS), U7.12 (MD0), U7.13 (MSZ), U7.15@1 (VSS), U7.15@2 (VSS), U7.19 (FMT0), U7.20@1 (VSS), U7.20@2 (VSS), U7.PAD, U8.3 (CPGND), U8.9 (AGND), U8.10 (DEMP), U8.16 (FMT), U8.19 (DGND), U9.3 (GND), U10.3 (GND), U11.3 (GND); also elsewhere on the board
HEAD_IN1-ESP32_IO14: U10.1 (IN1); also elsewhere on the board
HEAD_IN2-ESP32_IO27: U10.2 (IN2); also elsewhere on the board
I2S_ADC-ESP32_IO35: U7.6 (SDOUT); also elsewhere on the board
I2S_BCLK-ESP32_IO32: U7.7 (BCLK), U8.13 (BCK); also elsewhere on the board
I2S_DAC-ESP32_IO22: U8.14 (DIN); also elsewhere on the board
I2S_LRCLK-ESP32_IO33: U7.8 (FSYNC), U8.15 (LRCK); also elsewhere on the board
LM358_OUT1: C17.1; also elsewhere on the board
LM358_OUT2: C18.1; also elsewhere on the board
MOUTH_IN1-ESP32_IO13: U9.1 (IN1); also elsewhere on the board
MOUTH_IN2-ESP32_IO12: U9.2 (IN2); also elsewhere on the board
unnamed: JP1.2, U7.11 (MD1)
PCM1821_AREG: C37.1, C42.1, U7.17 (AREG)
PCM1821_DREG: C38.1, C43.1, U7.14 (DREG)
PCM1821_IN1P: C17.2, U7.1 (IN1P)
PCM1821_IN2P: C18.2, U7.3 (IN2P)
PCM1821_VREF: C28.1, U7.18 (VREF)
PCM5102A_CAPM: C50.1, U8.4 (CAPM)
PCM5102A_CAPP: C50.2, U8.2 (CAPP)
PCM5102A_FLT: JP2.2, U8.11 (FLT)
PCM5102A_LDOO: C45.1, C46.1, U8.18 (LDOO)
PCM5102A_OUTL: R23.1, U8.6 (OUTL)
PCM5102A_OUTR: R24.1, U8.7 (OUTR)
PCM5102A_VNEG: C47.1, U8.5 (VNEG)
TAIL_IN1-ESP32_IO26: U11.1 (IN1); also elsewhere on the board
TAIL_IN2-ESP32_IO25: U11.2 (IN2); also elsewhere on the board

Notes on the sheet:
Design Note: Assuming PWM of 100kHz, Imax = 800mA, and C_bulk = 22uF, maximum input ripple is held to 90mVpp https://www.ti.com/lit/pdf/slta055
Mouth
Head
Tail
2E2
2E4
Audio ADC
Design Note: Mic = Right channel, Aux = Left channel
Design Note: Slave mode, I2S mode, Linear phase filters, DRE enabled
Design Note: 10k input impedance with max 1uF cap creates 100Hz HPF
2D4
Motor Drivers
3A4
Design Note: High pitch motor frequencies are typically caused by <10kHz PWM. ESP32 we can go up to 400kHz PWM.
CAD Note: XSMT connected to AVDD
Design Note: FIR normal filtering for better quality - latency doesn't matter much, I2S mode, DEMP unknown - copied from datasheet, Disabled soft-mute/unmute,
Design Note: SCK generated internally with PLL
AVDD
Audio DAC
3C1

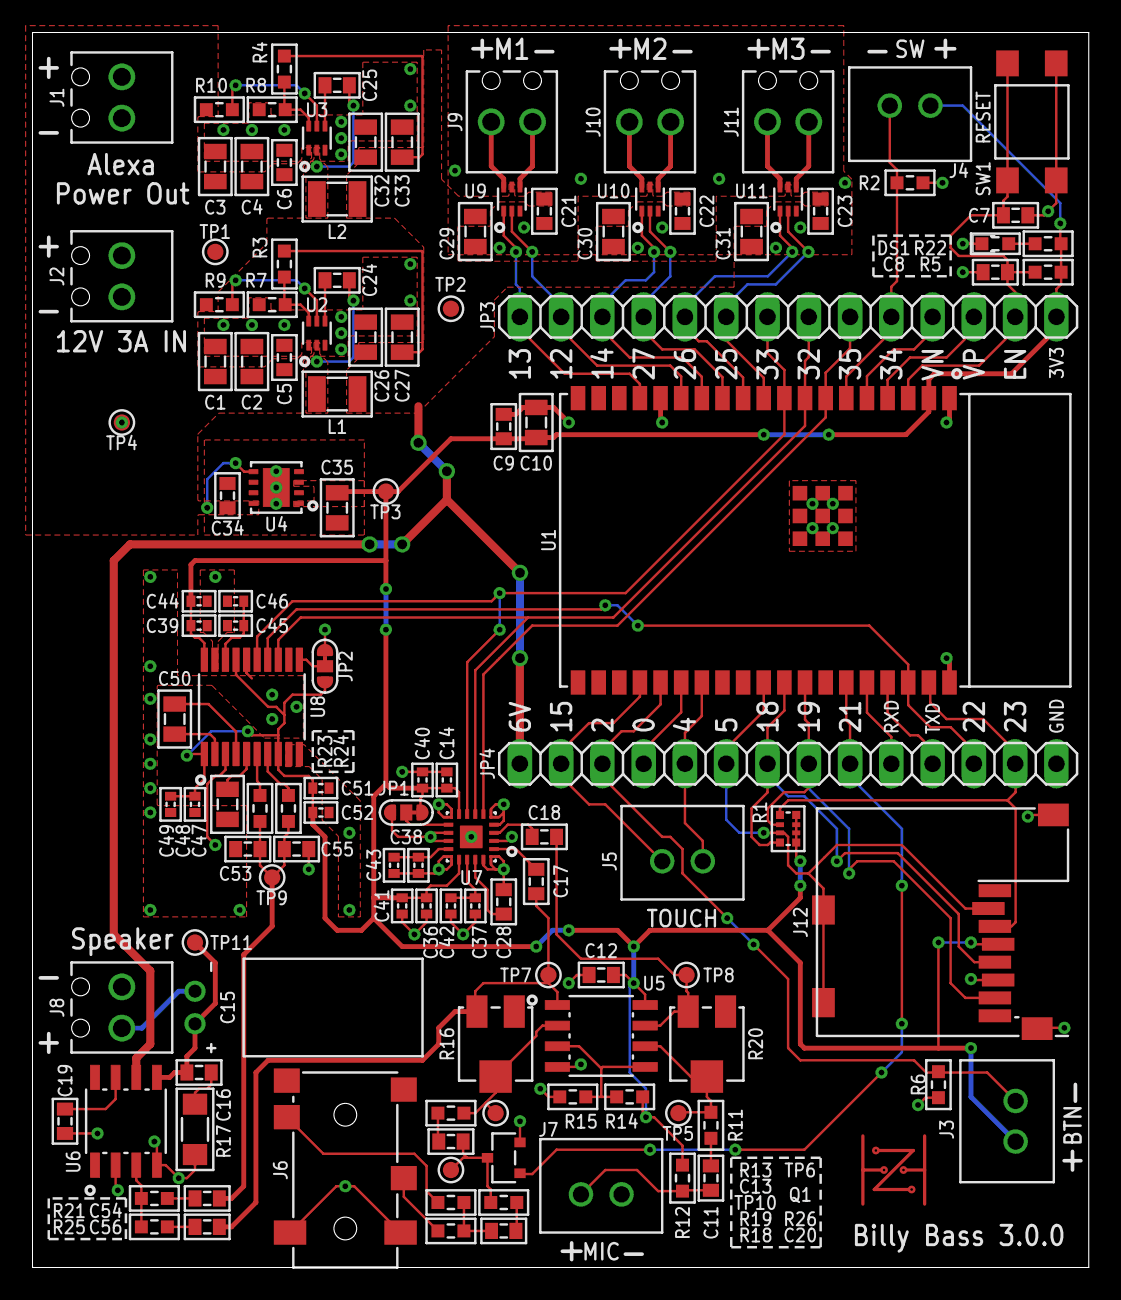
[picture p66: board Billy-Bass-Board v96.brd from above]

Board: 2 copper layers, 65.0 x 76.0 mm, 126 parts (0 on the bottom side), 78 nets.
