ZackHarrington/PCB-Projects/Christmas-Snow-Globe/Design-Files/Christmas-Snow-Globe v16.brd

## EAGLE design Christmas-Snow-Globe/Design-Files/Christmas-Snow-Globe v16.brd (2024-10-13)

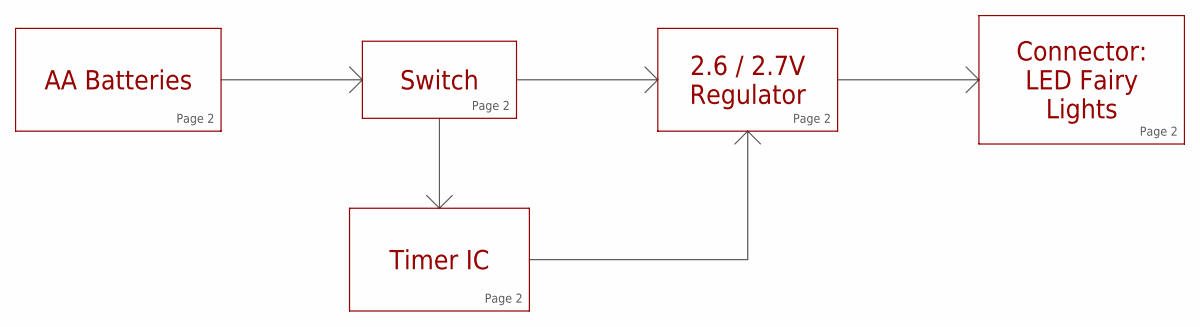
[picture p67: schematic Christmas-Snow-Globe v21.sch, sheet 1]

Notes on the sheet:
Switch
AA Batteries
Timer IC
Connector: LED Fairy Lights
2.6 / 2.7V Regulator
Page 2
