ZackHarrington/PCB-Projects/Christmas-Snow-Globe/Design-Files/Christmas-Snow-Globe v16.brd

## EAGLE design Christmas-Snow-Globe/Design-Files/Christmas-Snow-Globe v16.brd (continued)

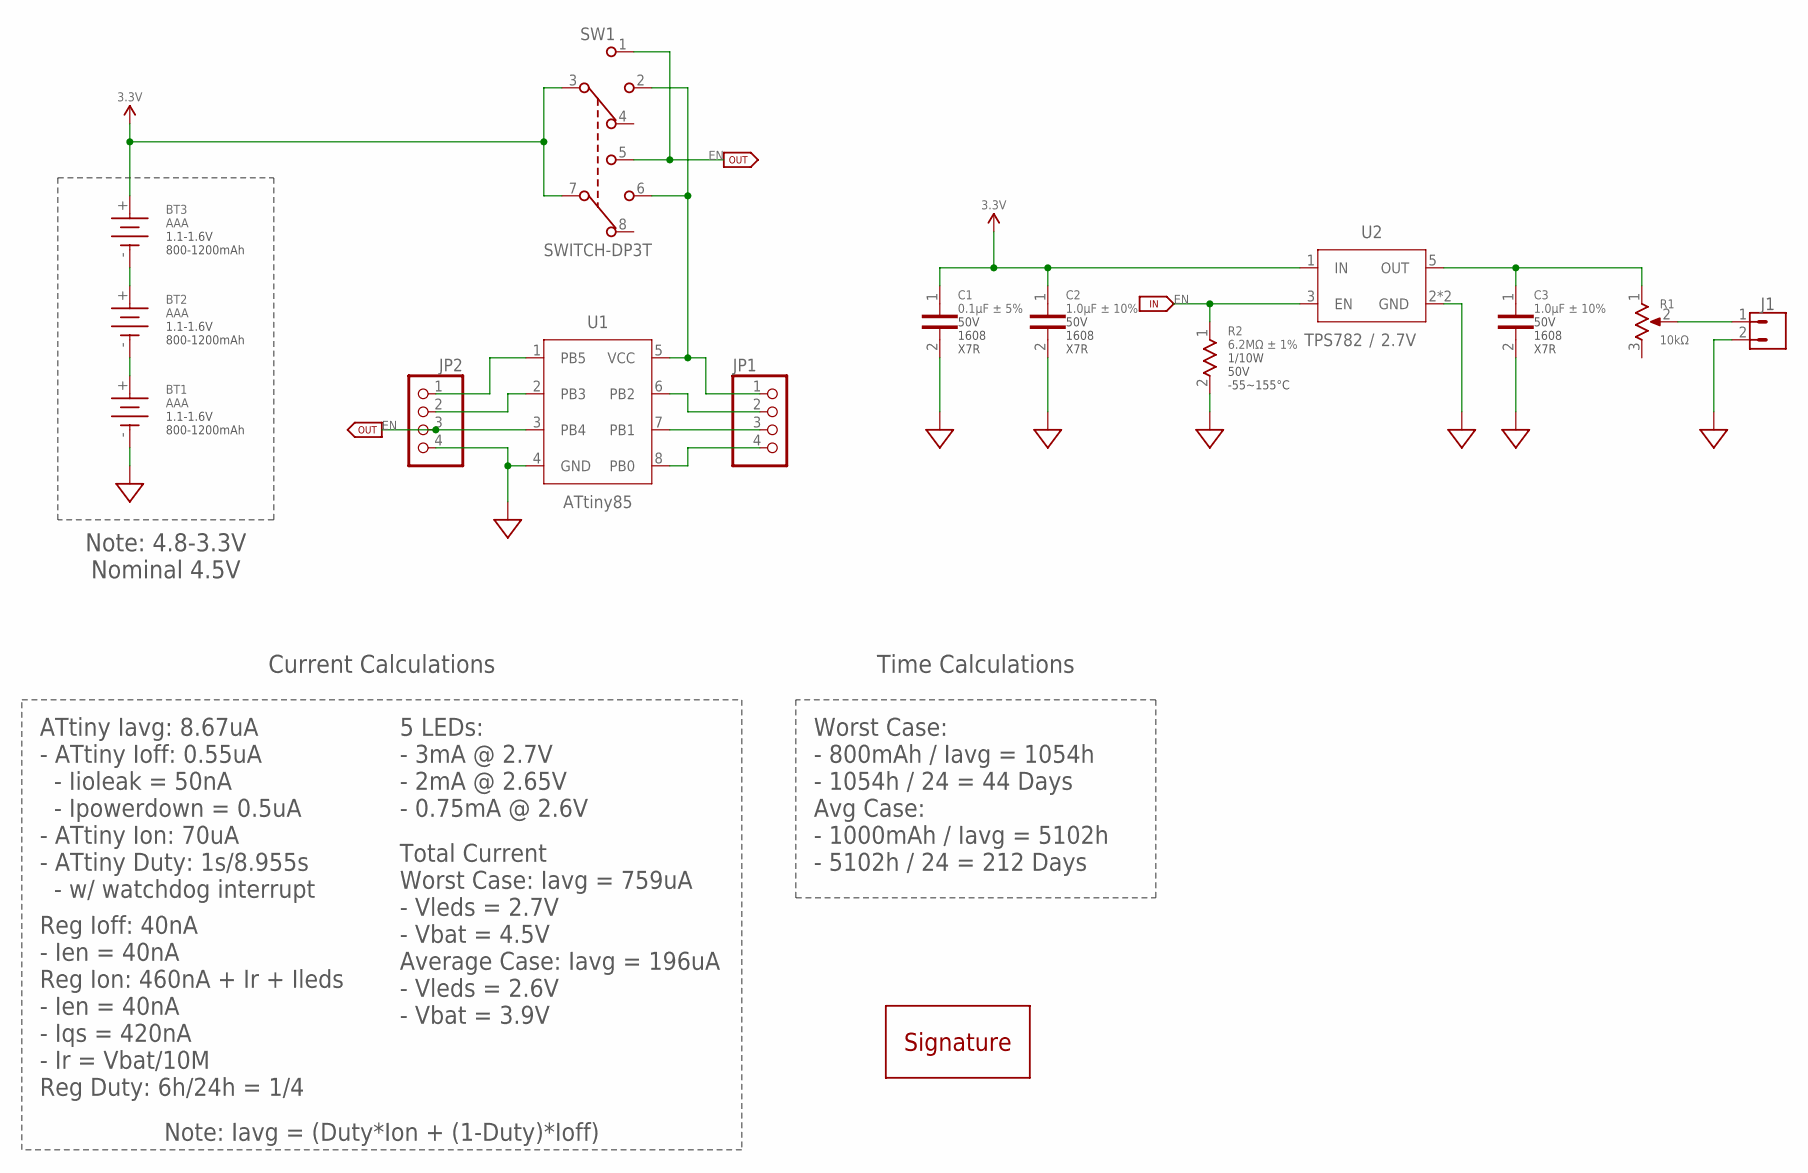
[picture p68: schematic Christmas-Snow-Globe v21.sch, sheet 2]

Parts:
BT1, BT2, BT3: AAA; AAA-CONTACTS
C1: 0.1µF ± 5%; 1608-SEM
C2, C3: 1.0µF ± 10%; 1608-SEM
J1: JST-PH-2; B2B-PH-K-S
JP1, JP2: PINHD-1X4; 1X04
R1: 10kΩ; 3314J
R2: 6.2MΩ ± 1%; 1608-SEM
SW1: SWITCH-DP3T; EG2301
U1: ATtiny85; 8P3-PDIP
U2: TPS782; SOT-23-5
U$14: SIGNATURE

Connections:
3.3V: BT3.+, C1.1, C2.1, SW1.3, SW1.7, U2.1 (IN)
EN: JP2.3, R2.1, SW1.1, SW1.5, U1.3 (PB4), U2.3 (EN)
GND: BT1.-, C1.2, C2.2, C3.2, J1.2, JP2.4, R2.2, U1.4 (GND), U2.2 (GND), U2.4 (GND)
LEDS+: J1.1, R1.2
unnamed: BT2.+, BT3.-
unnamed: BT1.+, BT2.-
PB0: JP1.4, U1.8 (PB0)
PB1: JP1.3, U1.7 (PB1)
PB2: JP1.2, U1.6 (PB2)
PB3: JP2.2, U1.2 (PB3)
PB5: JP2.1, U1.1 (PB5)
TIMER: JP1.1, SW1.2, SW1.6, U1.5 (VCC)
TPS782_OUT: C3.1, R1.1, U2.5 (OUT)

Notes on the sheet:
Note: 4.8-3.3V Nominal 4.5V
Current Calculations
ATtiny Iavg: 8.67uA - ATtiny Ioff: 0.55uA - Iioleak = 50nA - Ipowerdown = 0.5uA - ATtiny Ion: 70uA - ATtiny Duty: 1s/8.955s - w/ watchdog interrupt
5 LEDs: - 3mA @ 2.7V - 2mA @ 2.65V - 0.75mA @ 2.6V
Reg Ioff: 40nA - Ien = 40nA Reg Ion: 460nA + Ir + Ileds - Ien = 40nA - Iqs = 420nA - Ir = Vbat/10M Reg Duty: 6h/24h = 1/4
Total Current Worst Case: Iavg = 759uA - Vleds = 2.7V - Vbat = 4.5V Average Case: Iavg = 196uA - Vleds = 2.6V - Vbat = 3.9V
Note: Iavg = (Duty*Ion + (1-Duty)*Ioff)
Time Calculations
Worst Case: - 800mAh / Iavg = 1054h - 1054h / 24 = 44 Days Avg Case: - 1000mAh / Iavg = 5102h - 5102h / 24 = 212 Days

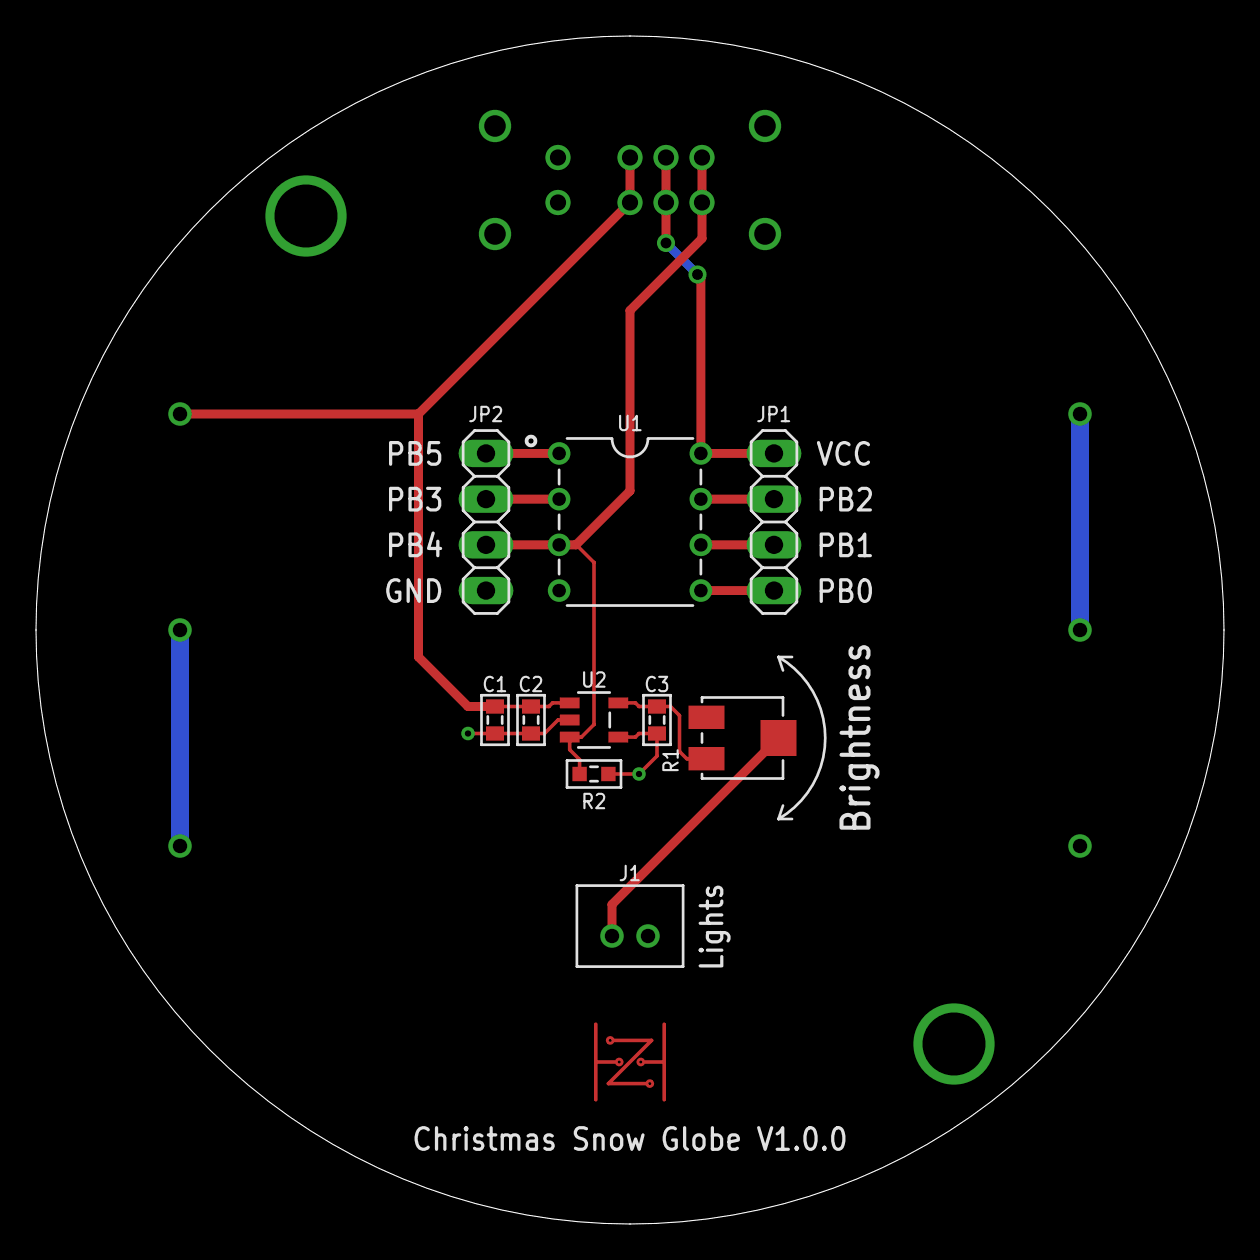
[picture p69: board Christmas-Snow-Globe v16.brd from above]

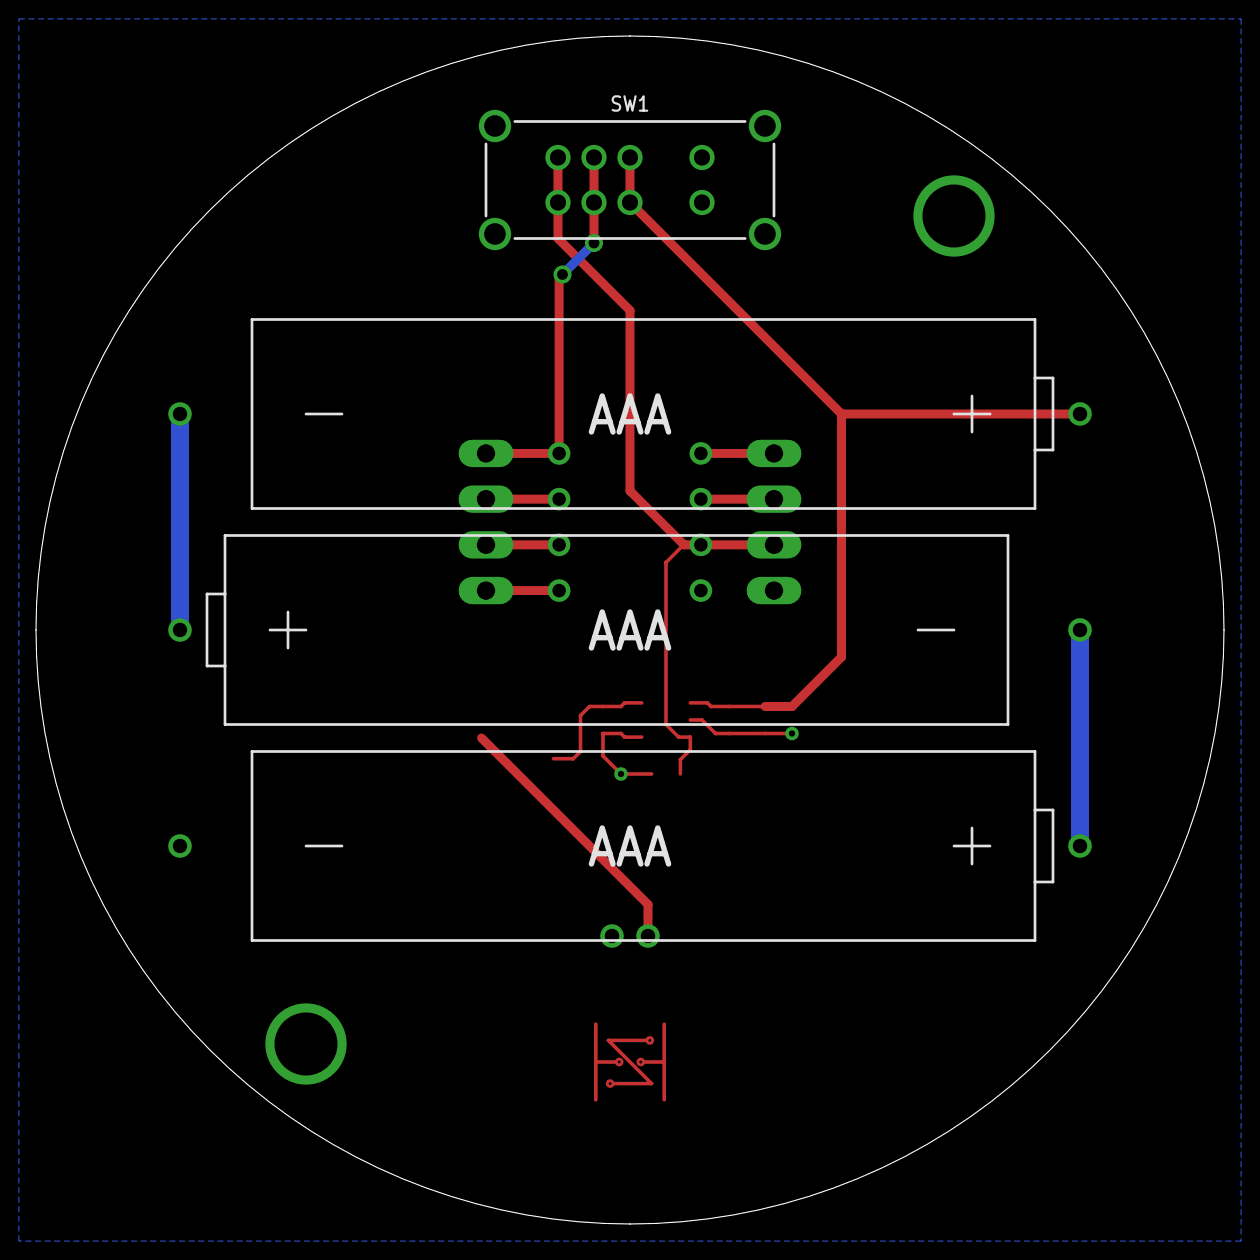
[picture p70: board Christmas-Snow-Globe v16.brd from below]

Board: 2 copper layers, 66.0 x 66.0 mm, 15 parts (4 on the bottom side), 13 nets.
