ZackHarrington/PCB-Projects/(commit log)

2023-04-29 Adding all current project files and libraries
    [BillyBassShield.brd, BillyBassShield.sch, PhotoVideoFrame.brd, PhotoVideoFrame.sch]
2023-06-04 Updated gitignore for gerber files
2023-06-04 Finished Billy Bass Board V2.0.0
    [BillyBassBoard.brd, BillyBassBoard.sch, BillyBassShield.brd, BillyBassShield.sch]
2023-06-10 Updated files to match parts purchased
    [BillyBassBoard.brd, BillyBassBoard.sch]
2024-01-09 Few new projects. Migration of all updated projects and libraries to Fusion 360 Elecronics
    [BillyBassBoard.brd, BillyBassBoard.sch, BillyBassBoard_2.0.0.brd, BillyBassBoard_2.0.0.sch, Christmas-Snow-Globe v33.f3z, Christmas-Snow-Globe_Battery_Cover.stl, Christmas-Snow-Globe_Stand_Bottom.stl, Christmas-Snow-Globe_Stand_Top.stl]
2024-03-21 Billy Bass Board v3.0.0 Update
    [BillyBassBoard.brd, BillyBassBoard.sch, BillyBassBoard_2.0.0.brd, BillyBassBoard_2.0.0.sch, Christmas-Snow-Globe v33.f3z, Christmas-Snow-Globe_Battery_Cover.stl, Christmas-Snow-Globe_Stand_Bottom.stl, Christmas-Snow-Globe_Stand_Top.stl]
2024-03-22 Updated Billy-Bass-Board README
    [BillyBassBoard_2.0.0.brd, BillyBassBoard_2.0.0.sch]
2024-03-22 Updated Billy-Bass-Board README grammar
2024-10-13 Edited .gitignore for migration to KiCAD
2024-10-13 Migrated libraries to KiCAD and started testing a new chess board project
    [Billy-Bass-Board v75.sch, Billy-Bass-Board v96.brd, Christmas-Snow-Globe v16.brd, Christmas-Snow-Globe v21.sch, LED-Chess-Test-Board.kicad_pcb, LED-Chess-Test-Board.kicad_sch, LED-Test-Board v13.sch, LED-Test-Board v16.brd]
2024-12-28 Added Greek Keyboard Project
    [Case-Bottom.stl, Case-Top.stl, Greek-Keyboard-LEDs.kicad_sch, Greek-Keyboard-Matrix.kicad_sch, Greek-Keyboard.blend, Greek-Keyboard.kicad_pcb, Greek-Keyboard.kicad_sch]
